ok1hra/oi3/README.md

# Open Interface III

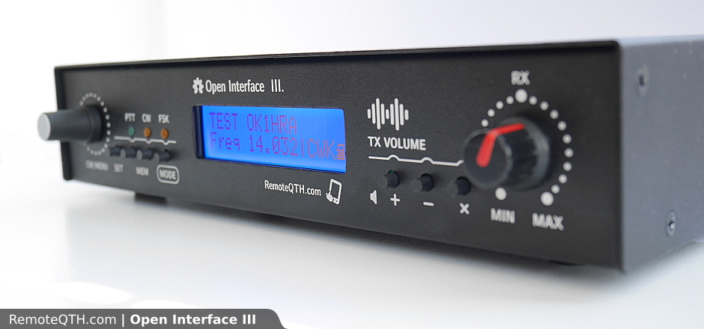
[picture p1: oi3.png]
Open Interface III


Firmware for **Open Interface III** — a station interface between PC and an
Icom-family transceiver (CAT, PTT/sequencer, CW/RTTY/FSK keying, optional
Ethernet/TrxNet networking). This document describes what the firmware
does, how the front-panel UI works, and what every menu item / config key
means.

> For the hardware itself (front/rear panel layout, DB25 wiring,
> schematics, jumpers, per-rig connector diagrams), see
> [doc/open-interface-iii.md](doc/open-interface-iii.md) — linked again at
> the bottom of this document.

## Contents

- [First boot](#first-boot)
- [Display](#display)
  - [Row 0 — menu / value / mode](#row-0--menu--value--mode)
  - [Row 1 — keyer TX echo + transient overlays](#row-1--keyer-tx-echo--transient-overlays)
- [Buttons](#buttons)
  - [Auto-repeat](#auto-repeat)
  - [Tones](#tones)
- [Menu navigation (FSM)](#menu-navigation-fsm)
  - [MODE button](#mode-button)
- [Menu items](#menu-items)
  - [RPI status](#rpi-status)
- [CI-V (Icom CAT)](#ci-v-icom-cat)
  - [CW over CI-V (CIV_CW_VIA_CIV)](#cw-over-ci-v-civ_cw_via_civ)
- [Kenwood CAT (TS-480)](#kenwood-cat-ts-480)
- [PTT, sequencer and interlock](#ptt-sequencer-and-interlock)
  - [Outputs](#outputs)
  - [Mode → output mapping](#mode--output-mapping)
  - [Sequencer timing](#sequencer-timing)
  - [Inputs](#inputs)
  - [Input-debug overlay](#input-debug-overlay)
  - [InterlockEnable=1 (safety mode)](#interlockenable1-safety-mode)
  - [InterlockEnable=0 (PTT-in mode)](#interlockenable0-ptt-in-mode)
- [Keyer (K3NG-derived, CW + RTTY/FSK)](#keyer-k3ng-derived-cw--rttyfsk)
  - [Paddle behaviour](#paddle-behaviour)
  - [PTT timing](#ptt-timing)
  - [CW decoder (paddle → LCD row 1)](#cw-decoder-paddle--lcd-row-1)
  - [TrxNet remote CW](#trxnet-remote-cw)
  - [Remote CW key server (Paddle2IP)](#remote-cw-key-server-paddle2ip)
  - [RTTY / FSK output](#rtty--fsk-output)
  - [Persistence](#persistence)
- [TrxNet (peer-to-peer LAN)](#trxnet-peer-to-peer-lan)
- [Ethernet](#ethernet)
- [SD card and `oi3.cfg`](#sd-card-and-oi3cfg)
- [EEPROM map](#eeprom-map)
- [Build / flash](#build--flash)
- [Hardware reference](#hardware-reference)

---

## First boot

Power-up sequence on the 16×2 LCD:

1. `FW <date>` banner (~0.5 s).
2. SD card status on row 1 — `loaded oi3.cfg`, `SD card missing`, or
   `SD init fail`. Missing SD just means the firmware boots with compiled
   defaults; nothing is broken.
3. If an Ethernet module is fitted: `Net-ID: NN` / `Eth: waiting…`, then
   either the assigned `IP address:` for ~1 s, or `Eth: no link` /
   `DHCP fail`.
4. Runtime view appears on row 0. Whatever menu item was active when you
   last powered off is restored (persisted in EEPROM). Row 1 is reserved
   for keyer TX text and transient WPM notifications.

The boot default CI-V mode is **CW** (0x03). As soon as the rig answers
CI-V polls, the rig's real mode takes over.

---

## Display

The display is a 16×2 character LCD. The two rows have separate jobs.

### Row 0 — menu / value / mode

```
HHHHHHHHHHHH|MMM
└─ value ──┘│└mode┘
         separator
```

- **Value field** (12 chars) — left-aligned, content depends on the
  current menu item (see [Menu items](#menu-items)).
- **Separator** (1 char) — encodes the menu FSM state:
  - `|` PINNED — value is displayed; DWN/UP edit live WPM.
  - `:` PINNED, and a Paddle2IP remote key is connected (`IPkey CONN`)
    with the rig in CW/CW-R — ready to be keyed remotely.
  - `<` BROWSING — DWN/UP step through menu items.
  - `=` EDITING — DWN/UP change the value of the current item.
- **Mode field** (3 chars) — current CI-V mode, **uppercase** when CI-V
  is alive (`LSB USB AM  CW  RTY FM  CWR RTR`), **lowercase** when the
  rig is silent and the value is the local fallback driven by the MODE
  button. `---` is shown only as a safety fallback if the mode byte is
  unknown.

### Row 1 — keyer TX echo + transient overlays

- During CW/RTTY transmission, every element that actually went on the
  air is echoed here (wrap mode — when col 16 is reached the row is
  cleared and writing restarts at col 0). Trailing spaces at the wrap
  edge are eaten so the row never starts with a space.
- Pressing DWN/UP in PINNED state changes WPM and briefly overlays
  `WPM NN` here for ~0.8 s — keyer chars from that window are dropped
  *from the LCD only* (the air output continues unaffected).
- The paddle decoder writes its decoded ASCII here too — so the LCD is
  a truthful log of what was keyed, whether by paddle, by USB host, or
  by a remote TrxNet peer.
- On SD / Ethernet boot stages, row 1 hosts the status banners.

---

## Buttons

Five physical inputs drive the UI:

| Button | Pin | Notes |
|---|---|---|
| SET | A1 (ADC) | Enter/leave BROWSING; long-press in BROWSING = EDIT  |
| DWN | A1 (ADC) | Decrement / previous item |
| UP | A1 (ADC) | Increment / next item |
| MODE | D36 | Rotate CI-V mode locally (only when CI-V is silent)  |
| FootSW | D19 | External PTT request (LOW = TX) |

SET / DWN / UP share one analog pin via a resistor divider. Decision
levels are the midpoints between measured raw ADC values (SET≈2,
DWN≈89, UP≈167):

| Button | Raw range |
|---|---|
| SET | `tmp < 46` |
| DWN | `46 < tmp < 128` |
| UP | `128 < tmp < 230` |

### Auto-repeat

In PINNED and EDITING states, holding DWN or UP for ≥700 ms starts a
3 Hz auto-repeat. BROWSING is **edge-only** — one menu step per press,
no auto-repeat (so you can't accidentally fly past the item you want).

### Tones

A short two-step tone sweep marks **BROWSING ↔ EDITING** transitions only:

- low → high (300 → 800 Hz) entering EDITING
- high → low (800 → 300 Hz) leaving EDITING (after save)

No tones for PINNED↔BROWSING, DWN/UP steps, or MODE rotation. The tone
generator (D4) is shared with the keyer sidetone with no mutex —
overlap is rare in practice and audibly harmless.

---

## Menu navigation (FSM)

The menu has three states. Only the SET button changes state; DWN/UP do
different things depending on which state you're in.

```
        ┌───────────────────────────────────────────┐
        │                                           │
        ▼                                           │
   ┌─────────┐  any SET   ┌────────────┐ short SET  │
   │ PINNED  │ ─────────► │  BROWSING  │────────────┘
   │   '|'   │            │    '<'     │  (or 30 s idle)
   │ DWN/UP  │            │ DWN/UP=    │
   │ = WPM   │            │ prev/next  │ long SET
   │ ± live  │            │            │ (if editable)
   └─────────┘            └────────────┘
                                 ▲ │
                       any SET   │ │
                       (save +   │ │
                        sweep)   │ ▼
                            ┌────────────┐
                            │  EDITING   │
                            │    '='     │
                            │  DWN/UP =  │
                            │  value ±   │
                            └────────────┘
```

Key rules:

- **Short vs. long SET** only matters in BROWSING. Long-press threshold
  is 800 ms; long-press in PINNED or EDITING has no special meaning.
- **PINNED → BROWSING** fires on the SET press edge.
- **BROWSING → PINNED** fires on the SET release edge **and persists the
  current menu index to EEPROM** (so the unit boots back into the same
  view).
- **BROWSING → PINNED** also happens automatically after **30 s of no
  button activity** in BROWSING — same EEPROM save. You can't get
  stranded inside the menu.
- **BROWSING → EDITING** fires on the long-press threshold while still
  held, but only if the current item is editable.
- **EDITING → BROWSING** saves the new value (to EEPROM for persisted
  items) and plays the high→low sweep. There is no cancel path — once
  you press SET in EDITING, the change is committed.
- Read-only items render a space between name and value; editable items
  in BROWSING/EDITING render `=` instead, as a visual hint that
  long-press will start editing.

### MODE button

`MODE` rotates the active CI-V mode locally through the cycle
`LSB → USB → AM → CW → RTY → FM → CWR → RTR → LSB`.

It is **only active while CI-V is silent** (`!CivValid`). Once the rig
is answering polls, the rig is the source of truth — pressing MODE
does nothing. This lets you operate sensibly with the rig powered off
(set CW to use the keyer dry, set RTY to route PTT to the DAT jack for
AFSK from the PC, etc.) without ever lying about the rig's real state.

---

## Menu items

27 items, indexed 0..26. Items 0..6, 23, 25 and 26 are read-only status; 7 is
browse-only (peer list); 8..22 and 24 are editable settings. The mode cell
on the right of row 0 is the same on every item. Items 25 and 26 also take
over row 1 while they are selected. Item 26 is skipped while browsing until
a WIFILT Raspberry Pi has been heard from.

| #  | Name | Example display | Editable | Range / values | Purpose |
|----|---|---|---|---|---|
| 0  | My call | `OK1HRA` | no | — (from cfg) | Operator callsign, set in `oi3.cfg`. |
| 1  | FW version | `FW 20260526` | no | — (compile-time) | Build date stamp. |
| 2  | IP high | `192.168.` | no | — / `no link` | First two octets of the assigned IP. |
| 3  | IP low | `1.220` | no | — / `no link` | Last two octets. Items 2+3 together = full IP. |
| 4  | Baud (CAT) | `baud 9600` | no | — (from cfg) | Serial2 baudrate used for CI-V. |
| 5  | CI-V addr | `CI-V 0x98` / `KENWOOD` | no | — (from cfg) | Configured radio address (0x98=IC-7610, 0x56=IC-746); `KENWOOD` with `BAND_DECODER_IN=2`. |
| 6  | Frequency | `14.074.0 kHz` | no | — / `---.---.- kHz` | Live rig frequency, 100 Hz resolution. Placeholder while `!CivValid`. |
| 7  | Peers | `Peers 2` / `Peers off` | browse | EDITING = walk peer list | Number of remote TrxNet peers, EDITING cycles through them showing `name .lastIP`. Priority peers (on `PriorityPrefixes`) show `*` instead of the `.` in the name (`705*01`). `off` = NET_ID=0 / no Eth. |
| 8  | Interlock | `Inter 1` | yes (not persisted) | 0 ↔ 1 | `1` = D2 is PA safety interlock; `0` = D2 is external PTT-in. See [PTT, sequencer and interlock](#ptt-sequencer-and-interlock). |
| 9  | SEQ lead | `SeqH 0ms` | yes (not persisted) | 0..9990 ms step 10 | Delay from SEQUENCER HIGH to PTTPA HIGH. |
| 10 | PA lead | `PAH 10ms` | yes (not persisted) | 0..9990 ms step 10 | Delay from PTTPA HIGH to PTT1/2/3 HIGH. |
| 11 | PTT lead | `PTTH 10ms` | yes (not persisted) | 0..9990 ms step 10 | Loaded from cfg, **currently unused** by the sequencer (kept for forward compat). |
| 12 | PTT tail | `PTTL 210ms` | yes (not persisted) | 0..9990 ms step 10 | Delay after TX-off before PTT1/2/3 LOW. |
| 13 | PA tail | `PAL 0ms` | yes (not persisted) | 0..9990 ms step 10 | Delay from PTT1/2/3 LOW to PTTPA LOW. |
| 14 | SEQ tail | `SeqL 0ms` | yes (not persisted) | 0..9990 ms step 10 | Delay from PTTPA LOW to SEQUENCER LOW. |
| 15 | PTT output | `PTT1` / `TX PTT3` / `PTT D3` | yes (not persisted) | 1, 2, 3 | Effective PTT pin for the **current CI-V mode**. `D3`=default output 3 is used (no mapping / CI-V silent), `TX `=sequencer active. Edit changes the per-mode slot in RAM (CI-V silent: `PTTmodeDefault`); `oi3.cfg` repopulates after reset. While editing, holding MODE keys the selected output for test — see [PTT output test](#ptt-output-test). The right edge of the value field also shows a live input-debug triplet `FIP` — see [Input-debug overlay](#input-debug-overlay). |
| 16 | WPM | `WPM 28` | yes | 5..50 step 1 | Keyer speed. Also editable via DWN/UP in PINNED. |
| 17 | Iambic mode | `Mode B` | yes | A ↔ B | Iambic A or B. |
| 18 | Paddle | `Pad N` / `Pad R` | yes | Normal ↔ Reverse | Swap dit/dah paddle assignment. |
| 19 | Sidetone | `Side 600Hz` / `Side off` | yes | 0 (off) or 300..1200 Hz step 10 | Keyer sidetone frequency. Crosses 300↔0 boundary. |
| 20 | RTTY baud | `RTY 45.45 Bd` | yes | 45, 50, 75, 100 | FSK Baudot rate (45 stored as 45 but clocked at 45.45 Bd). |
| 21 | FSK polarity  | `FSK N` / `FSK R` | yes | Normal ↔ Reverse | Invert MARK/SPACE drive levels on the FSK pin. |
| 22 | Debug | `Debug off` | yes (not persisted) | on ↔ off | Enable verbose serial logging (`[CIV freq=…]`, `[PTT…]`, etc). Off by default; init banners and errors always print. |
| 23 | UDP port | `UDP 5683` / `no net` | no | — (from cfg) | TrxNet UDP port (`UdpPort` in `oi3.cfg`). `no net` on boards without the network stack. |
| 24 | PTT output | `PTTout on` / `PTTout off` | yes (not persisted) | on ↔ off | PTT outputs enabled; always on after reboot. |
| 25 | Remote key | `IPkey CONN` / `IPkey DISC` / `IPkey off` | no | — | Remote CW key server link: `CONN` = a Paddle2IP session is sending (packet < 1 s ago, valid nonce), `DISC` = no client, `off` = `RkeyEnable=0` or no `RkeyKey`. While selected, **row 1** shows the elements actually played on CW1/CW2, newest on the right: `.` / `-` by mark length at the sender's WPM, space = letter gap, ` / ` = word gap, `*` = mark cut by an abort (link loss, interlock, …). Example: `-.-. --.- / -.-`. The keyer TX echo is paused on row 1 meanwhile. See [doc/remote-cw-key.md](doc/remote-cw-key.md). |
| 26 | RPI | `▂-62 Domov 🔒` / `RPI wait` | no | — | State of the Raspberry Pi running WIFILT + local-trx with this OI3 (TrxNet `/wl-host`). Uses **both rows** — see [RPI status](#rpi-status). |

### RPI status

Menu item 26 shows the state of a headless Raspberry Pi that runs WIFILT and
local-trx with this OI3 as local-trx's CAT/CW/PTT, so its state can be read
without a screen or a browser. WIFILT sends it over TrxNet (`/wl-host`, every
5 s and on every change, see TrxNet INTEGRATION.md §7.4); the OI3 stores
nothing.

```
 0123456789AB | MMM
 B-62 Domov L | USB    row 0: signal, dBm, SSID, lock
 192.168.1.23     H    row 1: the address to open in a browser, H = pulse
```

Row 0 (value field):

- col 0: signal bars (three levels), the AP mast when the Pi runs its setup
  hotspot, `?` when the data is more than 15 s old, blank when wired only;
- cols 1..3: dBm of the WiFi link, `AP ` in hotspot mode, `ETH` wired only;
- cols 5..10: the SSID (the hotspot's own name in AP mode), scrolling when
  longer than six characters;
- col 11: the lock. **Closed lock** (solid body, steady) = the Pi's file system
  is locked (fslock). **Open lock** (lifted shackle, hollow body, **blinking**)
  = fslock is installed but the system is unlocked. Blank = no fslock.

Row 1: the IP address, with a heart in the last column for 0.3 s after each
packet. When something is wrong it says so instead, with a running clock:

| Row 1 | Meaning |
|---|---|
| `waiting for RPI` | nothing heard since this OI3 started |
| `UPDATE 45%` | a web update is running; `UPDATE  1:20` while the Pi is dark during it |
| `RESTART 0:07`  | WIFILT is restarting itself (Save & Restart) |
| `WIFILT STOP 0:12`| the WIFILT service was stopped |
| `RPI REBOOT 0:45` | the Pi is rebooting or shutting down |
| `RPI OFFLINE 3:05`| no packet for 15 s (3 min after a restart/reboot, 10 min during an update) |
| `local-trx off` / `TRX not linked` | alternate with the address every 2 s: local-trx is gone from TrxNet / WIFILT's radio slot to local-trx is not connected |

CW or RTTY text sent by the keyer still appears on row 1: the first
character replaces the Pi's state, and the state comes back 2 s after the
transmission ends (PTT down, nothing queued). WPM and TUNE overlays keep
priority as on every other item.

Items 16..21 are persisted to EEPROM on the EDITING→BROWSING transition.
Items 7, 8..15 and 22 are intentionally **not** persisted — sequencer
timings and PTT mapping are config-driven (`oi3.cfg` repopulates them on
reset), debug is per-session, and peer-browse position is live-only.

The PINNED-state WPM live edit uses a separate 5 s debounced flush, so
rapid up/down changes don't burn EEPROM cells.

---

## CI-V (Icom CAT)

The firmware talks to the rig over Icom CI-V on Serial2 (TTL level
shifted by the OI3 hardware). Baudrate and rig address come from
`oi3.cfg` (`SERBAUD2`, `CIV_ADRESS`).

**What the firmware does:**

- Polls the rig every 2 s (slow) for frequency (cmd 0x03), then chains
  a mode request (0x04). After any local SET (freq/mode change
  initiated via TrxNet or keyer), it switches to a 200 ms fast-poll
  window for 10 s so you see the change reflected immediately.
- Sniffs the bus passively too — transceive broadcasts (cmd 0x00) and
  our own outgoing SET echoes (cmd 0x05) both update the local cache.
- For IC-7610 (address 0x98), prepends a `0x07 0xD2 0x00` "MAIN band
  select" sub-command before every set, because dual-receive otherwise
  targets VFO B. Other models NAK this and aren't affected.
- A 10 s watchdog clears `CivValid` if no parsed frame arrives — at
  which point the display switches to lowercase mode letters and the
  MODE button starts working again.

**Why CivValid matters:**

`CivValid` is the single source-of-truth flag. It controls:

- LCD mode field uppercase (rig authoritative) vs lowercase (local
  fallback).
- Whether the MODE button rotates CivMode (only when `!CivValid`).
- Whether the PTT output mapping uses the per-mode slot
  (`PttOutByCivMode[CivMode]`) or falls back to `PTTmodeDefault`.

This lets you keep operating coherently when the rig is off, on
standby, or wired to a different cable.

### CW over CI-V (CIV_CW_VIA_CIV)

> **Reserved / not yet implemented.** The `CIV_CW_VIA_CIV` flag is parsed
> from `oi3.cfg` but currently has no effect: CW is **always** keyed
> locally via the CW1/CW2 pins and the PTT sequencer, regardless of the
> flag's value. The intended future behaviour is that `CIV_CW_VIA_CIV=1`
> would feed decoded characters to the radio's built-in keyer via CI-V
> command 0x17 (bypassing CW1/CW2 and the sequencer).

---

## Kenwood CAT (TS-480)

`BAND_DECODER_IN=2` replaces the CI-V backend with the Kenwood PC-command
protocol (ASCII, `;`-terminated) on the same Serial2 / `SERBAUD2`
(`CIV_ADRESS` is ignored). Code: `kenwood.ino`. Set the rig's COM speed
(menu 56) to the same rate as the logger and `SERBAUD2`; at 4800 bps the
port runs with 2 stop bits as the TS-480 requires.

**Shared line with a PC / logger.** OI3 RX listens to the rig's TXD, so it
sees every answer the rig gives to the logger. OI3 TX is merged into the
rig's RXD together with the PC's TX (the merge itself is a hardware
matter — diode-OR / gate, not done by the firmware). Therefore OI3 is a
passive sniffer first:

- Every `IF`, `FA`/`FB` (only the current RX VFO), `FR` and `MD` answer on
  the line updates frequency / mode, whoever asked for it — logger poll,
  AI auto-information or OI3 itself.
- Only when no frequency/mode data came for **2 s** *and* the line has been
  silent for **100 ms** (not in the middle of a logger transaction) does
  OI3 send `IF;` itself, at most once per 2 s. A logger that polls
  `IF`/`FA`/`MD` keeps OI3 completely silent on the line.
- In split, while transmitting, the `IF` frequency (= TX VFO) is ignored so
  `/hz` does not bounce between the VFOs on every over.
- Same 10 s watchdog as CI-V (`CivValid`), same uppercase/lowercase LCD
  mode cell and MODE-button behaviour.

Modes are translated to the CI-V codes used everywhere else (PTT mapping
`PTTmode*`, keyer, TrxNet `/mode`):

| TS-480 `MD` | 1 LSB | 2 USB | 3 CW | 4 FM | 5 AM | 6 FSK | 7 CW-R | 9 FSK-R |
|---|---|---|---|---|---|---|---|---|
| CI-V | 0x00  | 0x01  | 0x03 | 0x05 | 0x02 | 0x04  | 0x07 | 0x08 |

TrxNet `/s-hz` → `FA…;` (or `FB…;` on VFO B, nothing in memory mode),
`/s-mode` → `MD…;`, each followed by `IF;` so the change comes back through
the sniffer and is re-published. Sets wait (max 150 ms) for a quiet gap.

**Low-power TUNE** (MODE button / `/s-lptune`) uses the rig's own
`TX2;` (TX Tune transmission — reduced-power carrier): no mode or power
change, `TunePower` / `TuneRestoreFallback` / `TuneSettleMs` are unused. The
sequencer brings up only SEQ + PA (PTT1/2/3 stay down — the rig keys
itself), `TX2;` follows after `PAlead`, and at the end `RX;` is sent and
confirmed via `IF` (one retry; a low 400 ms tone warns if the rig never
confirmed RX). LCD row 1 shows `TUNE CAT`.

---

## PTT, sequencer and interlock

### Outputs

| Pin (MCU) | DB25 pin | Connector / signal | Typical use |
|---|---|---|---|
| PTT1 (D41) | 8 | REMOTE miniDIN (DATA-IN audio OFF) | FSK / RTTY |
| PTT2 (D22) | 20 | DATA miniDIN (MIC-IN audio OFF) | DIGI / AFSK |
| PTT3 (D25) | 22 | MIC | SSB / CW |
| PTTPA (D31) | — | rear RCA + DB25 pin 7 | External PA |
| SEQUENCER (D40)  | — | rear RCA | Shared sequencer line  |

### Mode → output mapping

The PTT pin used depends on the current CI-V mode. Each mode has its
own slot in `oi3.cfg`:

```
LSB/USB/AM/CW/FM/CWR  →  PTT3 (MIC)
RTTY/RTR              →  PTT1 (REM, audio muted on rig side)
unknown / CIV silent  →  PTTmodeDefault (default 3)
```

Why: a PA needs to see a clean PTT regardless of mode; a SSB rig needs
PTT on the MIC connector with mic audio enabled; for FSK/RTTY you want
PTT on the REM/DAT jack where the rig is set to ignore microphone
audio so a stray cough on the headset doesn't end up on the air. The
mapping is set in `oi3.cfg` once; menu item 15 shows the *effective*
PTT for the current mode and lets you change the slot on the fly (RAM
only — it goes back to cfg on reset).

### PTT output test

In menu item 15 EDITING (long-press SET, value shows `PTT=n`), UP/DWN
selects the output and **holding MODE keys it** for as long as the button
is held — the MODE button neither rotates the mode nor starts TUNE there.
The test is one more sequencer source, so it runs the normal sequence
(SEQ → PA → selected PTT1/2/3 with the configured lead/tail delays) and
the value shows `TX PTT=n` while the sequencer is up. It is refused (low
beep) with PTT output off (item 24) or with the interlock asserted; the
output cannot be changed while the test is held, and leaving EDITING
with SET drops it. Serial debug prints `[PTT TEST on/off]` plus the
usual `[PTT…]` sequence.

### Sequencer timing

The sequencer is a 6-level non-blocking state machine. Menu items 8..14
expose its timings in the same order as the runtime switching sequence.
These edits are live only; on reset the values are loaded again from
`oi3.cfg`.

| LCD item | Cfg value | Meaning |
|---|---|---|
| `Inter`  | `InterlockEnable` | `1` = D2 is PA interlock, `0` = D2 is external PTT input |
| `SeqH` | `SEQUENCERlead` | Delay after `SEQUENCER` HIGH before `PTTPA` HIGH |
| `PAH` | `PAlead` | Delay after `PTTPA` HIGH before selected `PTT1/2/3` HIGH |
| `PTTH` | `PTTlead` | Loaded and editable, but currently not used by the sequencer |
| `PTTL` | `PTTtail` | Delay after TX request ends before selected `PTT1/2/3` LOW |
| `PAL` | `PAtail` | Delay after selected `PTT1/2/3` LOW before `PTTPA` LOW |
| `SeqL` | `SEQUENCERtail` | Delay after `PTTPA` LOW before `SEQUENCER` LOW |

Typical TX start sequence:

```text
TX request
   |
   v
SEQUENCER  LOW  ___|-------------------------------- HIGH
                    <----------- SeqH ------------>
PTTPA      LOW  __________________|---------------- HIGH
                                    <--- PAH ---->
PTT1/2/3   LOW  _______________________________|--- HIGH
```

Typical TX release sequence:

```text
TX request released
   |
   v
PTT1/2/3   HIGH ----------------|__________________ LOW
                         < PTTL >
PTTPA      HIGH -------------------------|__________ LOW
                                  < PAL >
SEQUENCER  HIGH --------------------------------|___ LOW
                                           < SeqL >
```

Full phase order:

```text
TX ON:
  SEQUENCER HIGH -> wait SeqH -> PTTPA HIGH -> wait PAH -> PTT1/2/3 HIGH

TX OFF:
  wait PTTL -> PTT1/2/3 LOW -> wait PAL -> PTTPA LOW -> wait SeqL -> SEQUENCER LOW
```

Why this matters: external relays/PAs need time to settle before RF
appears. `SeqH` raises the shared sequencer line first (drives external
T/R relays); `PAH` then enables the PA; only then is the rig's own PTT
asserted. On release, PTT drops first, the PA gets time to dump
residual envelope, then the sequencer line releases. Tune to your
relay/PA characteristics.

### Inputs

| Input | Pin | Idle | Active | Behaviour |
|---|-----|---|---|---|
| FootSW | D19 | HIGH (pullup) | LOW | External foot-switch PTT request. |
| PTT232 | D3  | LOW | HIGH | PTT from the USB/serial-port interface. |
| INTERLOCK | D2  | (see below) | edge | Dual behaviour — see below. |

### Input-debug overlay

Menu item 15 (PTT output) shows a live three-character input-debug
triplet at the right edge of the value field, just left of the `|`
separator (e.g. `PTT=2    fiP|USB`). Each character is one input;
**upper-case = active, lower-case = idle**:

| Char | Input | Upper-case (active) when… |
|---|---|---|
| `F`  | FootSW | switch pressed (D19 LOW = TX) |
| `I`  | INTERLOCK| raw D2 level LOW (pulled — regardless of `InterlockEnable`) |
| `P`  | PTT232 | D3 HIGH (= TX) |

`I` reflects the **raw pin level**, not the derived interlock/abort
logic, so it stays useful for tracing wiring and contact bounce in
either interlock mode. The triplet refreshes every `LCD_TICK_MS`
(30 ms) and only appears on item 15; all other menu items render
normally.

### InterlockEnable=1 (safety mode)

D2 is treated as a safety interlock from the PA. On every edge, an
`abort` flag toggles. While active, the sequencer is forced to level 0
immediately (all PTT/PA/SEQ lines dropped). Use this when your PA
exposes a fault-out line that should slam the transmit chain shut.

### InterlockEnable=0 (PTT-in mode)

D2 becomes another PTT input (LOW = TX), but with a twist: the
sequencer **stops at level 4** — SEQUENCER + PTTPA are raised, but the
local PTT1/2/3 pin is left LOW. Use this when an upstream system (e.g.
a remote PTT distributor) already drives PTT into the rig itself; OI3
only sequences the PA around it.

---

## Keyer (K3NG-derived, CW + RTTY/FSK)

The keyer is a port of the K3NG iambic keyer with extensions for RTTY,
TrxNet remote sending, and integration with the OI3 PTT sequencer.

### Paddle behaviour

- Paddles are always live. Pressing a paddle produces sidetone (subject
  to item 19) and runs the ASCII decoder regardless of CI-V mode.
- Mode determines whether the element also drives a TX path:
  - **CW / CWR (0x03 / 0x07):** paddle keys CW1/CW2 via the sequencer.
    (`CIV_CW_VIA_CIV` is reserved / not yet implemented — see above.)
  - **RTTY / RTR (0x04 / 0x08):** paddle elements still produce
    sidetone in your ear, but the decoded **characters** are enqueued
    to the RTTY FSK state machine instead of being keyed as CW.
  - **LSB / USB / AM / FM, or `!CivValid`:** sidetone + LCD echo only,
    no TX path activated.
- Touching a paddle flushes any pending `/s-cw` send buffer received
  from a TrxNet peer — paddle has priority.

### PTT timing

The first element of a CW transmission **defers until the sequencer
reaches `SequencerLevel == PttOut`** (i.e. SEQ + PA are already raised
and the rig PTT is asserted). After the last element, the keyer holds
PTT until 7 dit-lengths of silence have passed (CW) or until the RTTY
state machine finishes its stop-bit + idle window (RTTY). The K3NG
PTTlead/PTTtail constants were removed — the sequencer alone owns PTT
timing, so there is exactly one place that decides when the rig
transmits.

### CW decoder (paddle → LCD row 1)

Each completed element is accumulated as a decimal number (1=dit,
2=dah). On a letterspace timeout (3-dit silence), the firmware looks
the number up in a table and writes the resulting ASCII char to LCD
row 1. On a wordspace (7-dit silence) it writes a space. Unknown
sequences print `*` (K3NG convention). The table includes prosigns:
`=` (BT), `+` (AR), `(` (KN), `&` (SK), `*` (BK).

### TrxNet remote CW

The keyer subscribes to TrxNet topic `/s-cw`. Any peer can push CW text
to the OI3 and it will be:

- Played as Morse through the local CW1/CW2 + sequencer **if** mode is
  CW/CWR.
- Encoded as Baudot and clocked out on the FSK pin **if** mode is
  RTY/RTR.
- Dropped (sidetone only) in other modes.

A single-byte payload of `0x03` (ETX) or `0xFF` aborts the in-flight
send and flushes the buffer — useful for remote "stop sending" buttons.

### Remote CW key server (Paddle2IP)

With `RkeyEnable=1` the OI3 also works as the server for a
[Paddle2IP](https://github.com/ok1hra/paddle2ip) remote paddle (M5Stack Dial
with a paddle, local keyer and sidetone). Paddle2IP sends the key edges with
its own timestamps over UDP (port `RkeyPort`, signed with `RkeyKey`), and the
OI3 replays them on CW1/CW2 through the sequencer with a fixed playout delay,
so the element lengths on air are exact regardless of network jitter. Keying
happens only in CW/CWR, without interlock and without a tune in progress;
while a remote stream is active the local paddle is sidetone-only.
Configuration, behaviour and test tools: [doc/remote-cw-key.md](doc/remote-cw-key.md).

### RTTY / FSK output

FSK output is on D23. **Idle = HIGH-Z** (the pin is set to `INPUT`);
the keyer drives it as an `OUTPUT` only during an active TX session.
This is deliberate — the OI3 FSK keying circuit interprets *any*
active MCU drive (HIGH or LOW) as keyed, so floating the pin between
sessions is the only correct idle. During TX:

- Start bit: SPACE
- 5 data bits: LSB first (Baudot 5-bit code)
- Stop: MARK, 1.5 bit-times
- Pin released back to HIGH-Z after 7-dit silence (handled by
  `ptt_tail_service`).

`KeyerFskReverseNow` (item 21) inverts MARK/SPACE drive polarity for
rigs/cables that expect the opposite sense. It does **not** affect the
idle release behaviour.

Baud rate (item 20) cycles through 45, 50, 75, 100 — `45` is clocked at
the standard 45.45 Bd (22 ms per bit), the others at exactly the named
rate.

### Persistence

Keyer settings live in EEPROM at addresses 1..7:

| Addr | Setting |
|---|---|
| 1 | WPM |
| 2 | Iambic mode (0=A, 1=B) |
| 3 | Paddle reverse |
| 4-5  | Sidetone Hz (16-bit) |
| 6 | RTTY baud |
| 7 | FSK polarity |

EEPROM > cfg on boot — `oi3.cfg` is only consulted if the EEPROM cell
still holds `0xFF` (factory-fresh). PINNED-state WPM edits use a 5 s
debounced flush; menu EDITING-state changes are saved immediately on
SET.

---

## TrxNet (peer-to-peer LAN)

TrxNet is a small UDP-based pub/sub protocol that lets multiple
OI3-class devices in a hamshack share state without a central server.
Each device announces itself as `OI3.NN` (where NN is `NET_ID` in hex)
and discovers peers on the LAN.

**Topics published by OI3:**

| Topic | Payload | When sent |
|---|---|---|
| `/hz` | `uint32_t` Hz | On every CivFreq change  |
| `/mode` | `uint8_t` CIV mode byte  | On every CivMode change  |
| `/lptune` | `uint8_t` state | Low-power TUNE state: `0` idle (restored), `1` carrier up, `2` refused, `3` aborted |
| `/ptt`  | `uint8_t` `1` / `0` | To the `/s-ptt` holder only: `1` keyed, `0` released or refused |

**Topics subscribed by OI3 (peers can drive us):**

| Topic | Payload | Action on receive |
|---|---|---|
| `/s-hz` | `uint32_t` Hz | Set rig frequency via CI-V. |
| `/s-mode` | `uint8_t` mode | Set rig mode via CI-V. |
| `/s-cw` | ASCII bytes | Enqueue for CW or RTTY send (see Keyer). |
| `/s-cw` | `0x03` or `0xFF` | Abort current CW/RTTY send and flush buffer. |
| `/s-lptune` | `uint8_t` `1` / `2` / `0` / `3` | Low-power TUNE: `1` start, `2` keepalive, `0` stop, `3` query state (see below). |
| `/s-ptt`  | `uint8_t` `1` / `0` | Remote PTT lease: `1` key / renew (every ≤ 500 ms), `0` release (see below). |
| `/wl-host` | 11 + n bytes | State of the WIFILT Raspberry Pi for menu item 26 ([RPI status](#rpi-status); since FW 20261112). |

When a new peer joins, OI3 sends it a CON snapshot of its current
`/hz`, `/mode` and `/lptune` — but only after CI-V is known (i.e. either the rig
has answered at least once, or the local fallback has been set). The
greeting queue is drained one peer per loop iteration to avoid bursts.

**Low-power TUNE over TrxNet:** `/s-lptune 1` runs the same action as the
MODE button while CI-V is live — CW mode, `TunePower` %, sequencer PTT up,
solid carrier on CW1/CW2, then power, mode and filter restored — for a peer
that tunes an amplifier (the WIFILT PA palette's TUNE+). The carrier stays up
until `/s-lptune 0`, but only while `/s-lptune 2` keepalives keep arriving:
none for `TuneKeepaliveMs` (default 2500 ms) and it drops, so a peer that
crashed cannot leave the rig keyed. `TuneMaxMs` still caps it. A keepalive
never starts a tune — one still in flight after an abort must not key the
rig again. `/lptune` reports progress; `2` means the start was refused because
something else was transmitting (same rule as the MODE button). While the tune
runs, `/s-hz` and `/s-mode` are held and applied after the restore, and `/s-cw`
text is dropped rather than sent after the carrier. The `/lptune` greeting — or
the answer to `/s-lptune 3`, for a peer that restarted and so got no greeting —
is how a peer learns this firmware supports it.

**Remote PTT over TrxNet:** `/s-ptt 1` keys the sequencer for a peer that
sends the audio itself — local-trx in wifilt, with JS8 or WSPR audio from a PC
sound card while this keyer holds the radio's PTT. It is a lease: the peer
repeats `1` every 300 ms and PTT drops 1.5 s after the last one, so a peer
that crashed or lost the network cannot leave the rig keyed; `0` releases at
once. The first peer to key holds it until release, others are ignored. It is
refused — `/ptt 0` — while anything else transmits (a CW send, a tune,
Paddle2IP, the interlock) or with PTT output off (menu item 24); `/ptt 1`
confirms. A tune is refused while a peer holds the lease. Since FW 20261031,
TrxNet 1.08 (it tells two peers on one PC apart by port). See TrxNet
INTEGRATION.md §7.3.

Menu item 7 shows the live peer count. Long-press SET in BROWSING on
item 7 enters a special "browse" mode where DWN/UP walk the peer list
showing `name .lastIP` for each — useful for confirming exactly which
remote stations are talking to you.

**Disable:** set `NET_ID=00` in `oi3.cfg`. Item 7 will then display
`Peers off`. TrxNet also requires Ethernet — it stays in waiting state
until link is up and re-attempts `begin()` on link-up, so plugging the
cable after boot works without a reset.

**Priority peers:** the peer table holds a limited number of stations
(8 on this board). When it fills, TrxNet evicts the *stalest* peer to
make room for a newcomer. `PriorityPrefixes` in `oi3.cfg` (default
`705 ANT ROT`) protects the stations that matter: any peer whose name
starts with one of the listed prefixes (`705.01`, `ANT.01`, `ROT.1`, …)
is never evicted for a non-priority newcomer. The list is a
space-separated set of up to 6 prefixes (7 chars each); an empty value
turns the protection off. Requires the TrxNet library ≥ 1.04. While
browsing the peer list (menu item 7 EDITING), priority peers are shown
with a `*` in place of the `.` in their name (`705*01`).

All nodes must share the same **UDP port** (`UdpPort`, default `5683`) to
see each other. Setting a different port on a group of nodes creates a
second, isolated TrxNet network on the same LAN.

---

## Ethernet

Optional. The W5100/W5500 module is detected at boot via the `ETHINST`
pin pulled low when a module is fitted. If absent the firmware logs
`ETH module n/a` and skips all networking.

- `EthernetEnable=0` in cfg disables Ethernet even when the module is
  present (useful for benchwork without a LAN).
- `EthernetDHCP=1` uses DHCP; `=0` uses the static defaults
  `192.168.1.220 / .1 / 255.255.255.0 / 8.8.8.8`.
- The MAC address is `DE:AD:BE:EF:FE:(0xFF - NET_ID)` — derived from
  NET_ID so multiple OI3s on the same LAN don't collide.
- Link is monitored every 1 s. A link that comes back keeps the address
  it had (unplug/replug, or the switch / Raspberry Pi on the other end
  rebooting); DHCP runs again only while the unit has no address, then
  every 15 s. Each DHCP exchange is capped at 3 s and lease renewals back
  off for 15 s after a failure: DHCP blocks the whole firmware (LCD, keyer,
  TrxNet), and the library's 60 s default froze the unit for as long as a
  rebooting WIFILT Pi -- its DHCP server -- took to come back (since FW
  20261113). TrxNet starts once there is an address.

The boot LCD shows the assigned IP for ~1 s. After that, items 2 and 3
of the menu hold the same information — pin item 2 (or 3) and you have
a permanent reminder of where the unit is reachable.

---

## SD card and `oi3.cfg`

A microSD card is optional. At boot the firmware looks for
`/oi3.cfg` and reads `[KEY=VALUE]` pairs into runtime defaults. If the
card is missing, missing the file, or failing to init, the firmware
logs the reason on row 1 for 1 s and proceeds with compiled defaults.

Configuration keys (from `readSDSettings()`):

| Key | Default | Type / range | Notes |
|---|---|---|---|
| `NET_ID` | `02` | hex byte, `00` disables | TrxNet identity. MAC = `DE:AD:BE:EF:FE:(0xFF - NET_ID)`. |
| `YOUR_CALL` | `OK1HRA` | string | Shown on menu item 0. |
| `InterlockEnable` | `1` | 0 / 1 | 1 = safety interlock from PA; 0 = D2 is PTT-in. |
| `SEQUENCERlead` | `0` ms | int ms | Delay from SEQ HIGH to PA HIGH. |
| `SEQUENCERtail` | `0` ms | int ms | Delay from PA LOW to SEQ LOW. |
| `PAlead` | `10` ms | int ms | Delay from PA HIGH to PTT HIGH. |
| `PAtail` | `0` ms | int ms | Delay from PTT LOW to PA LOW. |
| `PTTlead` | `10` ms | int ms | (Reserved — sequencer owns PTT timing now.) |
| `PTTtail` | `210` ms | int ms | Hold PTT this long after last element. |
| `PTTmodeLSB` | `3` | 1 / 2 / 3 | CIV 0x00 → PTT slot. |
| `PTTmodeUSB` | `3` | 1 / 2 / 3 | CIV 0x01 → PTT slot. |
| `PTTmodeAM` | `3` | 1 / 2 / 3 | CIV 0x02 → PTT slot. |
| `PTTmodeCW` | `3` | 1 / 2 / 3 | CIV 0x03 → PTT slot. |
| `PTTmodeRTTY` | `1` | 1 / 2 / 3 | CIV 0x04 → PTT slot. |
| `PTTmodeFM` | `3` | 1 / 2 / 3 | CIV 0x05 → PTT slot. |
| `PTTmodeCWR` | `3` | 1 / 2 / 3 | CIV 0x07 → PTT slot. |
| `PTTmodeRTR` | `1` | 1 / 2 / 3 | CIV 0x08 → PTT slot. |
| `PTTmodeDefault` | `3` | 1 / 2 / 3 | Fallback when CIV silent / mode unknown. |
| `BAND_DECODER_IN` | `1` | 0 / 1 / 2 | 0 = no CAT; 1 = ICOM CI-V; 2 = Kenwood TS-480 (see [Kenwood CAT](#kenwood-cat-ts-480)). Other values → 0. |
| `SERBAUD2` | `9600` | bps | Serial2 baudrate (rig CAT). |
| `CIV_ADRESS` | `98` (hex)  | hex byte | `56`=IC-746, `98`=IC-7610, etc. |
| `CIV_CW_VIA_CIV` | `0` | 0 / 1 | **Reserved / not implemented** — parsed but ignored; CW is always keyed locally via CW1/CW2 + sequencer. |
| `EthernetEnable` | `1` | 0 / 1 | Master Ethernet switch. |
| `EthernetDHCP` | `1` | 0 / 1 | 1 = DHCP, 0 = static. |
| `UdpPort` | `5683` | 1..65535 | TrxNet UDP port. Change to run separate, isolated TrxNet networks on one LAN. Requires reset; out-of-range values keep the default. |
| `KeyerDefaultWpm` | `28` | 5..50 | Default WPM. EEPROM overrides if not `0xFF`. |
| `KeyerMode` | `B` | `A` / `B` | Iambic mode. |
| `KeyerPaddleReverse`  | `0` | 0 / 1 | 1 = swap dit/dah paddles. |
| `KeyerSidetoneHz` | `600` | 0 or 300..1200 | 0 = sidetone off. |
| `KeyerRttyBaud` | `45` | 45 / 50 / 75 / 100 | 45 is clocked at 45.45 Bd. |
| `KeyerFskReverse` | `0` | 0 / 1 | 1 = invert MARK/SPACE polarity. |
| `PriorityPrefixes` | `705 ANT ROT` | space-sep list | TrxNet peers kept when the peer table fills. Prefix-matched from the start of the device name (`705.01`/`ANT.01`/`ROT.1`); max 6 prefixes × 7 chars; empty = feature off. Requires TrxNet ≥ 1.04. |

Cfg syntax — one key per line, both sides bracketed, free comment after
the closing bracket:

```
[KeyerSidetoneHz=600] free comment ignored by parser
```

The parser tolerates extra whitespace and silently ignores unknown
keys.

---

## EEPROM map

| Addr | Owner | Purpose |
|---|---|---|
| 0 | LCD | Last menu index (PINNED snapshot) |
| 1 | KEYER | WPM |
| 2 | KEYER | Iambic mode (0=A, 1=B) |
| 3 | KEYER | Paddle reverse (0/1) |
| 4 | KEYER | Sidetone Hz, low byte |
| 5 | KEYER | Sidetone Hz, high byte |
| 6 | KEYER | RTTY baud |
| 7 | KEYER | FSK polarity (0/1) |

Factory-fresh cells (`0xFF`) cause the boot loader to use the cfg
defaults instead. To "reset to cfg" without erasing the chip, write
`0xFF` into the relevant cell from any sketch.

---

## Build / flash

The firmware is an Arduino sketch targeting **ATmega2560** (Arduino
Mega 2560 board profile). Required libraries:

- `LiquidCrystal` (stock Arduino)
- `SD` (stock Arduino)
- `Ethernet` (stock Arduino — works with both W5100 and W5500)
- `EEPROM` (stock Arduino)
- `TrxNet` (in `/home/dan/Arduino/libraries/TrxNet`)

Open `oi3.ino` in the Arduino IDE, select *Arduino Mega 2560*, the
correct serial port, and upload. Pre-built `.hex` files
(`oi3.ino.mega.hex`, `oi3.ino.with_bootloader.mega.hex`) are also
shipped in the repository and can be flashed with `avrdude`:

```sh
avrdude -p atmega2560 -c wiring -P /dev/ttyUSB0 -b 115200 -D -U flash:w:oi3.ino.mega.hex:i
```

ICSP variant with effusion setting:

```sh
avrdude -P /dev/ttyUSB.icsp -b 19200 -c arduino -p m2560 -U flash:w:/home/dan/oi3.ino.with_bootloader.mega.hex -U efuse:w:0xFD:m -U hfuse:w:0xD8:m -U lfuse:w:0xFF:m
```

---

## Hardware reference

For pinouts, schematics, front/rear panel layout, DB25 wiring, jumpers,
and connector diagrams for specific transceivers (FT-1000MP, FT-2000,
IC-706MkIIG, IC-7610, KX3, TS-480, TS-590), see:

**→ [doc/open-interface-iii.md](doc/open-interface-iii.md)**
