ok1hra/oi3/doc/img/wiki-open-interface-3-05.png

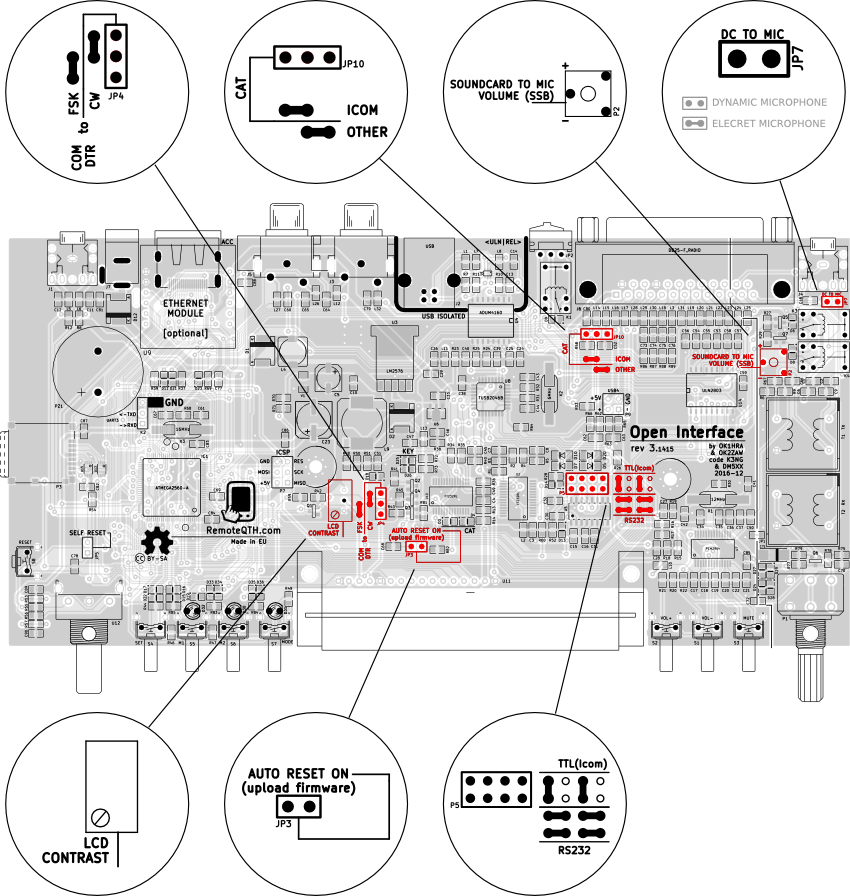
doc/img/wiki-open-interface-3-05.png
