ok1hra/oi3/doc/img/wiki-open-interface-3-10.png

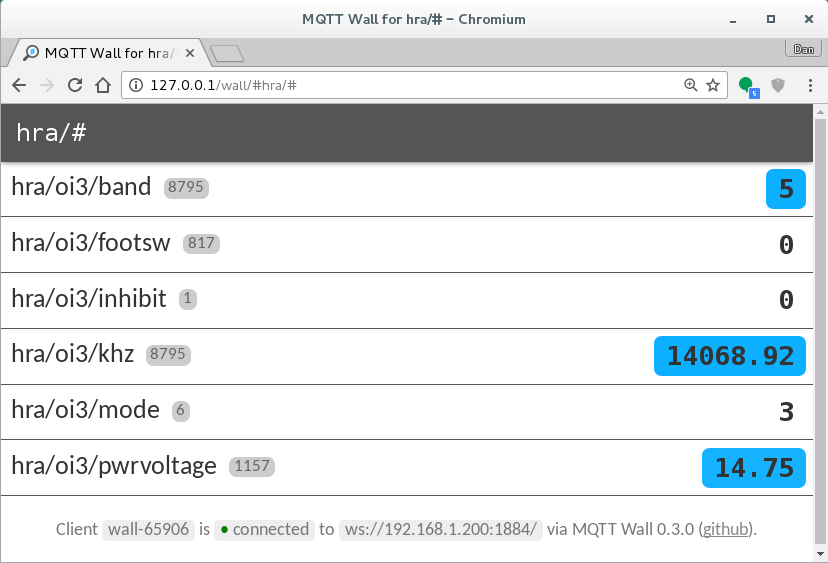
doc/img/wiki-open-interface-3-10.png
