ok1hra/oi3/doc/img/wiki-open-interface-3-n1mm.png

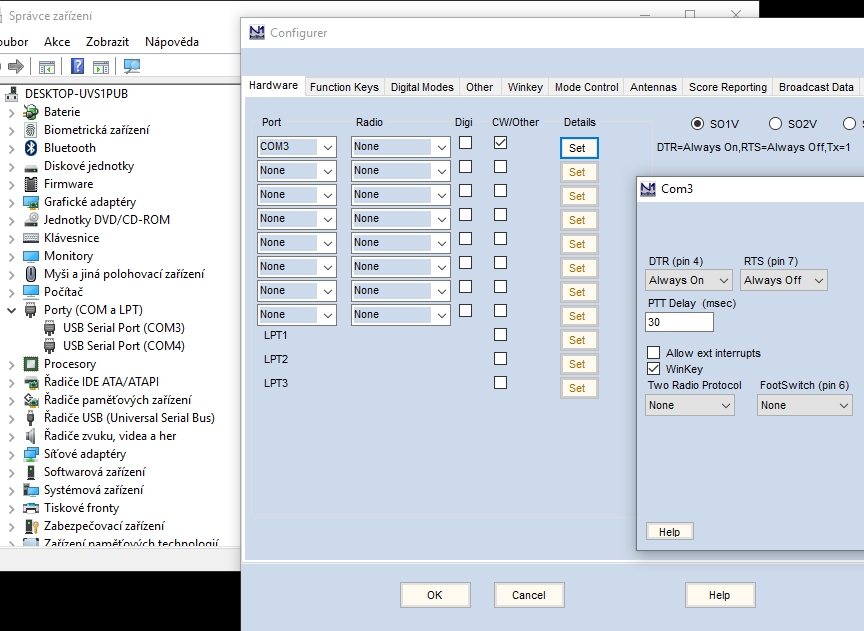
doc/img/wiki-open-interface-3-n1mm.png
