ok1hra/oi3/doc/img/wiki-open-interface-3-wintest.png

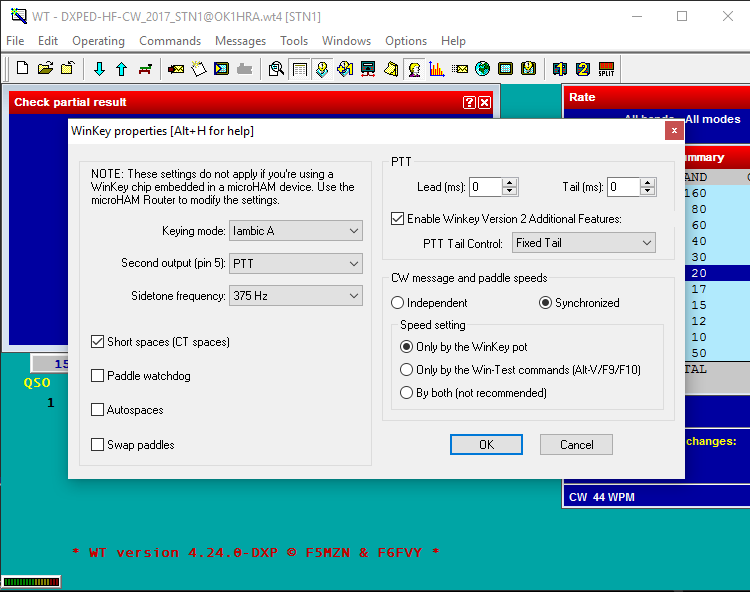
doc/img/wiki-open-interface-3-wintest.png
