ok1hra/oi3/doc/hw/openinterface3-ft1000mp.pdf

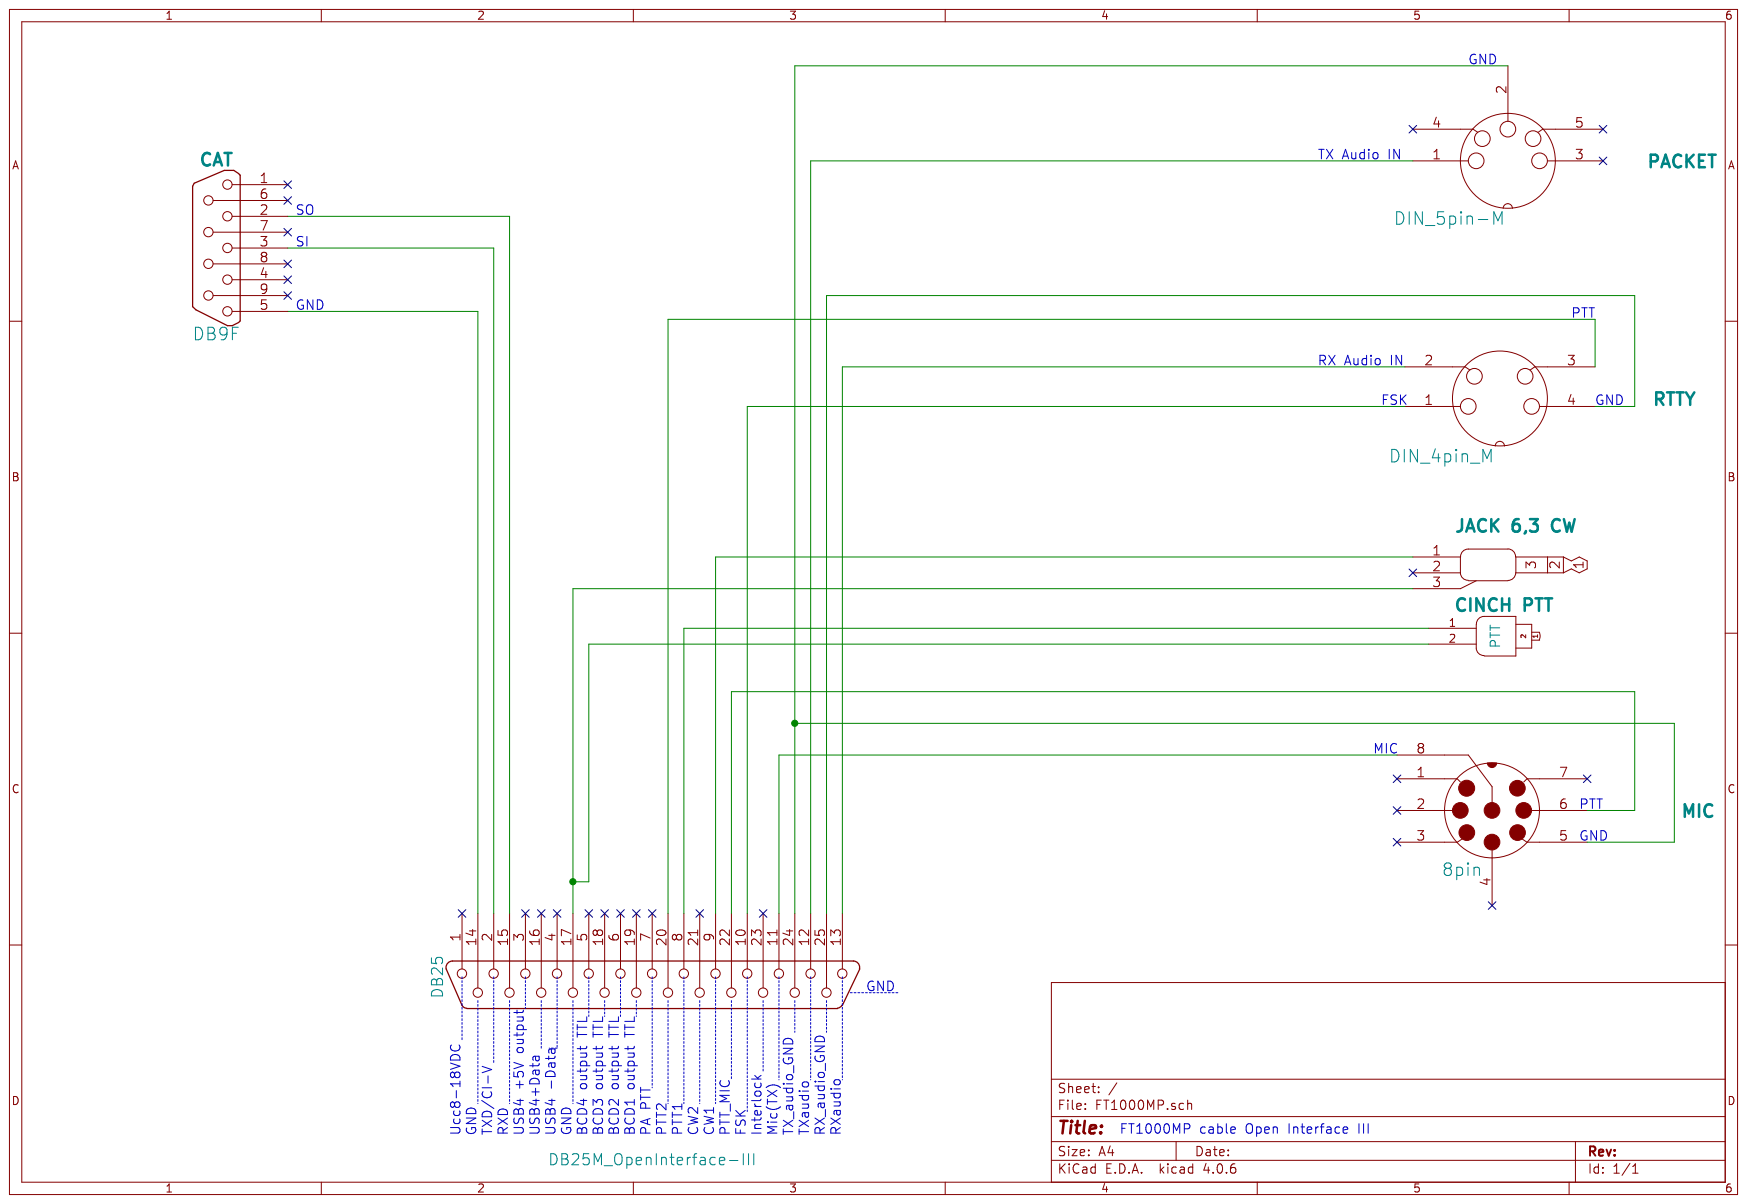
[picture p14: page 1]
