ok1hra/oi3/doc/hw/openinterface3-ft2000.pdf

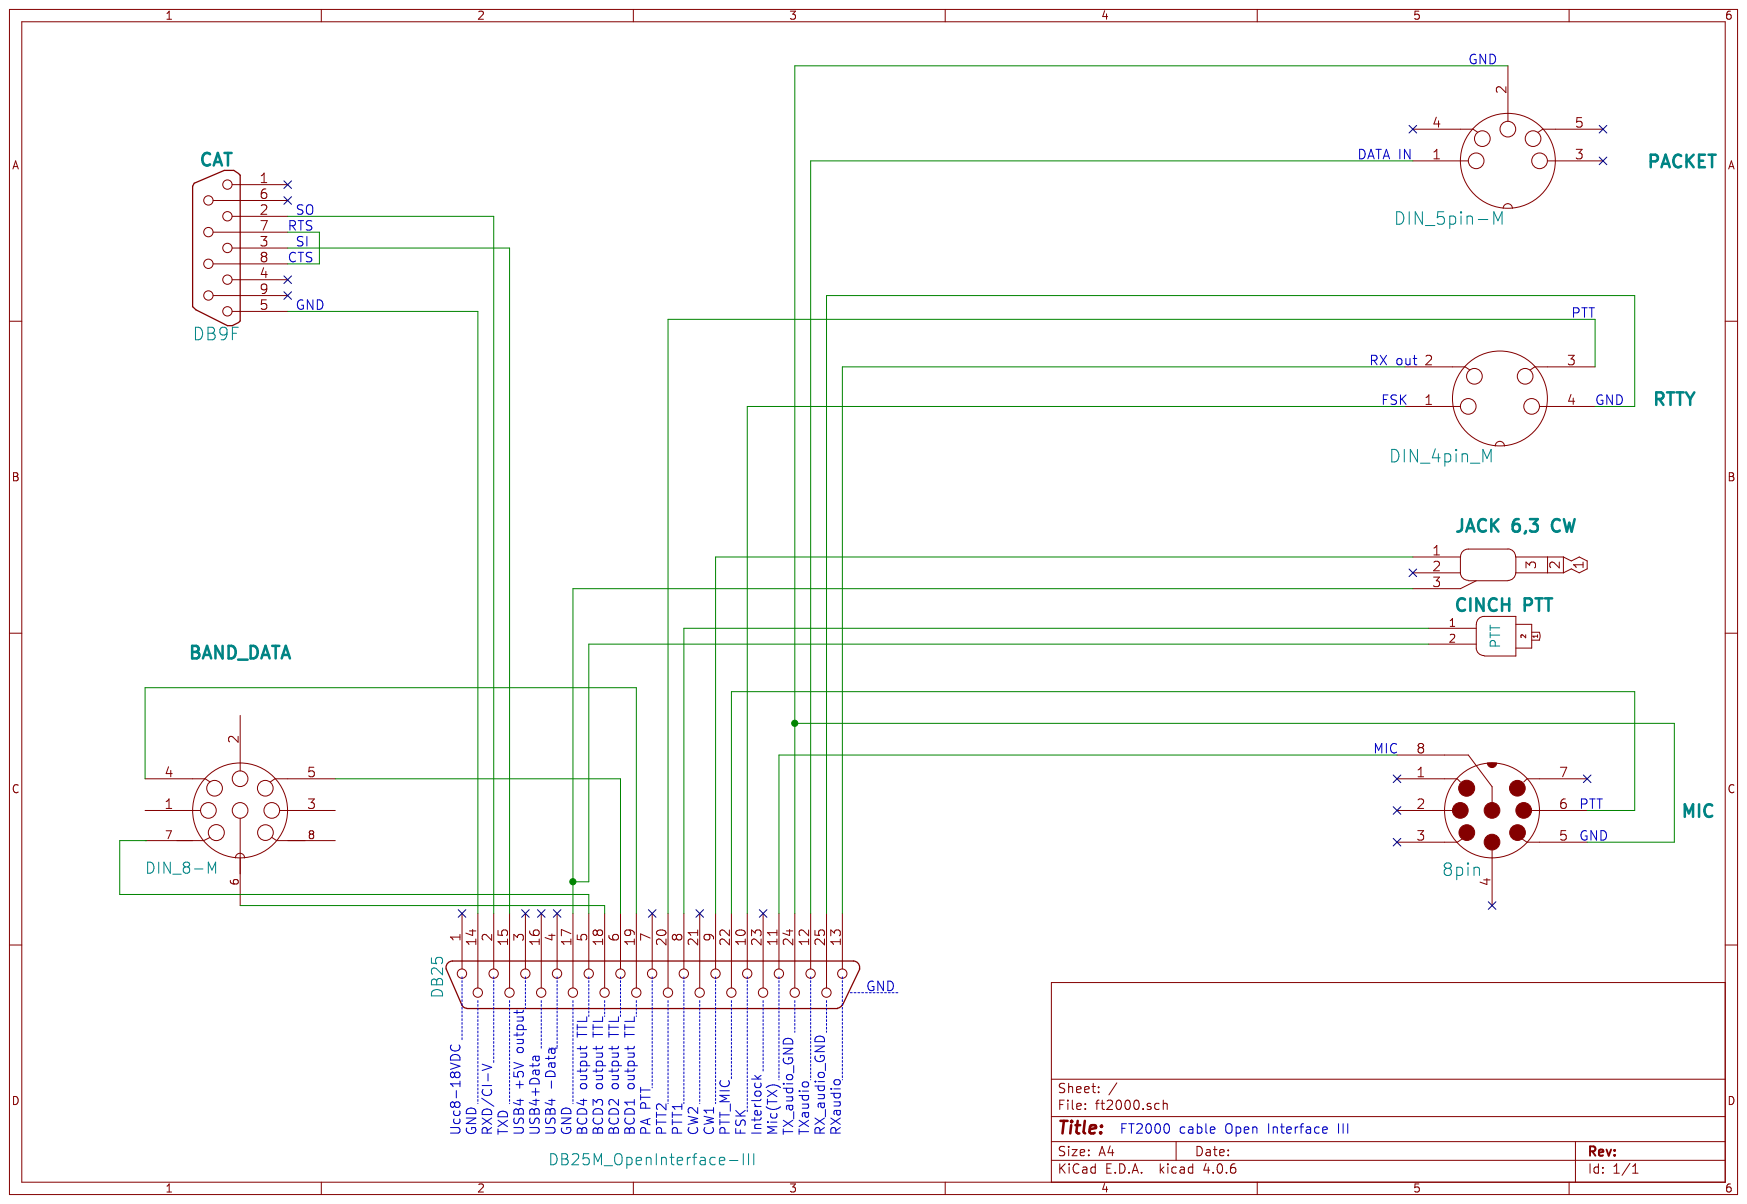
[picture p15: page 1]
