ok1hra/oi3/doc/hw/openinterface3-ic706mkiig.pdf

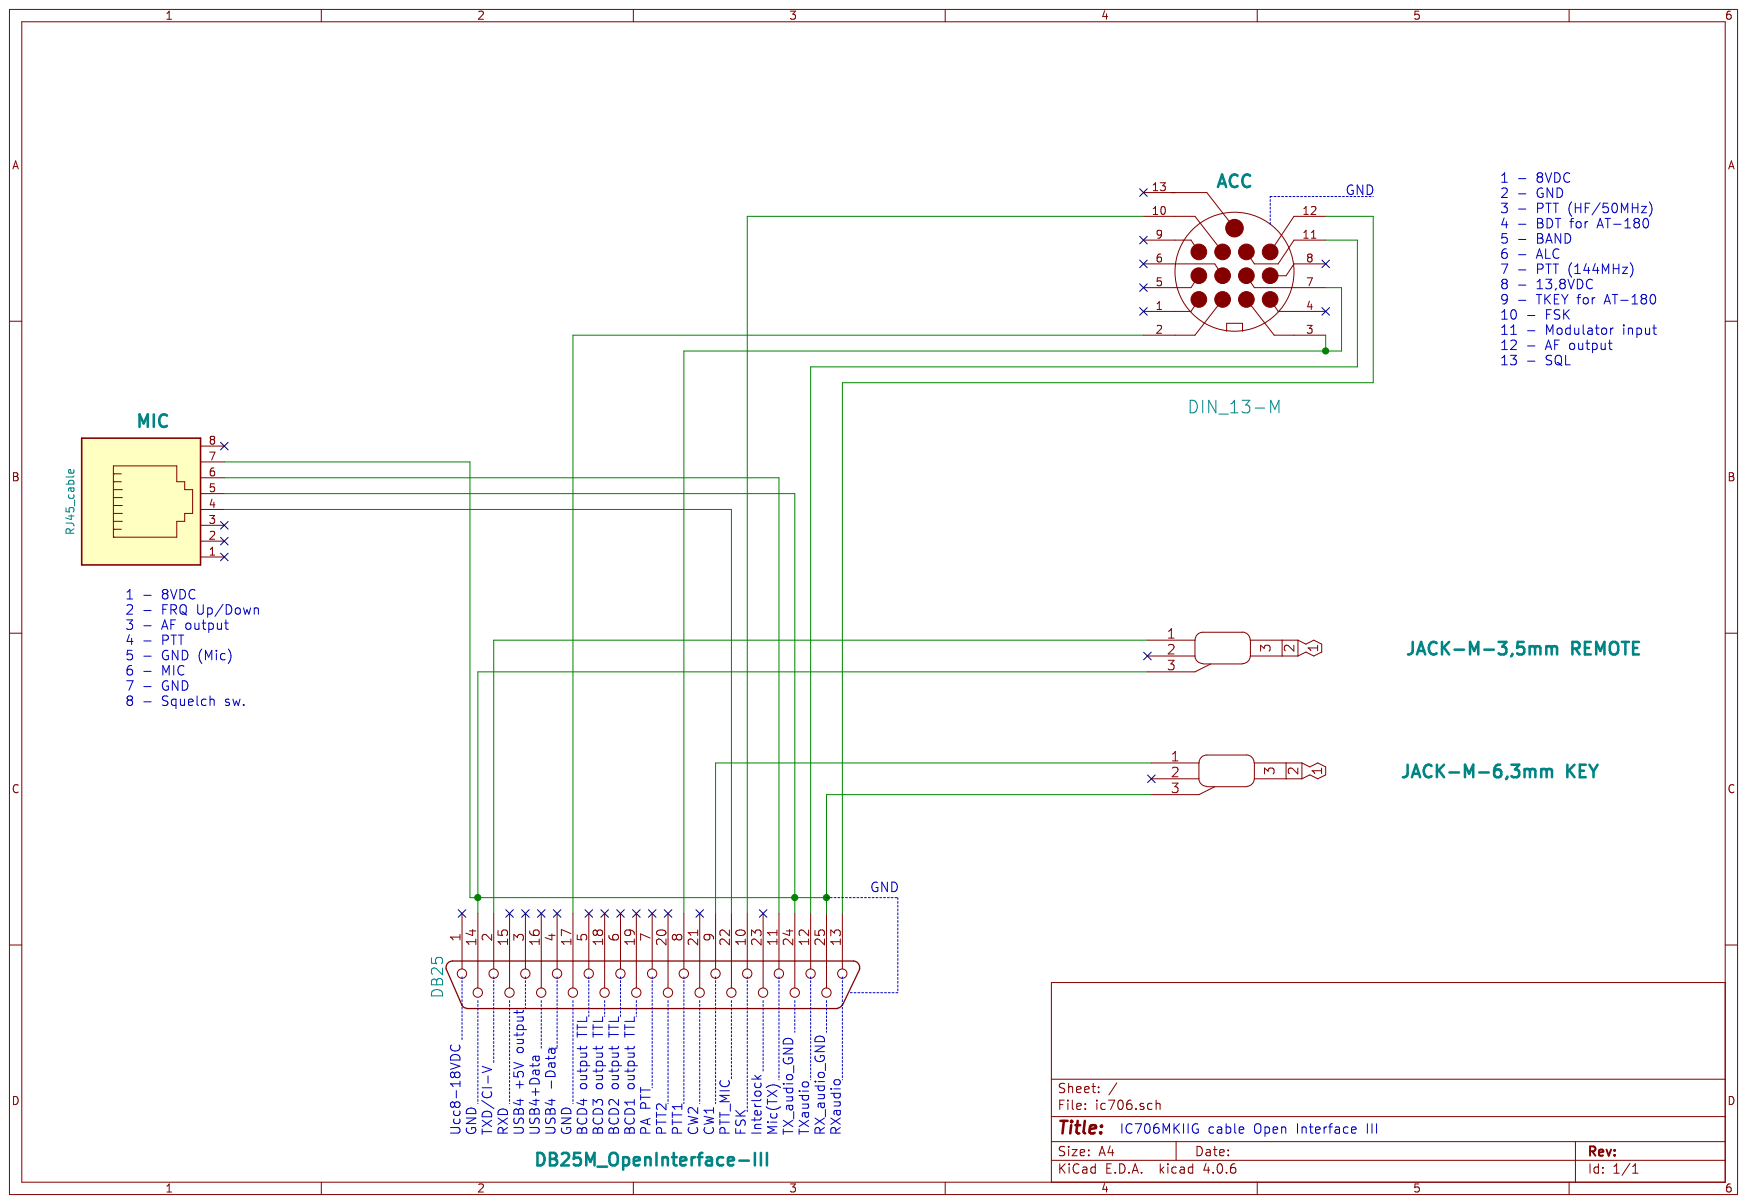
[picture p16: page 1]
