ok1hra/oi3/doc/hw/openinterface3-icom.pdf

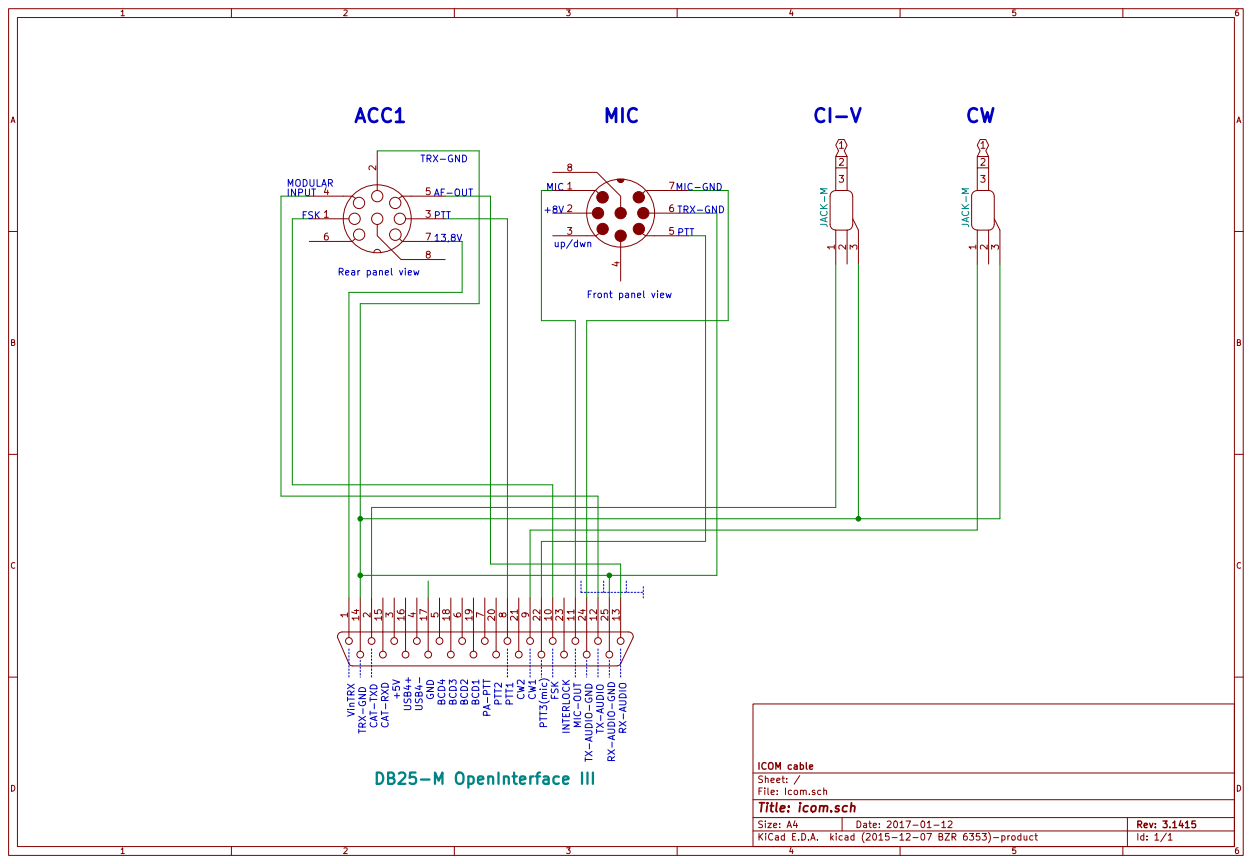
[picture p17: page 1]

File: Icom.sch Sheet: /
Id: 1/1 Title: icom.sch
