ok1hra/oi3/doc/hw/openinterface3-kx3.pdf

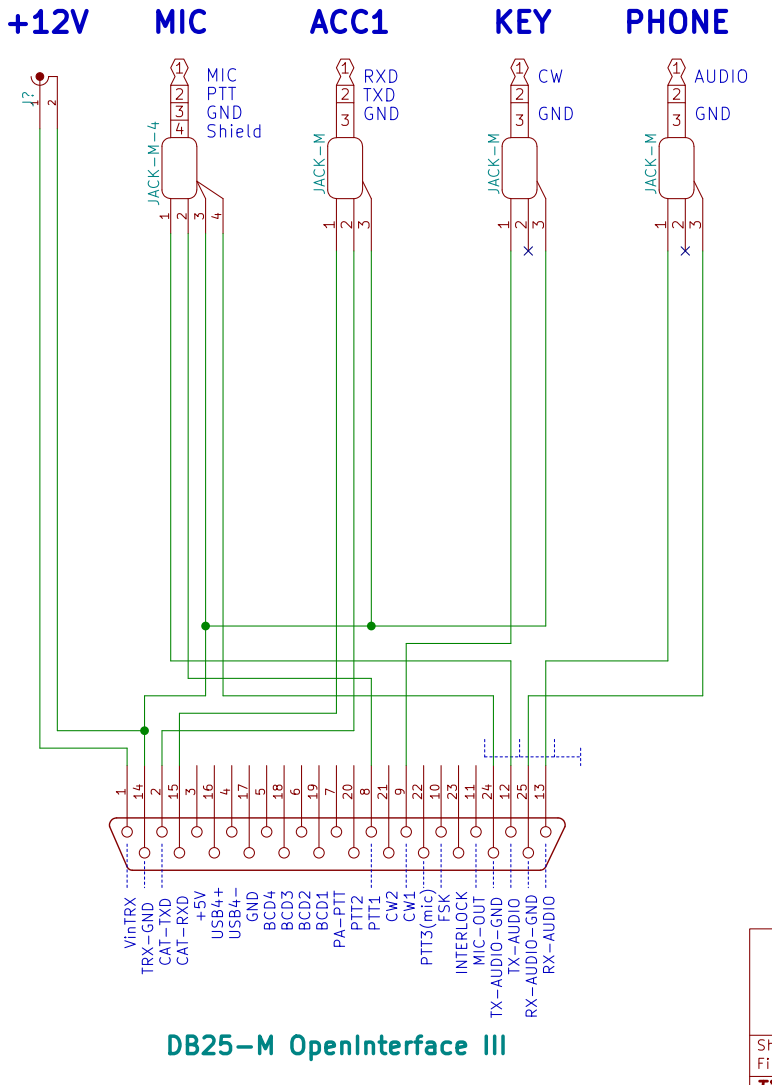
[picture p18: page 1]
