ok1hra/oi3/doc/hw/openinterface3-ts480.pdf

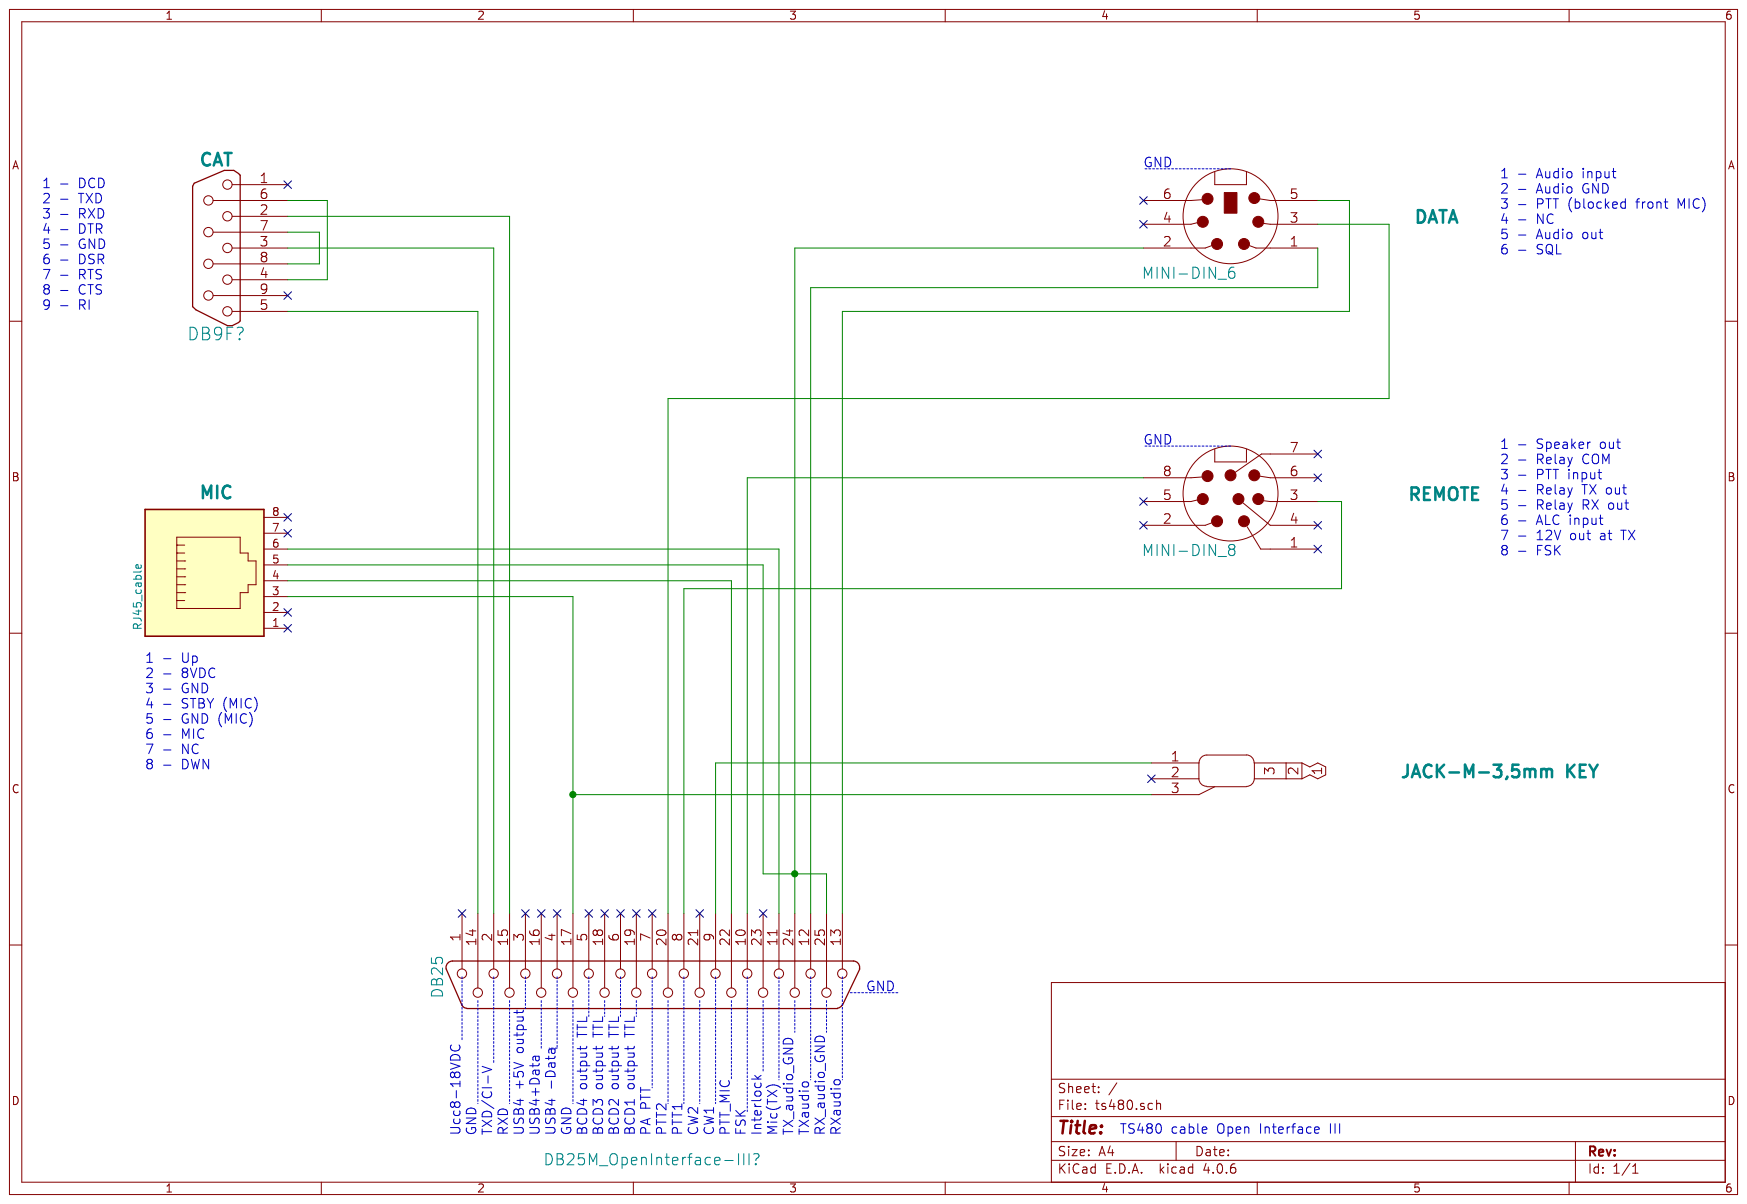
[picture p19: page 1]
