ok1hra/oi3/doc/hw/openinterface3-ts590.pdf

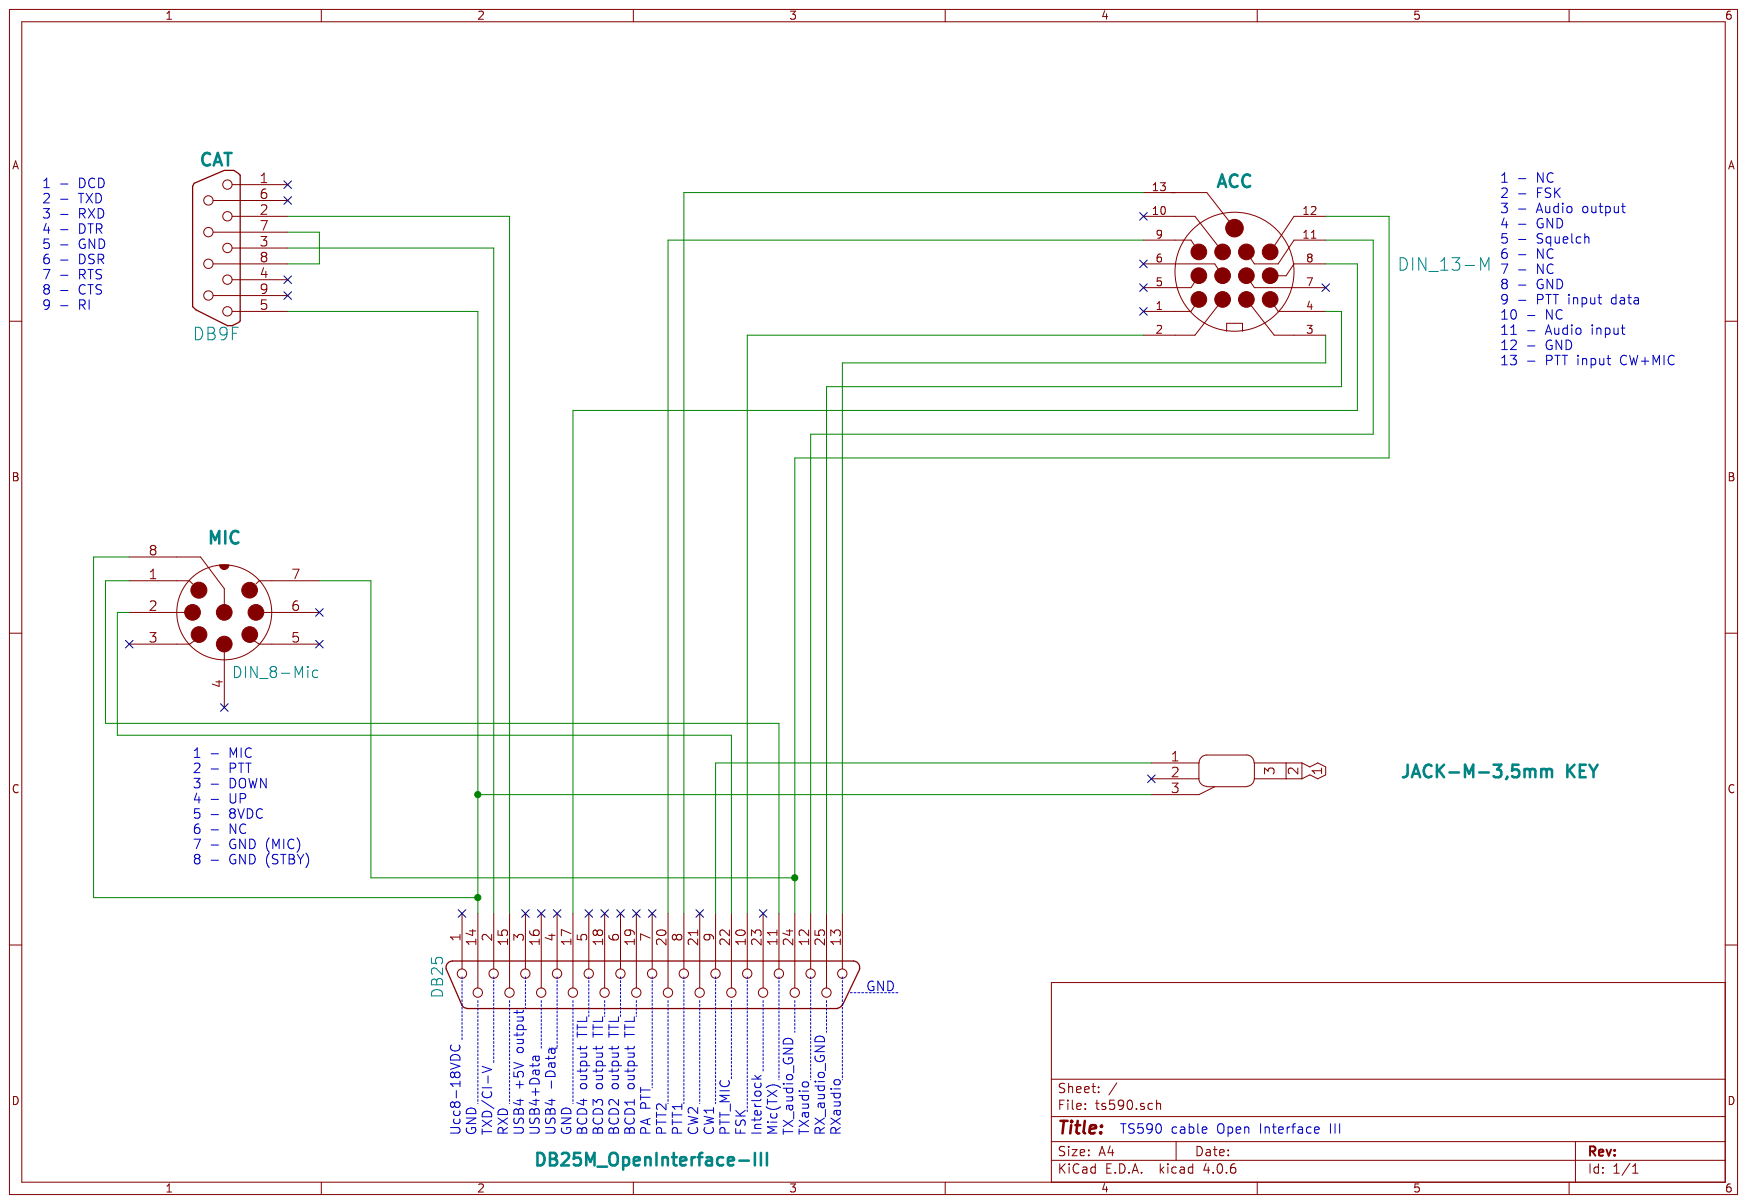
[picture p20: page 1]
