ok1hra/oi3/oi3.ino

const char* REV = "20261113";

// $ ./build.sh
// git commit -am "...


// ===================== PCB REVISION =====================
// Selects the pinout (and feature set) for the target PCB. Pass exactly one
// of these as a build flag, e.g. arduino-cli ... --build-property
// build.extra_flags=-DPCB_REV_3_141  (see build.sh). If none is given, the
// newer 3_1415 board is assumed so the sketch still builds in the IDE.
#if !defined(PCB_REV_3_141) && !defined(PCB_REV_3_1415)
  #define PCB_REV_3_1415
#endif

// FEATURE_NET gates the Ethernet + TrxNet stack. The 3_141 board has no
// Ethernet module install-detect pin (ETHINST) and predates the network
// feature, so it builds without it (smaller binary).
#if defined(PCB_REV_3_1415)
  #define FEATURE_NET
#endif

#if defined(PCB_REV_3_1415)
const int DCIN PROGMEM = A7;      // measure input voltage
const int DC3V PROGMEM = A6;      // measure 3,3V
const int encA PROGMEM = 24;      // encoder-A
const int encB PROGMEM = 18;      // encoder-B
const int MEM PROGMEM = A1;       // K3NG CW key button
const int CW1 PROGMEM = 34;       // out
const int CW2 PROGMEM = 35;       //
const int PTT1 PROGMEM = 41;      //
const int PTT2 PROGMEM = 22;      //
const int PTT3 PROGMEM = 25;      // PTT mic
const int MENU PROGMEM = 36;      // MODE button
const int FSK PROGMEM = 23;       // FSK output
const int INTERLOCK PROGMEM = 2;  // in
const int FootSW PROGMEM = 19;    // in
const byte BCD1 PROGMEM = 42;     // __
const byte BCD2 PROGMEM = 43;     //   |
const byte BCD3 PROGMEM = 44;     //   |- band data
const byte BCD4 PROGMEM = 45;     // __|  from band decoder
const int PADDLEL PROGMEM = 26;    // in
const int PADDLER PROGMEM = 28;    // in
const int SEQUENCER PROGMEM = 40; // out
const int PTTPA PROGMEM = 31;     // out PA PTT
const int SDPLUG PROGMEM = A5;    // in  microSD detect
const int SDCS PROGMEM = 53;      // out
const int AFSK PROGMEM = 29;      // out Switch TX audio path
const int PTT232 PROGMEM = 3;     // in  PTT from USB/serial interface
const int FSKDET PROGMEM = 33;    // in  FSK detector from USB/serial interface
const int WINKEY PROGMEM = 27;    // out P-MOSFET gate: driven LOW permanently to power the DTR/RTS switching elements (enables PTT-232 -> sequencer). HIGH/floating = unpowered
const int TONE PROGMEM = 4;       // out
const int ACC4 PROGMEM = 47;      // if enable ACC SHIFT OUT KEYBOARD
const int ACC5 PROGMEM = 13;      // if enable ACC SHIFT OUT KEYBOARD
const int ACC6 PROGMEM = 5;      // if enable ACC SHIFT OUT KEYBOARD
const int ACC7 PROGMEM = 30;       // if enable ACC SHIFT IN KEYBOARD
const int ACC8 PROGMEM = 32;
const int ACC9 PROGMEM = 11;       // if enable ACC SHIFT IN KEYBOARD
const int ACC10 PROGMEM = 12;      // if enable ACC SHIFT IN KEYBOARD
const int ACC11 PROGMEM = 38;
const int ACC12 PROGMEM = A3;
const int ACC13 PROGMEM = A4;
const int ACC14 PROGMEM = A8;
const int ACC15 PROGMEM = 21;     // SCL/interrupt/ if enable ACC SHIFT OUT KEYBOARD
const int ACC16 PROGMEM = 20;     // SDA/interrupt (was GPS PPS — free)
const int ACC17 PROGMEM = A9;
const int ACC19 PROGMEM = A11;    // if define Icom ACC voltage input
const int SelfRES PROGMEM = 39;
const int ETHINST PROGMEM = 46;     // in Ethernet module install detect
// const int MISO = 50;
// const int MOSI = 51;
// const int SCK  = 52;
const int SMTpad1 PROGMEM = 48;   // ^ Internal SMT pad
const int SMTpad2 PROGMEM = 49;   // -
const int SMTpad3 PROGMEM = A0;   // v

#elif defined(PCB_REV_3_141)
// Original PCB rev 3_141 pinout. Signals that physically do not exist on this
// board (ETHINST, ACC15/16, SelfRES, SMTpad1-3) are intentionally omitted; the
// network stack that would use ETHINST is compiled out (FEATURE_NET undefined).
const int DCIN PROGMEM = A7;      // measure input voltage
const int DC3V PROGMEM = A6;      // measure 3,3V
const int encA PROGMEM = 24;      // encoder-A
const int encB PROGMEM = 23;      // encoder-B
const int MEM PROGMEM = A1;       // K3NG CW key button
const int CW1 PROGMEM = 11;       // out
const int CW2 PROGMEM = 12;       //
const int PTT1 PROGMEM = 13;      //
const int PTT2 PROGMEM = 22;      //
const int PTT3 PROGMEM = 25;      // PTT mic
const int MENU PROGMEM = 36;      // MODE button
const int FSK PROGMEM = 41;       // FSK output
const int INTERLOCK PROGMEM = 21; // in
const int FootSW PROGMEM = 20;    // in
const byte BCD1 PROGMEM = 42;     // __
const byte BCD2 PROGMEM = 43;     //   |
const byte BCD3 PROGMEM = 44;     //   |- band data
const byte BCD4 PROGMEM = 45;     // __|  from band decoder
const int PADDLEL PROGMEM = 2;    // in
const int PADDLER PROGMEM = 5;    // in
const int SEQUENCER PROGMEM = 40; // out
const int PTTPA PROGMEM = 31;     // out PA PTT
const int SDPLUG PROGMEM = A5;    // in  microSD detect
const int SDCS PROGMEM = 53;      // out
const int AFSK PROGMEM = 29;      // out Switch TX audio path
const int PTT232 PROGMEM = 37;    // in  PTT from USB/serial interface
const int FSKDET PROGMEM = 33;    // in  FSK detector from USB/serial interface
const int WINKEY PROGMEM = 27;    // out disable DTR/RTS from USB/serial interface during run winkey emulator
const int TONE PROGMEM = 4;       // out
const int ACC4 PROGMEM = 47;
const int ACC5 PROGMEM = 13;
const int ACC6 PROGMEM = 5;
const int ACC7 PROGMEM = 30;
const int ACC8 PROGMEM = 32;
const int ACC9 PROGMEM = 11;
const int ACC10 PROGMEM = 12;
const int ACC11 PROGMEM = 38;
const int ACC12 PROGMEM = A2;
const int ACC13 PROGMEM = A3;
const int ACC14 PROGMEM = A8;
const int ACC17 PROGMEM = A9;
const int ACC19 PROGMEM = A11;    // if define Icom ACC voltage input
// const int MISO = 50;
// const int MOSI = 51;
// const int SCK  = 52;

#else
  #error "No PCB revision selected (define PCB_REV_3_141 or PCB_REV_3_1415)"
#endif


// Operational serial output gate. OFF (default) suppresses periodic runtime
// chatter ([CIV freq/mode/watchdog], [PTT ...], [Interlock=...]); init banners,
// errors, settings echo and Ethernet link-state changes always print.
// Toggled via LCD menu item 15 (Debug on/off); not persisted in EEPROM.
static bool serialDebug = false;


// ===================== LCD =====================
// HW: 16x2 parallel HD44780, 4-bit mode (PCB_REV_3_1415)
#include <LiquidCrystal.h>

#define lcd_rs      A2
#if defined(PCB_REV_3_1415)
  #define lcd_enable 37
#else  // PCB_REV_3_141
  #define lcd_enable 3
#endif
#define lcd_d4      6
#define lcd_d5      7
#define lcd_d6      8
#define lcd_d7      9
#define LCD_COLUMNS 16
#define LCD_ROWS    2

LiquidCrystal lcd(lcd_rs, lcd_enable, lcd_d4, lcd_d5, lcd_d6, lcd_d7);

void rpi_lcd_glyphs_init();   // rpi_status.ino: custom characters (CGRAM 1..5)

void lcd_setup() {
  lcd.begin(LCD_COLUMNS, LCD_ROWS);
  rpi_lcd_glyphs_init();
  String boot = String("FW ") + REV;
  byte col = (LCD_COLUMNS - boot.length()) / 2;
  lcd.setCursor(col, 0);
  lcd.print(boot);
  delay(500);
  lcd.clear();
}
// =================== END LCD ===================


// ===================== SD CONFIG =====================
// HW: microSD on SPI, CS=SDCS, presence on SDPLUG (analog, <128 = plugged)
// Reads key=value pairs from /oi3.cfg at boot. Missing SD/file → keep defaults.
#include <SPI.h>
#include <SD.h>

String ConfigFile = "oi3.cfg";
char charConfigFile[10];
File myFile;

// Defaults mirror current /oi3.cfg so the unit boots identically without SD
byte          NET_ID          = 0x02;   // hex; 0x00 disables TrxNet
String        YOUR_CALL       = "OK1HRA";
bool          InterlockEnable = true;
int           SEQUENCERlead   = 0;
int           SEQUENCERtail   = 0;
int           PAlead          = 10;
int           PAtail          = 0;
int           PTTlead         = 10;
int           PTTtail         = 210;
byte          PTTmodeLSB      = 3;
byte          PTTmodeUSB      = 3;
byte          PTTmodeAM       = 3;
byte          PTTmodeCW       = 3;
byte          PTTmodeRTTY     = 1;
byte          PTTmodeFM       = 3;
byte          PTTmodeCWR      = 3;
byte          PTTmodeRTR      = 1;
byte          PTTmodeDefault  = 3;
int           BAND_DECODER_IN = 1;      // 0=off, 1=ICOM CI-V, 2=KENWOOD (TS-480)
unsigned long SERBAUD2        = 9600;
byte          CIV_ADRESS      = 0x98;   // hex
bool          CIV_CW_VIA_CIV  = false;  // RESERVED - parsed but unused; CW is always keyed locally
bool          EthernetEnable  = true;
bool          EthernetDHCP    = true;
uint16_t      UdpPort         = 5683;   // TrxNet UDP port; change to isolate networks on one LAN
// Keyer cfg (overridable from oi3.cfg; EEPROM may further override at boot)
byte          KeyerDefaultWpm    = 28;     // 5..50
char          KeyerMode          = 'B';    // 'A' or 'B' (iambic)
bool          KeyerPaddleReverse = false;  // false=PADDLEL is dit, true=swap (PADDLER is dit)
uint16_t      KeyerSidetoneHz    = 600;    // 0=off, otherwise 300..1200
byte          KeyerRttyBaud      = 45;     // 45 / 50 / 75 / 100 (45 => 45.45 Bd)
bool          KeyerFskReverse    = false;  // false: MARK=HIGH/SPACE=LOW; true: inverted
// Low-power TUNE cfg — MODE button (D36) while CivValid keys a low-power carrier
// for antenna-tuner / PA tuning on one click (see LOW-POWER TUNE section).
byte          TunePower           = 20;    // ladicí výkon [%], → CI-V 14 0A
byte          TuneRestoreFallback = 100;   // [%] obnova, když startovní read výkonu selže
uint16_t      TuneHoldMs          = 1000;  // min. doba nosné i na krátké ťuknutí
uint16_t      TuneMaxMs           = 30000; // tvrdý strop nosné (ochrana proti zaseklému tlačítku)
uint16_t      TuneSettleMs        = 80;    // prodleva po set mód+výkon, než jde PTT nahoru
uint16_t      TuneReadTimeoutMs   = 300;   // timeout jednoho pokusu o čtení výkonu
uint16_t      TuneKeepaliveMs     = 2500;  // TUNE ze sítě (/s-lptune): bez keepalive déle → nosná dolů
// TrxNet priority peer prefixes — protected from eviction when the peer table
// fills. Prefix-matched from the start of the device name (705.01/ANT.01/ROT.1).
// Caller-owned storage: must outlive net (globals). Default mirrors oi3.cfg.
#define PRIO_MAX_COUNT 6
#define PRIO_MAX_LEN   8            // 7 chars + null
char          prioPrefix[PRIO_MAX_COUNT][PRIO_MAX_LEN] = { "705", "ANT", "ROT" };
uint8_t       prioCount = 3;

static unsigned char hexToDecBy4bit(unsigned char hex) {
  if (hex > 0x39) hex -= 7;
  return (hex & 0xf);
}

void readSDSettings() {
  char character;
  String settingName;  settingName.reserve(20);
  String settingValue; settingValue.reserve(10);
  myFile = SD.open(charConfigFile);
  if (!myFile) return;
  while (myFile.available()) {
    character = myFile.read();
    while (myFile.available() && character != '[') character = myFile.read();
    character = myFile.read();
    while (myFile.available() && character != '=') { settingName += character; character = myFile.read(); }
    character = myFile.read();
    while (myFile.available() && character != ']') { settingValue += character; character = myFile.read(); }
    if (character == ']') {
      Serial.print('['); Serial.print(settingName); Serial.print('=');
      Serial.print(settingValue); Serial.println(']');

      if      (settingName == "NET_ID")          { unsigned char b[3]; settingValue.toCharArray((char*)b, 3);
                                                   NET_ID = hexToDecBy4bit(b[0])<<4 | hexToDecBy4bit(b[1]); }
      else if (settingName == "YOUR_CALL")       YOUR_CALL = settingValue;
      else if (settingName == "InterlockEnable") InterlockEnable = (bool)settingValue.toInt();
      else if (settingName == "SEQUENCERlead")   SEQUENCERlead = settingValue.toInt();
      else if (settingName == "SEQUENCERtail")   SEQUENCERtail = settingValue.toInt();
      else if (settingName == "PAlead")          PAlead = settingValue.toInt();
      else if (settingName == "PAtail")          PAtail = settingValue.toInt();
      else if (settingName == "PTTlead")         PTTlead = settingValue.toInt();
      else if (settingName == "PTTtail")         PTTtail = settingValue.toInt();
      else if (settingName == "PTTmodeLSB")      PTTmodeLSB = (byte)settingValue.toInt();
      else if (settingName == "PTTmodeUSB")      PTTmodeUSB = (byte)settingValue.toInt();
      else if (settingName == "PTTmodeAM")       PTTmodeAM = (byte)settingValue.toInt();
      else if (settingName == "PTTmodeCW")       PTTmodeCW = (byte)settingValue.toInt();
      else if (settingName == "PTTmodeRTTY")     PTTmodeRTTY = (byte)settingValue.toInt();
      else if (settingName == "PTTmodeFM")       PTTmodeFM = (byte)settingValue.toInt();
      else if (settingName == "PTTmodeCWR")      PTTmodeCWR = (byte)settingValue.toInt();
      else if (settingName == "PTTmodeRTR")      PTTmodeRTR = (byte)settingValue.toInt();
      else if (settingName == "PTTmodeDefault")  PTTmodeDefault = (byte)settingValue.toInt();
      else if (settingName == "BAND_DECODER_IN") { int v = settingValue.toInt();
                                                   BAND_DECODER_IN = (v >= 0 && v <= 2) ? v : 0; }
      else if (settingName == "SERBAUD2")        SERBAUD2 = (unsigned long)settingValue.toInt();
      else if (settingName == "CIV_ADRESS")      { unsigned char b[3]; settingValue.toCharArray((char*)b, 3);
                                                   CIV_ADRESS = hexToDecBy4bit(b[0])<<4 | hexToDecBy4bit(b[1]); }
      else if (settingName == "CIV_CW_VIA_CIV")  CIV_CW_VIA_CIV = (bool)settingValue.toInt();
      else if (settingName == "EthernetEnable")  EthernetEnable = (bool)settingValue.toInt();
      else if (settingName == "EthernetDHCP")    EthernetDHCP = (bool)settingValue.toInt();
      else if (settingName == "UdpPort")         { long p = settingValue.toInt();
                                                   if (p >= 1 && p <= 65535) UdpPort = (uint16_t)p; }
      else if (settingName == "KeyerDefaultWpm") KeyerDefaultWpm = (byte)settingValue.toInt();
      else if (settingName == "KeyerMode")       { char c = settingValue.length() > 0 ? settingValue.charAt(0) : 'B';
                                                   if (c >= 'a' && c <= 'z') c -= 32;
                                                   KeyerMode = (c == 'A') ? 'A' : 'B'; }
      else if (settingName == "KeyerPaddleReverse") KeyerPaddleReverse = (bool)settingValue.toInt();
      else if (settingName == "KeyerSidetoneHz") KeyerSidetoneHz = (uint16_t)settingValue.toInt();
      else if (settingName == "KeyerRttyBaud")   KeyerRttyBaud = (byte)settingValue.toInt();
      else if (settingName == "KeyerFskReverse") KeyerFskReverse = (bool)settingValue.toInt();
      else if (rkey_cfg(settingName, settingValue)) {}   // Rkey* keys (rkey.ino)
      else if (settingName == "TunePower")           TunePower = (byte)settingValue.toInt();
      else if (settingName == "TuneRestoreFallback") TuneRestoreFallback = (byte)settingValue.toInt();
      else if (settingName == "TuneHoldMs")          TuneHoldMs = (uint16_t)settingValue.toInt();
      else if (settingName == "TuneMaxMs")           TuneMaxMs = (uint16_t)settingValue.toInt();
      else if (settingName == "TuneSettleMs")        TuneSettleMs = (uint16_t)settingValue.toInt();
      else if (settingName == "TuneReadTimeoutMs")   TuneReadTimeoutMs = (uint16_t)settingValue.toInt();
      else if (settingName == "TuneKeepaliveMs")     TuneKeepaliveMs = (uint16_t)settingValue.toInt();
      else if (settingName == "PriorityPrefixes") {
        // Replace (not extend) the compiled default. Split on spaces, skip
        // empty tokens, truncate to PRIO_MAX_LEN-1 chars, cap at PRIO_MAX_COUNT.
        prioCount = 0;
        int len = settingValue.length();
        int i = 0;
        while (i < len && prioCount < PRIO_MAX_COUNT) {
          while (i < len && settingValue.charAt(i) == ' ') i++;   // skip spaces
          int start = i;
          while (i < len && settingValue.charAt(i) != ' ') i++;   // token span
          int n = i - start;
          if (n > 0) {
            if (n > PRIO_MAX_LEN - 1) n = PRIO_MAX_LEN - 1;
            for (int k = 0; k < n; k++) prioPrefix[prioCount][k] = settingValue.charAt(start + k);
            prioPrefix[prioCount][n] = '\0';
            prioCount++;
          }
        }
      }

      settingName = "";
      settingValue = "";
    }
  }
  myFile.close();
}

void sdcfg_setup() {
  Serial.println(F("--- SD CONFIG ---"));
  pinMode(SDPLUG, INPUT);
    digitalWrite(SDPLUG, HIGH);            // pull up
  pinMode(SDCS, OUTPUT);

  lcd.setCursor(0, 1);
  if (analogRead(SDPLUG) > 128) {          // SD not inserted
    lcd.print(F("SD card missing "));
    Serial.println(F("SD card missing"));
    delay(1000);
    lcd.setCursor(0, 1); lcd.print(F("                "));
    return;
  }
  if (!SD.begin(SDCS)) {
    lcd.print(F("SD init fail    "));
    Serial.println(F("SD init fail"));
    delay(1000);
    lcd.setCursor(0, 1); lcd.print(F("                "));
    return;
  }
  ConfigFile.toCharArray(charConfigFile, sizeof(charConfigFile));
  if (!SD.exists(charConfigFile)) {
    lcd.print(ConfigFile); lcd.print(F(" missing "));
    Serial.print(ConfigFile); Serial.println(F(" missing"));
    delay(1000);
    lcd.setCursor(0, 1); lcd.print(F("                "));
    return;
  }
  lcd.print(F("loaded ")); lcd.print(ConfigFile);
  readSDSettings();
}
// =================== END SD CONFIG ===================


// ===================== ETHERNET =====================
// HW: W5100/W5500 module on SPI, ETHINST (D46) pull-up — LOW = module present.
// Boot: block up to ETH_BOOT_TIMEOUT waiting for link, show IP on LCD ~1 s.
// Runtime: every ETH_CHECK_INTERVAL poll linkStatus(). A link that comes back
// keeps the address it had (the W5x00 keeps it across a link drop); DHCP runs
// again only while there is no address, every ETH_DHCP_RETRY_MS. Lease renewal
// via Ethernet.maintain(), backed off after a failure. Every DHCP exchange is
// capped at ETH_DHCP_TIMEOUT_MS: it blocks the whole loop (LCD, keyer, TrxNet),
// and the library default of 60 s froze the OI3 for as long as a rebooting
// WIFILT Pi -- often its DHCP server -- took to come back (2026-11-13).
// Runtime messages → Serial only.
// Link state is read by the LCD runtime even when the network stack is
// compiled out (PCB_REV_3_141), so keep these two flags unconditionally
// defined. They simply stay false when FEATURE_NET is undefined.
bool          EthLinkStatus      = false;
bool          EthModulePresent   = false;

#ifdef FEATURE_NET
#include <Ethernet.h>
#include <EthernetUdp.h>

unsigned long EthLastCheckMs     = 0;
const unsigned long ETH_CHECK_INTERVAL = 1000;
const unsigned long ETH_DHCP_TIMEOUT_MS  = 3000;   // one whole DHCP exchange
const unsigned long ETH_DHCP_REPLY_MS    = 1000;   // one server reply
const unsigned long ETH_DHCP_RETRY_MS    = 15000;  // next try without an address
// An address is in place (DHCP lease or static). After a failed begin() the
// library's state would make every maintain() a new 3 s attempt, so without an
// address the loop retries begin() on its own timer instead.
static bool          ethHaveIp       = false;
static unsigned long ethDhcpNextMs   = 0;
const unsigned long ETH_BOOT_TIMEOUT   = 5000;
const unsigned long ETH_SLIDE_MIN_MS   = 500;

byte      ethMac[]      = {0xDE, 0xAD, 0xBE, 0xEF, 0xFE, 0x00};
IPAddress ethStaticIP   (192, 168, 1, 220);
IPAddress ethGateway    (192, 168, 1, 1);
IPAddress ethSubnet     (255, 255, 255, 0);
IPAddress ethDns        (8, 8, 8, 8);

static bool ethernet_bringUp() {
  ethHaveIp = false;
  if (EthernetDHCP) {
    if (Ethernet.begin(ethMac, ETH_DHCP_TIMEOUT_MS, ETH_DHCP_REPLY_MS) == 0) return false;
    IPAddress ip = Ethernet.localIP();
    if (ip[0] == 0 && ip[1] == 0 && ip[2] == 0 && ip[3] == 0) return false;
  } else {
    Ethernet.begin(ethMac, ethStaticIP, ethDns, ethGateway, ethSubnet);
  }
  Ethernet.setRetransmissionTimeout(500);
  Ethernet.setRetransmissionCount(2);
  ethHaveIp = true;
  return true;
}

// TrxNet starts only with an address (trxnet_loop).
bool ethernet_has_ip() { return ethHaveIp; }

static void ethernet_showIP() {
  IPAddress ip = Ethernet.localIP();
  lcd.clear();
  lcd.setCursor(0, 0);
  lcd.print(F("IP address:"));
  lcd.setCursor(0, 1);
  lcd.print(ip);
  Serial.print(F("Ethernet IP: "));
  Serial.println(ip);
  delay(1000);
  lcd.clear();
}

void ethernet_setup() {
  Serial.println(F("--- ETHERNET ---"));
  pinMode(ETHINST, INPUT_PULLUP);
  delay(2);
  EthModulePresent = (digitalRead(ETHINST) == LOW);

  if (!EthernetEnable) {
    Serial.println(F("Ethernet disabled in cfg"));
    lcd.setCursor(0, 0);
    lcd.print(F("Eth: disabled   "));
    delay(1000);
    lcd.clear();
    return;
  }
  if (!EthModulePresent) {
    Serial.println(F("ETH module not present"));
    lcd.setCursor(0, 0);
    lcd.print(F("ETH module n/a  "));
    delay(1000);
    lcd.clear();
    return;
  }

  ethMac[5] = 0xFF - NET_ID;

  // Slide 2: Net-ID + waiting for link (min 0.5 s, max ETH_BOOT_TIMEOUT)
  lcd.clear();
  lcd.setCursor(0, 0);
  lcd.print(F("Net-ID: "));
  lcd.print(NET_ID, HEX);
  lcd.setCursor(0, 1);
  lcd.print(F("Eth: waiting..."));

  unsigned long t0 = millis();
  while (millis() - t0 < ETH_BOOT_TIMEOUT) {
    if (Ethernet.linkStatus() == LinkON) {
      EthLinkStatus = true;
      break;
    }
    delay(50);
  }
  while (millis() - t0 < ETH_SLIDE_MIN_MS) delay(10);

  if (!EthLinkStatus) {
    Serial.println(F("Ethernet: no link"));
    lcd.clear();
    lcd.setCursor(0, 0);
    lcd.print(F("Eth: no link"));
    delay(1000);
    lcd.clear();
    return;
  }

  if (!ethernet_bringUp()) {
    // IP stack is not usable — clear the link flag so trxnet_loop() does not
    // start TrxNet over a broken stack (it gates on EthLinkStatus).
    EthLinkStatus = false;
    Serial.println(F("Ethernet: DHCP fail"));
    lcd.clear();
    lcd.setCursor(0, 0);
    lcd.print(F("DHCP fail"));
    delay(1000);
    lcd.clear();
    return;
  }

  ethernet_showIP();
  EthLastCheckMs = millis();
}

void ethernet_loop() {
  if (!EthernetEnable || !EthModulePresent) return;
  if (millis() - EthLastCheckMs < ETH_CHECK_INTERVAL) return;
  EthLastCheckMs = millis();

  bool linkNow = (Ethernet.linkStatus() == LinkON);
  if (linkNow && !EthLinkStatus) {
    EthLinkStatus = true;
    Serial.println(F("Eth: link up"));
    // The address survives a link drop; asking DHCP again here meant waiting
    // for a server that is usually the very machine that just rebooted.
    if (!ethHaveIp) ethDhcpNextMs = millis();
  } else if (!linkNow && EthLinkStatus) {
    EthLinkStatus = false;
    Serial.println(F("Eth: link lost"));
  }

  // DHCP blocks the loop for up to ETH_DHCP_TIMEOUT_MS -> never while a remote
  // CW stream is keying; it runs in the next pause.
  if (!EthLinkStatus || rkey_keying_recent()) return;
  unsigned long now = millis();
  if ((long)(now - ethDhcpNextMs) < 0) return;
  if (!ethHaveIp) {
    if (ethernet_bringUp()) {
      Serial.print(F("Ethernet IP: "));
      Serial.println(Ethernet.localIP());
    } else {
      Serial.println(F("Eth: DHCP fail, retry in 15 s"));
      ethDhcpNextMs = now + ETH_DHCP_RETRY_MS;
    }
  } else if (EthernetDHCP) {
    // A failed renew or rebind leaves the address on the chip but the library
    // in a state where every call retries: back off instead.
    // maintain()'s codes (Ethernet library Dhcp.h, not included by Ethernet.h):
    // 1 = DHCP_CHECK_RENEW_FAIL, 3 = DHCP_CHECK_REBIND_FAIL.
    int rc = Ethernet.maintain();
    if (rc == 1 || rc == 3) {
      Serial.println(F("Eth: DHCP renew fail, retry in 15 s"));
      ethDhcpNextMs = now + ETH_DHCP_RETRY_MS;
    }
  }
}
#else  // !FEATURE_NET — board has no Ethernet module (PCB_REV_3_141)
void ethernet_setup() {}
void ethernet_loop()  {}
#endif // FEATURE_NET
// =================== END ETHERNET ===================


// ===================== ICOM CI-V =====================
// HW: ICOM transceiver on Serial2 (Mega: RX2=17, TX2=16) @ SERBAUD2.
// Reads frequency and mode via CI-V; supports both poll (controller-initiated)
// and sniff (radio transceive broadcast). On change updates CivFreq/CivMode
// and calls civ_publish_*() hooks (currently empty — TrxNet placeholder).
// Watchdog: after CIV_WATCHDOG_MS without data, CivValid drops to false;
// last-known CivFreq/CivMode are preserved.
// Gating: civ_setup() always opens Serial2 (port shared with other features
// like CIV_CW_VIA_CIV); civ_loop() is a no-op unless BAND_DECODER_IN == 1.
// State machine ported from k3ng_keyer icomSM().

const uint8_t       CIV_OWN_ADDRESS         = 0x0E;
const unsigned long CIV_POLL_INTERVAL_SLOW  = 2000;
const unsigned long CIV_POLL_INTERVAL_FAST  = 200;
const unsigned long CIV_WATCHDOG_MS         = 10000;

// Rig state in CI-V encoding regardless of the CAT protocol: the KENWOOD
// backend (kenwood.ino) translates into these same variables.
unsigned long CivFreq  = 0;       // Hz, last parsed frequency
// Boot default = CW (0x03). When CI-V is silent (!CivValid) the MODE button
// rotates this locally; once rig data arrives, broadcasts overwrite it.
uint8_t       CivMode  = 0x03;    // raw CI-V mode byte
uint8_t       CivFilter = 0x01;   // last parsed IF filter (1=FIL1,2=FIL2,3=FIL3)
bool          CivValid = false;

static unsigned long civLastPollMs       = 0;
static unsigned long civCurrentInterval  = CIV_POLL_INTERVAL_SLOW;
static unsigned long civFastUntilMs      = 0;
static unsigned long civLastParseMs      = 0;
static uint8_t       civSm               = 1;
static uint8_t       civRd[11];

// --- TrxNet publish hooks (defined in TRXNET section below) ---
void civ_publish_freq();
void civ_publish_mode();

static void civ_send_request(uint8_t cmd) {
  Serial2.write((uint8_t)0xFE);
  Serial2.write((uint8_t)0xFE);
  Serial2.write((uint8_t)CIV_ADRESS);
  Serial2.write((uint8_t)CIV_OWN_ADDRESS);
  Serial2.write((uint8_t)cmd);
  Serial2.write((uint8_t)0xFD);
  Serial2.flush();
}

void civ_request_fast_poll(unsigned long duration_ms);

// IC-7610 in dual-receive mode targets VFO B by default; this sub-cmd forces
// MAIN band selection before SET. Other ICOM models NAK this sub-cmd, so it's
// gated by CI-V address.
static void civ_send_main_band_select() {
  Serial2.write((uint8_t)0xFE);
  Serial2.write((uint8_t)0xFE);
  Serial2.write((uint8_t)CIV_ADRESS);
  Serial2.write((uint8_t)CIV_OWN_ADDRESS);
  Serial2.write((uint8_t)0x07);
  Serial2.write((uint8_t)0xD2);
  Serial2.write((uint8_t)0x00);
  Serial2.write((uint8_t)0xFD);
  Serial2.flush();
}

void civ_send_setfreq(uint32_t hz) {
  if (CIV_ADRESS == 0x98) civ_send_main_band_select();
  uint8_t b1 = ((hz /         10UL) % 10) << 4 | ( hz                 % 10);
  uint8_t b2 = ((hz /       1000UL) % 10) << 4 | ((hz /        100UL) % 10);
  uint8_t b3 = ((hz /     100000UL) % 10) << 4 | ((hz /      10000UL) % 10);
  uint8_t b4 = ((hz /   10000000UL) % 10) << 4 | ((hz /    1000000UL) % 10);
  uint8_t b5 = ((hz / 1000000000UL) % 10) << 4 | ((hz /  100000000UL) % 10);
  Serial2.write((uint8_t)0xFE);
  Serial2.write((uint8_t)0xFE);
  Serial2.write((uint8_t)CIV_ADRESS);
  Serial2.write((uint8_t)CIV_OWN_ADDRESS);
  Serial2.write((uint8_t)0x05);
  Serial2.write(b1); Serial2.write(b2); Serial2.write(b3);
  Serial2.write(b4); Serial2.write(b5);
  Serial2.write((uint8_t)0xFD);
  Serial2.flush();
  civ_request_fast_poll(10000);
}

// Set mode with explicit IF filter (flt 1..3). civ_send_setmode() keeps the old
// behaviour (FIL1) for callers that don't track the filter.
void civ_send_setmode_flt(uint8_t civmode, uint8_t flt) {
  if (flt < 1 || flt > 3) flt = 1;      // sanitize: a bad filter byte would NAK
  if (CIV_ADRESS == 0x98) civ_send_main_band_select();
  Serial2.write((uint8_t)0xFE);
  Serial2.write((uint8_t)0xFE);
  Serial2.write((uint8_t)CIV_ADRESS);
  Serial2.write((uint8_t)CIV_OWN_ADDRESS);
  Serial2.write((uint8_t)0x06);
  Serial2.write(civmode);
  Serial2.write(flt);
  Serial2.write((uint8_t)0xFD);
  Serial2.flush();
  civ_request_fast_poll(10000);
}

void civ_send_setmode(uint8_t civmode) {
  civ_send_setmode_flt(civmode, 0x01);
}

// ----- RF power (cmd 14 0A) -----
// CI-V RF power is a 2-byte BCD value 00 00..02 55 (0..255) = 0..100 %.
// Percent → raw (0..255), rounded to nearest.
static uint8_t civ_power_pct_to_raw(uint8_t pct) {
  if (pct > 100) pct = 100;
  return (uint8_t)(((uint16_t)pct * 255 + 50) / 100);
}

// Set RF power. raw (0..255) → d1 = hundreds BCD digit, d2 = tens/units BCD.
void civ_send_set_power(uint8_t raw) {
  uint8_t d1 = raw / 100;                                // 0..2
  uint8_t d2 = (uint8_t)((((raw / 10) % 10) << 4) | (raw % 10));
  Serial2.write((uint8_t)0xFE);
  Serial2.write((uint8_t)0xFE);
  Serial2.write((uint8_t)CIV_ADRESS);
  Serial2.write((uint8_t)CIV_OWN_ADDRESS);
  Serial2.write((uint8_t)0x14);
  Serial2.write((uint8_t)0x0A);
  Serial2.write(d1);
  Serial2.write(d2);
  Serial2.write((uint8_t)0xFD);
  Serial2.flush();
}

// Blocking read of RF power (cmd 14 0A). Returns true and sets *raw (0..255) on
// a valid reply within timeoutMs (retried up to `retries` extra times).
// Pumps net/ptt loops while waiting but NOT civ_loop() — so the reply bytes stay
// for this parser instead of being consumed by the periodic sniffer. Intended to
// run only inside the exclusive TUNE action (background polling paused anyway).
bool civ_read_power_blocking(uint8_t* raw, uint16_t timeoutMs, uint8_t retries) {
  for (uint8_t attempt = 0; attempt <= retries; attempt++) {
    while (Serial2.available() > 0) Serial2.read();      // flush stale RX
    // request: FE FE <radio> <us> 14 0A FD
    Serial2.write((uint8_t)0xFE); Serial2.write((uint8_t)0xFE);
    Serial2.write((uint8_t)CIV_ADRESS); Serial2.write((uint8_t)CIV_OWN_ADDRESS);
    Serial2.write((uint8_t)0x14); Serial2.write((uint8_t)0x0A);
    Serial2.write((uint8_t)0xFD);
    Serial2.flush();

    uint8_t sm = 0, d1 = 0, d2 = 0;
    unsigned long t0 = millis();
    while ((millis() - t0) < timeoutMs) {
      ethernet_loop(); trxnet_loop(); rkey_loop(); ptt_loop();
      while (Serial2.available() > 0) {
        uint8_t b = (uint8_t)Serial2.read();
        switch (sm) {
          case 0: sm = (b == 0xFE) ? 1 : 0; break;
          case 1: sm = (b == 0xFE) ? 2 : 0; break;
          case 2: // to-addr = our controller (0x0E), or 0xE0; extra FE stays
                  if      (b == CIV_OWN_ADDRESS || b == 0xE0) sm = 3;
                  else if (b == 0xFE)                         sm = 2;
                  else                                        sm = 0; break;
          case 3: sm = (b == CIV_ADRESS) ? 4 : (b == 0xFE ? 1 : 0); break;
          case 4: sm = (b == 0x14) ? 5 : (b == 0xFE ? 1 : 0); break;
          case 5: sm = (b == 0x0A) ? 6 : (b == 0xFE ? 1 : 0); break;
          case 6: d1 = b; sm = 7; break;
          case 7: d2 = b; sm = 8; break;
          case 8:
            if (b == 0xFD) {
              uint16_t v = (uint16_t)(((d1 >> 4) * 10 + (d1 & 0x0F)) * 100
                                    + ((d2 >> 4) * 10 + (d2 & 0x0F)));
              if (v > 255) v = 255;
              *raw = (uint8_t)v;
              return true;
            }
            sm = (b == 0xFE) ? 1 : 0; break;
        }
      }
    }
  }
  return false;
}

// CI-V freq is 5 BCD bytes, LSB-first. Each byte's high nibble is the more
// significant decimal digit of that pair.
static unsigned long civ_decode_bcd_freq(uint8_t b1, uint8_t b2, uint8_t b3, uint8_t b4, uint8_t b5) {
  unsigned long f = 0;
  f += ((unsigned long)(b5 >> 4))   * 1000000000UL;
  f += ((unsigned long)(b5 & 0x0F)) *  100000000UL;
  f += ((unsigned long)(b4 >> 4))   *   10000000UL;
  f += ((unsigned long)(b4 & 0x0F)) *    1000000UL;
  f += ((unsigned long)(b3 >> 4))   *     100000UL;
  f += ((unsigned long)(b3 & 0x0F)) *      10000UL;
  f += ((unsigned long)(b2 >> 4))   *       1000UL;
  f += ((unsigned long)(b2 & 0x0F)) *        100UL;
  f += ((unsigned long)(b1 >> 4))   *         10UL;
  f +=  (unsigned long)(b1 & 0x0F);
  return f;
}

// Frame layouts handled:
//   FE FE <to> <radio> 03 <BCD1..5> FD     freq response to our poll
//   FE FE 00  <radio> 00 <BCD1..5> FD     freq transceive broadcast
//   FE FE <radio> <us> 05 <BCD1..5> FD    set-freq sniff (own outgoing echo)
//   FE FE <to> <radio> 04 <mode> <flt> FD  mode response
static void civ_state_machine(uint8_t b) {
  civRd[10] = 0;
  switch (civSm) {
    case 1:  if (b == 0xFE) { civSm = 2; civRd[0] = b; } break;
    case 2:  if (b == 0xFE) { civSm = 3; civRd[1] = b; } else { civSm = 1; } break;
    case 3:  if (b == 0x00 || b == 0xE0 || b == CIV_OWN_ADDRESS || b == 0xF1) {
               civSm = 4; civRd[2] = b;
             } else if (b == CIV_ADRESS) {
               civSm = 6; civRd[2] = b;
             } else { civSm = 1; } break;
    case 4:  if (b == CIV_ADRESS) { civSm = 5; civRd[3] = b; } else { civSm = 1; } break;
    case 5:  if (b == 0x00 || b == 0x03) { civSm = 8;  civRd[4] = b; }
             else if (b == 0x04)         { civSm = 14; civRd[4] = b; }
             else                        { civSm = 1; } break;
    case 6:  if (b == 0x00 || b == 0xE0 || b == 0xF1) { civSm = 7; civRd[3] = b; } else { civSm = 1; } break;
    case 7:  if (b == 0x00 || b == 0x05) { civSm = 8; civRd[4] = b; } else { civSm = 1; } break;
    case 8:  if (b <= 0x99) { civSm = 9;  civRd[5] = b; } else { civSm = 1; } break;
    case 9:  if (b <= 0x99) { civSm = 10; civRd[6] = b; } else { civSm = 1; } break;
    case 10: if (b <= 0x99) { civSm = 11; civRd[7] = b; } else { civSm = 1; } break;
    case 11: if (b <= 0x99) { civSm = 12; civRd[8] = b; } else { civSm = 1; } break;
    case 12: if (b <= 0x99) { civSm = 13; civRd[9] = b; } else { civSm = 1; } break;
    case 13: if (b == 0xFD) { civSm = 1;  civRd[10] = b; } else { civSm = 1; } break;
    case 14: if (b <= 0x12) { civSm = 15; civRd[5] = b; } else { civSm = 1; } break;
    case 15: if (b <= 0x03) { civSm = 16; civRd[6] = b; } else { civSm = 1; } break;
    case 16: if (b == 0xFD) { civSm = 1;  civRd[7] = b; } else { civSm = 1; civRd[7] = 0; } break;
  }
}

void civ_request_fast_poll(unsigned long duration_ms) {
  civFastUntilMs = millis() + duration_ms;
  civCurrentInterval = CIV_POLL_INTERVAL_FAST;
}

void civ_setup() {
  if (BAND_DECODER_IN == 2) {
    // TS-480: 4800 bps runs with 2 stop bits, other speeds with 1
    Serial2.begin(SERBAUD2, SERBAUD2 == 4800 ? SERIAL_8N2 : SERIAL_8N1);
    kw_setup();
    return;
  }
  Serial.println(F("--- ICOM CI-V ---"));
  Serial2.begin(SERBAUD2);
  // first poll fires immediately on first civ_loop() tick
  civLastPollMs  = millis() - CIV_POLL_INTERVAL_SLOW;
  civLastParseMs = millis();
}

void civ_loop() {
  if (BAND_DECODER_IN != 1) return;

  // fast-poll window expired → drop back to slow cadence
  if (civFastUntilMs != 0 && (long)(millis() - civFastUntilMs) >= 0) {
    civFastUntilMs = 0;
    civCurrentInterval = CIV_POLL_INTERVAL_SLOW;
  }

  // periodic freq poll
  if (millis() - civLastPollMs >= civCurrentInterval) {
    civ_send_request(0x03);
    civLastPollMs = millis();
  }

  // sniff & parse anything on the bus
  while (Serial2.available() > 0) {
    civ_state_machine((uint8_t)Serial2.read());

    // freq frame complete (cmd 0x00 transceive, 0x03 poll response, or 0x05 set echo)
    if ((civRd[4] == 0x00 || civRd[4] == 0x03 || civRd[4] == 0x05) && civRd[10] == 0xFD) {
      unsigned long f = civ_decode_bcd_freq(civRd[5], civRd[6], civRd[7], civRd[8], civRd[9]);
      civLastParseMs = millis();
      civRd[10] = 0;
      civRd[4]  = 0;
      bool wasInvalid = !CivValid;
      CivValid = true;
      if (wasInvalid || f != CivFreq) {
        CivFreq = f;
        if (serialDebug) { Serial.print(F("[CIV freq=")); Serial.print(CivFreq); Serial.println(']'); }
        civ_publish_freq();
      }
      // chain mode request after a freq response (k3ng pattern)
      civ_send_request(0x04);
    }
    // mode frame complete
    else if (civRd[4] == 0x04 && civRd[7] == 0xFD) {
      uint8_t m = civRd[5];
      CivFilter = civRd[6];              // track IF filter so it can be restored
      civLastParseMs = millis();
      civRd[7] = 0;
      civRd[4] = 0;
      if (m != CivMode) {
        CivMode = m;
        if (serialDebug) {
          Serial.print(F("[CIV mode="));
          if (m < 0x10) Serial.print('0');
          Serial.print(m, HEX);
          Serial.println(']');
        }
        civ_publish_mode();
      }
    }
  }

  // watchdog
  if (CivValid && (millis() - civLastParseMs) > CIV_WATCHDOG_MS) {
    CivValid = false;
    if (serialDebug) Serial.println(F("[CIV watchdog: no data]"));
  }
}
// =================== END ICOM CI-V ===================


// ===================== RIG CAT DISPATCH =====================
// One entry point per CAT action, routed by BAND_DECODER_IN to the ICOM CI-V
// backend above or the KENWOOD backend (kenwood.ino). 0 = no CAT at all.
void cat_loop() {
  if      (BAND_DECODER_IN == 1) civ_loop();
  else if (BAND_DECODER_IN == 2) kw_loop();
}

void cat_send_setfreq(uint32_t hz) {
  if      (BAND_DECODER_IN == 1) civ_send_setfreq(hz);
  else if (BAND_DECODER_IN == 2) kw_send_setfreq(hz);
}

void cat_send_setmode(uint8_t civmode) {
  if      (BAND_DECODER_IN == 1) civ_send_setmode(civmode);
  else if (BAND_DECODER_IN == 2) kw_send_setmode(civmode);
}
// =================== END RIG CAT DISPATCH ===================


// ===================== TRXNET =====================
// HW: shares Ethernet (W5100/W5500) with the ETHERNET section. UDP port 5683.
// Publishes /hz, /mode on change. Subscribes /s-hz, /s-mode (commands from
// peers — translated to CI-V SET on the radio; the radio's echo path through
// civ_state_machine() updates CivFreq/CivMode and re-publishes), /s-cw (keyer)
// and /s-lptune (remote low-power TUNE, see LOW-POWER TUNE; state on /lptune).
// Gating: NET_ID == 0x00 disables TrxNet entirely (protocol sentinel).
// Init is deferred to trxnet_loop() so plug-in after boot works without reset.
// Greeting: on new peer, sends a CON snapshot of /hz + /mode (drained one
// peer per loop iteration, gated until CIV state is known).

// Read by the LCD "Peers" menu item even when TrxNet is compiled out
// (PCB_REV_3_141); stays false on boards without the network stack.
bool        trxNetStarted = false;

// Low-power TUNE driven over TrxNet (/s-lptune) — drop-box filled by the
// callback below, consumed by the LOW-POWER TUNE section. Declared outside
// FEATURE_NET so the tune code compiles unchanged on the 3_141 board.
//   /s-lptune 1 = start, 2 = keepalive (never starts a tune), 0 = stop,
//   3 = query (answered with /lptune, which is how a peer learns we take this).
// A keepalive that cannot start anything is the point: one still in flight
// when the tune aborts must not key the carrier straight back up.
volatile bool          trxLpTuneStart = false;
volatile bool          trxLpTuneQuery = false;
volatile bool          trxLpTuneStop  = false;
volatile unsigned long trxLpTuneKaMs  = 0;
// True for the whole of tune_run(). trxnet_loop() holds /s-hz and /s-mode
// back while it is set, so a remote retune cannot move the rig under the
// carrier; they apply after the restore, the latest command winning.
bool                   tuneActive     = false;
void lptune_publish(uint8_t st);   // /lptune: 0 idle, 1 carrier, 2 refused, 3 aborted

#ifdef FEATURE_NET
#include <TrxNet.h>

EthernetUDP trxUdp;
TrxNet      net(trxUdp);
char        trxDeviceName[TRXNET_MAX_DEVICE_NAME];
// Pointer array handed to net.setPriorityPrefixes(); net keeps this pointer, so
// the array (and the prioPrefix[] it points into) must live for net's lifetime.
const char* prioPtr[PRIO_MAX_COUNT];

volatile uint32_t trxPendingHz   = 0;
volatile uint8_t  trxPendingMode = 0;     // CI-V mode byte
volatile bool     trxSHzPending  = false;
volatile bool     trxSModePending= false;

char     trxPendingGreet[TRXNET_MAX_PEERS][TRXNET_MAX_DEVICE_NAME];
uint8_t  trxPendingGreetCount = 0;

void onPeerJoined(const TrxPeer* peer);
void onSetCw(const char* from, const uint8_t* data, size_t len);  // defined in KEYER block
void onWlHost(const char* from, const uint8_t* data, size_t len); // rpi_status.ino

void civ_publish_freq() {
  if (!trxNetStarted) return;
  uint32_t f = CivFreq;
  net.publish("/hz", (uint8_t*)&f, sizeof(f));
}

void civ_publish_mode() {
  if (!trxNetStarted) return;
  uint8_t m = CivMode;
  net.publish("/mode", &m, sizeof(m));
}

static void onSetHz(const char* /*from*/, const uint8_t* data, size_t len) {
  if (len < sizeof(uint32_t)) return;
  memcpy((void*)&trxPendingHz, data, sizeof(uint32_t));
  trxSHzPending = true;
}

static void onSetMode(const char* /*from*/, const uint8_t* data, size_t len) {
  if (len < sizeof(uint8_t)) return;
  trxPendingMode = data[0];
  trxSModePending = true;
}

static void onSetLpTune(const char* /*from*/, const uint8_t* data, size_t len) {
  if (len < 1) return;
  if (data[0] == 0) { trxLpTuneStop = true; return; }
  if (data[0] == 3) { trxLpTuneQuery = true; return; }
  trxLpTuneKaMs = millis();              // start and keepalive both feed the dead-man
  if (data[0] == 1) trxLpTuneStart = true;
}

void lptune_publish(uint8_t st) {
  if (!trxNetStarted) return;
  net.publish("/lptune", &st, 1);
}

// /s-ptt lease (TrxNet INTEGRATION.md 7.3): remote PTT for audio modes -- a
// peer (local-trx) keying this rig for JS8/WSPR while the audio comes from a
// PC sound card. The holder renews "1" every <= 500 ms; none for
// TRX_PTT_LEASE_MS and PTT drops by itself, so a crashed peer or a pulled
// cable cannot leave the rig keyed. One more PTT source for the sequencer,
// ORed in by ptt_inputs_poll(). Started or refused by netptt_service().
#define TRX_PTT_LEASE_MS 1500UL
char                   trxPttHolder[TRXNET_MAX_DEVICE_NAME] = {0};   // "" = free
volatile bool          trxPttWant    = false;
volatile unsigned long trxPttRenewMs = 0;
bool                   trxPttKeyed   = false;   // the lease output

static void onSetPtt(const char* from, const uint8_t* data, size_t len) {
  if (len < 1 || !from || !from[0]) return;
  bool held = trxPttHolder[0] != '\0';
  if (held && strcmp(trxPttHolder, from) != 0) return;   // another peer holds it
  if (data[0] == 1) {
    if (!held) {
      strncpy(trxPttHolder, from, TRXNET_MAX_DEVICE_NAME - 1);
      trxPttHolder[TRXNET_MAX_DEVICE_NAME - 1] = '\0';
    }
    trxPttRenewMs = millis();
    trxPttWant = true;
  } else {
    trxPttWant = false;
  }
}

// /ptt answer to the holder: 1 keyed, 0 released or refused.
void netptt_publish(uint8_t st) {
  if (!trxNetStarted || trxPttHolder[0] == '\0') return;
  net.publishTo(trxPttHolder, "/ptt", &st, 1, TRX_NON);
}

// The PTT source. The lease is checked here rather than in netptt_service(),
// so it also lapses inside the blocking keyer/tune loops -- they all pump
// ptt_loop(), which polls this.
bool netptt_wanted() {
  return trxPttKeyed && trxPttWant && (millis() - trxPttRenewMs) <= TRX_PTT_LEASE_MS;
}

void onPeerJoined(const TrxPeer* peer) {
  if (!peer) return;
  if (trxPendingGreetCount >= TRXNET_MAX_PEERS) return;
  strncpy(trxPendingGreet[trxPendingGreetCount], peer->name, TRXNET_MAX_DEVICE_NAME - 1);
  trxPendingGreet[trxPendingGreetCount][TRXNET_MAX_DEVICE_NAME - 1] = '\0';
  trxPendingGreetCount++;
}

static void republishState(const char* peerName) {
  uint32_t f = CivFreq;
  uint8_t  m = CivMode;
  net.publishTo(peerName, "/hz",   (uint8_t*)&f, sizeof(f), TRX_CON);
  net.publishTo(peerName, "/mode", &m,            sizeof(m), TRX_CON);
  // Also announces that this keyer takes /s-lptune: a peer that never hears
  // /lptune must not offer a remote tune it cannot get.
  uint8_t t = tuneActive ? 1 : 0;
  net.publishTo(peerName, "/lptune", &t,          sizeof(t), TRX_CON);
}

void trxnet_setup() {
  Serial.println(F("--- TRXNET ---"));
  if (NET_ID == 0x00) {
    Serial.println(F("TrxNet disabled (NET_ID=0x00)"));
    return;
  }
  // net.begin() is deferred to trxnet_loop() until Ethernet link is up.
  Serial.println(F("TrxNet waiting for ETH link"));
}

void trxnet_loop() {
  // Deferred init / re-probe on link-up
  if (NET_ID != 0x00 && EthernetEnable && EthModulePresent && EthLinkStatus && ethernet_has_ip()) {
    if (!trxNetStarted) {
      snprintf(trxDeviceName, sizeof(trxDeviceName), "OI3.%02x", NET_ID);
      net.setPort(UdpPort);
      net.onPeerAdded(onPeerJoined);   // must be set BEFORE begin()
      net.begin(trxDeviceName);
      net.subscribe("/s-hz",   onSetHz);
      net.subscribe("/s-mode", onSetMode);
      net.subscribe("/s-cw",   onSetCw);
      net.subscribe("/s-lptune", onSetLpTune);
      net.subscribe("/s-ptt",  onSetPtt);
      net.subscribe("/wl-host", onWlHost);   // the Pi's state for the "RPI" menu item
#if TRXNET_VERSION >= 0x0104
      for (uint8_t i = 0; i < prioCount; i++) prioPtr[i] = prioPrefix[i];
      net.setPriorityPrefixes(prioCount ? prioPtr : nullptr, prioCount);
#endif
      trxNetStarted = true;
      Serial.print(F("TrxNet begin: "));
      Serial.println(trxDeviceName);
    }
    net.loop();
  }

  if (trxSHzPending && !tuneActive) {
    trxSHzPending = false;
    cat_send_setfreq(trxPendingHz);
  }
  if (trxSModePending && !tuneActive) {
    trxSModePending = false;
    cat_send_setmode(trxPendingMode);
  }

  // Drain greeting queue — one peer per iteration. Gated until CIV state is
  // populated so peers don't get a /hz=0 or /mode=0xFF snapshot.
  if (trxPendingGreetCount > 0 && trxNetStarted
      && CivValid && CivFreq != 0 && CivMode != 0xFF) {
    trxPendingGreetCount--;
    republishState(trxPendingGreet[trxPendingGreetCount]);
  }
}
#else  // !FEATURE_NET — no TrxNet on this PCB (PCB_REV_3_141)
void trxnet_setup()     {}
void trxnet_loop()      {}
void civ_publish_freq() {}
void civ_publish_mode() {}
void lptune_publish(uint8_t) {}
bool netptt_wanted()    { return false; }
#endif // FEATURE_NET
// =================== END TRXNET ===================


// ===================== PTT SEQUENCER =====================
// HW: PTT1=D41 (DB25 pin 8 / REM), PTT2=D22 (DB25 pin 20 / DAT),
//     PTT3=D25 (DB25 pin 22 / MIC), PTTPA=D31, SEQUENCER=D40,
//     INTERLOCK=D2 (in, dual), FootSW=D19 (in, LOW=TX), PTT232=D3 (in, HIGH=TX).
// Non-blocking 6-level state machine ported from k3ng OpenInterfaceSequencer():
//   level 0 -> 5 (SEQ on) -> 4 (PA on) -> 1/2/3 (PTT123 on)  with lead delays
//   level 1/2/3 -> 4 (PTT123 off) -> 5 (PA off) -> 0 (SEQ off) with tail delays
// PTT output 1/2/3 selected by PttOutByCivMode[CivMode], fallback PTTmodeDefault
// when !CivValid or mode unknown.
// InterlockEnable=1: D2 is safety interlock from PA — toggle on change; when
// active during TX, abort the sequencer immediately (drop all PTT/PA/SEQ LOW).
// InterlockEnable=0: D2 is a PTT-in (LOW=TX); sets pttExternal=true so the
// sequencer stops at level 4 (PA up, PTT123 skipped — external system drives
// PTT line into the radio itself).

const int PTT_PINS[4] = {0, PTT1, PTT2, PTT3};  // 1-based index, [0] unused

byte          PttOutByCivMode[16];
byte          SequencerLevel       = 0;       // 0=off, 1/2/3=PTT123, 4=PA, 5=SEQ
bool          PttActive            = false;
bool          pttExternal          = false;
byte          ptt_interlock_active = 0;
// Keyer-owned TX request: the CW/RTTY keyer is a PTT source just like FootSw /
// PTT232 / interlock-in. ptt_inputs_poll() ORs this in so the level-based poll
// cannot clobber a PTT the keyer is holding between elements. Written only by
// the KEYER block (begin_tx / tail_service / abort), read here.
bool          keyerPttRequest      = false;
// Low-power TUNE PTT source — held true by tune_run() while the tuning carrier is
// on the air. ORed into ptt_inputs_poll() like keyerPttRequest so the level poll
// cannot drop PTT under the tune. Written only by the LOW-POWER TUNE section.
bool          tunePttRequest       = false;
// PTT-output test source — held true by the LCD while MODE is pressed in item
// 15 EDITING. Runs the normal sequencer (SEQ -> PA -> selected PTT1/2/3), so
// interlock, PttOutputEnable and timings apply. Written only by lcd_loop().
bool          pttTestRequest       = false;
// KENWOOD TUNE: the rig keys itself via CAT "TX2;", so the sequencer stops at
// level 4 (SEQ + PA up, PTT123 skipped) exactly like pttExternal.
bool          tuneCatPtt           = false;
byte          PttOut               = 3;        // current selected PTT output 1/2/3
unsigned long LastSeqChange        = 0;
// Global PTT-output enable. false = the sequencer asserts NO output (PTT123 / PA /
// SEQ) from ANY source and the keyer keys CW/FSK directly without waiting on the
// sequencer (rig break-in brings itself into TX). Toggled via LCD menu item 24;
// always true after reboot (not persisted, no cfg override).
bool          PttOutputEnable      = true;

byte ptt_output_for_civmode() {
  // Fallback is range-checked too: a bad PTTmodeDefault (from cfg/SD) must never
  // propagate to PttOut and index PTT_PINS[] out of bounds.
  byte fallback = (PTTmodeDefault >= 1 && PTTmodeDefault <= 3) ? PTTmodeDefault : 3;
  if (!CivValid || CivMode == 0xFF) return fallback;
  if (CivMode >= 16)                return fallback;
  byte v = PttOutByCivMode[CivMode];
  if (v < 1 || v > 3)               return fallback;
  return v;
}

void ptt_request(bool tx) {
  if (tx == PttActive) return;
  PttActive = tx;
  if (tx) PttOut = ptt_output_for_civmode();
  LastSeqChange = millis();
}

static void ptt_abort_all() {
  digitalWrite(SEQUENCER, LOW);
  digitalWrite(PTTPA, LOW);
  digitalWrite(PTT1, LOW);
  digitalWrite(PTT2, LOW);
  digitalWrite(PTT3, LOW);
  SequencerLevel = 0;
  PttActive = false;
  rkey_abort();          // remote CW stream: release CW1/CW2, flush, mute
}

// Non-blocking port of k3ng OpenInterfaceSequencer(). State transitions are
// gated by millis() deltas instead of delay().
static void ptt_sequencer_step() {
  if (ptt_interlock_active == 1) {
    if (SequencerLevel != 0) ptt_abort_all();
    return;
  }
  unsigned long now = millis();
  switch (SequencerLevel) {
    case 0:
      if (PttActive) {
        digitalWrite(SEQUENCER, HIGH);
        LastSeqChange = now;
        SequencerLevel = 5;
        if (serialDebug) Serial.println(F("[PTT SEQ-H]"));
      }
      break;
    case 5:  // SEQ up — wait SEQUENCERlead, then PA up; or on release wait SEQUENCERtail then SEQ down
      if (PttActive && (now - LastSeqChange) >= (unsigned long)SEQUENCERlead) {
        digitalWrite(PTTPA, HIGH);
        LastSeqChange = now;
        SequencerLevel = 4;
        if (serialDebug) Serial.println(F("[PTT PA-H]"));
      } else if (!PttActive && (now - LastSeqChange) >= (unsigned long)SEQUENCERtail) {
        digitalWrite(SEQUENCER, LOW);
        LastSeqChange = now;
        SequencerLevel = 0;
        if (serialDebug) Serial.println(F("[PTT SEQ-L]"));
      }
      break;
    case 4:  // PA up — wait PAlead then PTT123 up (skipped if pttExternal / tuneCatPtt); or on release wait PAtail then PA down
      if (PttActive && !pttExternal && !tuneCatPtt && (now - LastSeqChange) >= (unsigned long)PAlead) {
        digitalWrite(PTT_PINS[PttOut], HIGH);
        LastSeqChange = now;
        SequencerLevel = PttOut;
        if (serialDebug) { Serial.print(F("[PTT")); Serial.print(PttOut); Serial.println(F("-H]")); }
      } else if (!PttActive && (now - LastSeqChange) >= (unsigned long)PAtail) {
        digitalWrite(PTTPA, LOW);
        LastSeqChange = now;
        SequencerLevel = 5;
        if (serialDebug) Serial.println(F("[PTT PA-L]"));
      }
      break;
    case 1:
    case 2:
    case 3:
      if (!PttActive && (now - LastSeqChange) >= (unsigned long)PTTtail) {
        digitalWrite(PTT_PINS[SequencerLevel], LOW);
        LastSeqChange = now;
        if (serialDebug) { Serial.print(F("[PTT")); Serial.print(SequencerLevel); Serial.println(F("-L]")); }
        SequencerLevel = 4;
      } else if (PttActive) {
        // PTT continues — refresh LastSeqChange so next tail starts only on release
        LastSeqChange = now;
      }
      break;
  }
}

static void ptt_inputs_poll() {
  // Each source keeps its own TX request; the resulting TX is the OR of all of
  // them, so releasing one source never drops TX while another still asserts it.
  bool footSwTx = (digitalRead(FootSW) == LOW);    // active-low (pull-up): pressed = TX
  bool ptt232Tx = (digitalRead(PTT232) == HIGH);   // active-high: HIGH = TX
  bool ilIn     = (digitalRead(INTERLOCK) == LOW); // interlock pin asserted (active-low)
  bool ilInTx   = false;

  if (InterlockEnable) {
    // Safety interlock from the PA: LEVEL-based, sampled every poll. An interlock
    // already asserted at boot is honoured, and a bounce cannot latch the wrong
    // state — the real pin level always determines the safe state.
    byte active = ilIn ? 1 : 0;
    if (active != ptt_interlock_active && serialDebug) {
      Serial.print(F("[Interlock="));
      Serial.print(active);
      Serial.println(']');
    }
    ptt_interlock_active = active;
    pttExternal = false;
  } else {
    // Interlock pin repurposed as an extra PTT input (active-low = TX).
    // pttExternal skips PTT123 in the sequencer for this external source.
    ilInTx = ilIn;
    pttExternal = ilIn;
    ptt_interlock_active = 0;
  }

  // ptt_request() is idempotent (no-op when unchanged), so calling it every poll
  // with the OR is cheap and keeps TX asserted as long as any source requests it.
  // keyerPttRequest is the CW/RTTY keyer's source: without it, this level-based
  // poll would reset PttActive to false on every iteration while the keyer is
  // mid-element (none of the HW inputs are active for paddle-driven keying).
  // PttOutputEnable=false (LCD item 24) globally suppresses every source, so
  // PttActive stays false and the sequencer never leaves level 0 — no PTT123 / PA
  // / SEQ output. CW/FSK keying is unaffected (the keyer bypasses the gate below).
  ptt_request(PttOutputEnable
              && (footSwTx || ptt232Tx || ilInTx || keyerPttRequest || tunePttRequest
                  || pttTestRequest || rkey_ptt_wanted() || netptt_wanted()));
}

void ptt_setup() {
  Serial.println(F("--- PTT SEQUENCER ---"));
  pinMode(PTT1, OUTPUT);      digitalWrite(PTT1, LOW);
  pinMode(PTT2, OUTPUT);      digitalWrite(PTT2, LOW);
  pinMode(PTT3, OUTPUT);      digitalWrite(PTT3, LOW);
  pinMode(PTTPA, OUTPUT);     digitalWrite(PTTPA, LOW);
  pinMode(SEQUENCER, OUTPUT); digitalWrite(SEQUENCER, LOW);
  pinMode(INTERLOCK, INPUT_PULLUP);
  pinMode(FootSW,    INPUT_PULLUP);
  pinMode(PTT232,    INPUT);
  pinMode(WINKEY, OUTPUT); digitalWrite(WINKEY, LOW);  // permanently power DTR/RTS switching elements (PTT-232 feeds sequencer via PTT232)

  for (uint8_t i = 0; i < 16; i++) PttOutByCivMode[i] = 0xFF;
  PttOutByCivMode[0x00] = PTTmodeLSB;
  PttOutByCivMode[0x01] = PTTmodeUSB;
  PttOutByCivMode[0x02] = PTTmodeAM;
  PttOutByCivMode[0x03] = PTTmodeCW;
  PttOutByCivMode[0x04] = PTTmodeRTTY;
  PttOutByCivMode[0x05] = PTTmodeFM;
  PttOutByCivMode[0x07] = PTTmodeCWR;
  PttOutByCivMode[0x08] = PTTmodeRTR;

  // Sanitize cfg/SD-provided default once, so every fallback path (incl. menu
  // edit at case 15) sees a valid 1..3 output index.
  if (PTTmodeDefault < 1 || PTTmodeDefault > 3) PTTmodeDefault = 3;

  PttOut = PTTmodeDefault;
  SequencerLevel = 0;
  PttActive = false;
}

void ptt_loop() {
  ptt_inputs_poll();
  ptt_sequencer_step();
}
// =================== END PTT SEQUENCER ===================


// ===================== KEYER (CW + RTTY) =====================
// HW: PADDLEL=D26 (dit), PADDLER=D28 (dah), INPUT_PULLUP, LOW=pressed.
//     CW1=D34 / CW2=D35 = CW key output (driven via PTT sequencer).
//     FSK=D23 = RTTY FSK key. Idle = HIGH-Z (pinMode INPUT, line released);
//     driven OUTPUT only during RTTY TX. The OI3 FSK keying circuit interprets
//     any active MCU drive (HIGH or LOW) as keyed, so floating the pin between
//     sessions is the only correct way to release. During TX: start=SPACE,
//     data LSB-first, stop=MARK 1.5 bits, then released by ptt_tail_service
//     after 7-dit silence. Polarity (KeyerFskReverseNow) flips MARK/SPACE
//     drive levels but does not affect the idle release behaviour.
//     TONE=D4 = sidetone (shared with LCD menu beep, no mutex).
//
// Ported from K3NG CW Keyer by Anthony Good K3NG
//   https://github.com/k3ng/k3ng_cw_keyer
//
// Behaviour:
// - Paddles always live: sidetone + ASCII decoder run regardless of mode.
// - CW / CWR (CivMode 0x03 / 0x07): paddle keys CW1/CW2 via sequencer;
//   /s-cw chars are played as morse through the same path. Paddle touch
//   flushes any pending /s-cw send buffer (paddle has priority).
// - RTTY / RTR (0x04 / 0x08): decoded paddle ASCII + /s-cw chars are
//   enqueued to the RTTY FSK state machine (non-blocking, millis() paced).
//   FSK pin clocks bits at KeyerRttyBaudNow Bd; sidetone of dits/dahs
//   continues for the operator's ear only.
// - Other modes (LSB/USB/AM/FM, or !CivValid): sidetone + LCD echo only,
//   no TX path activated.
// - PTT timing: first element (sidetone + key) defers until the sequencer
//   reaches SequencerLevel == PttOut, then waits PTTlead ms (relay settle)
//   before keying. PTTtail is applied by the sequencer on release.
// - WPM editable via DWN (down) / UP (up) when LCD is in PINNED state
//   (handled in LCD RUNTIME — this module exposes keyer_set_wpm()).
// - EEPROM addrs 1..6 persist user changes (5 s debounced flush).
//   On boot EEPROM > cfg (cfg only used if EEPROM byte == 0xFF).
//
// Public API for the rest of the firmware:
//   keyer_setup()           - init pins, load EEPROM, register state
//   keyer_loop()            - drain TrxNet, run paddle/buffer/RTTY state
//   keyer_enqueue_char(c)   - add a single char to the send queue
//   keyer_set_wpm(w)        - change WPM, mark EEPROM dirty (debounced)
//   keyer_abort()           - flush buffer + drop PTT immediately

#include <EEPROM.h>

// --- EEPROM map (addr 0 owned by LCD RUNTIME) ---
const uint8_t KEYER_EEPROM_WPM_ADDR        = 1;
const uint8_t KEYER_EEPROM_MODE_ADDR       = 2;   // 0=A, 1=B
const uint8_t KEYER_EEPROM_REVERSE_ADDR    = 3;   // 0=normal, 1=swapped
const uint8_t KEYER_EEPROM_SIDETONE_LO     = 4;
const uint8_t KEYER_EEPROM_SIDETONE_HI     = 5;
const uint8_t KEYER_EEPROM_RTTYBAUD_ADDR   = 6;
const uint8_t KEYER_EEPROM_FSKREV_ADDR     = 7;   // 0=normal, 1=reverse polarity
const unsigned long KEYER_EEPROM_DEBOUNCE_MS = 5000;

// --- Runtime state (loaded from EEPROM, falls back to cfg defaults) ---
uint8_t  KeyerWpm           = 28;     // active WPM
char     KeyerActiveMode    = 'B';    // active iambic mode 'A' or 'B'
bool     KeyerPaddleSwap    = false;  // current paddle reverse state
uint16_t KeyerSidetoneNow   = 600;    // 0 = sidetone off
uint8_t  KeyerRttyBaudNow   = 45;     // 45/50/75/100
bool     KeyerFskReverseNow = false;  // FSK polarity flip (runtime)

// --- Keyer FSM ---
enum KeyerState : uint8_t {
  KEYER_IDLE     = 0,
  KEYER_WAIT_SEQ,        // PTT requested, waiting for SequencerLevel == PttOut
  KEYER_CW_KEYING,       // playing a CW element (paddle- or buffer-driven)
  KEYER_RTTY_TX,         // RTTY FSK bits being clocked out
};
static KeyerState keyerState = KEYER_IDLE;

// --- CW send buffer (chars enqueued from TrxNet /s-cw or local source) ---
const uint8_t KEYER_SENDBUF_SIZE = 65;
static char    keyerSendBuf[KEYER_SENDBUF_SIZE];
static uint8_t keyerSendHead = 0;
static uint8_t keyerSendTail = 0;
const char     KEYER_LCD_SPACE_MARKER = 0x01;  // internal, not sent on CW/RTTY

// --- RTTY TX state machine (45.45 Bd default: ~22 ms per bit) ---
static uint8_t       keyerRttyCode      = 0;     // current Baudot 5-bit code
static uint8_t       keyerRttyBitIdx    = 0;     // 0=start, 1..5=data, 6=stop
static unsigned long keyerRttyNextBitMs = 0;
static unsigned long keyerRttyBitMs     = 22;    // 1000/45.45 ≈ 22

// --- Paddle decoder (k3ng-style: long number, 1=dit, 2=dah) ---
static long          keyerDecodeBuf     = 0;
static unsigned long keyerDecodeNextMs  = 0;
static bool          keyerSpaceSent     = true;

// --- EEPROM debounced flush ---
static unsigned long keyerEepromDirtyMs = 0;
static bool          keyerEepromDirty   = false;

// --- LCD row-1 TX text cursor (wrap mode) ---
static uint8_t       keyerLcdTxCol      = 0;
// When true, keyer_lcd_putc drops chars from LCD (TX still happens on the air).
// Set by LCD RUNTIME during a WPM-change overlay so transient chars don't
// overwrite the "WPM 28" notification on row 1.
static bool          keyerRow1Locked    = false;
// True while the LCD menu item "IPkey" is selected: row 1 shows the remote
// CW key trace (rkey_trace16) instead of the keyer TX echo.
static bool          rkeyRow1           = false;
// True while the LCD menu item "RPI" is selected: row 1 shows the Pi's state
// (rpi_status.ino). Unlike IPkey, TX text still wins: the first character
// sent takes row 1 over (rpiYield) and lcd_rpi_row1() hands it back
// RPI_TX_HOLD_MS after the last one, with PTT down and nothing queued.
static bool          rpiRow1            = false;
static bool          rpiYield           = false;
static unsigned long keyerLcdLastMs     = 0;
const unsigned long  RPI_TX_HOLD_MS     = 2000;

// --- TrxNet /s-cw drop-box (filled by onSetCw callback, drained in loop) ---
static char          trxPendingCW[KEYER_SENDBUF_SIZE];
static volatile bool trxCwPending       = false;
static volatile bool trxCwAbort         = false;

// --- Forward decls ---
void keyer_setup();
void keyer_loop();
void keyer_enqueue_char(char c);
void keyer_set_wpm(uint8_t w);
void keyer_abort();

// ----- TrxNet subscriber callback -----
// Spec sentinel for abort = 0x03 (ETX); 0xFF tolerated for legacy k3ng peers.
void onSetCw(const char* /*from*/, const uint8_t* data, size_t len) {
  if (len == 1 && (data[0] == 0x03 || data[0] == 0xFF)) { trxCwAbort = true; return; }
  size_t n = (len < KEYER_SENDBUF_SIZE - 1) ? len : (KEYER_SENDBUF_SIZE - 1);
  memcpy(trxPendingCW, data, n);
  trxPendingCW[n] = '\0';
  trxCwPending = true;
}

// ----- LCD row-1 writer (wrap mode, eats trailing spaces) -----
// Called after each element/char has actually been transmitted, so the LCD
// is a truthful log of what went on the air.
static void keyer_lcd_putc(char c) {
  if (keyerRow1Locked || rkeyRow1) return;   // LCD overlay / Rkey trace owns row 1
  if (rpiRow1 && !rpiYield) {
    if (c == ' ') return;                    // a lone space is no reason to take over
    lcd.setCursor(0, 1);                     // TX text replaces the Pi's state...
    lcd.print(F("                "));
    keyerLcdTxCol = 0;
    rpiYield = true;                         // ...until lcd_rpi_row1() takes it back
  }
  keyerLcdLastMs = millis();
  // Space at end of row gets eaten — no wrap on whitespace
  if (c == ' ' && keyerLcdTxCol >= 16) return;
  if (keyerLcdTxCol >= 16) {
    lcd.setCursor(0, 1);
    lcd.print(F("                "));
    keyerLcdTxCol = 0;
  }
  lcd.setCursor(keyerLcdTxCol, 1);
  lcd.write((uint8_t)c);
  keyerLcdTxCol++;
}

// ----- Morse encode table (uppercase ASCII → "." dit / "-" dah pattern) -----
static const char* keyer_morse_for(char c) {
  if (c >= 'a' && c <= 'z') c -= 32;
  switch (c) {
    case 'A': return ".-";       case 'B': return "-...";
    case 'C': return "-.-.";     case 'D': return "-..";
    case 'E': return ".";        case 'F': return "..-.";
    case 'G': return "--.";      case 'H': return "....";
    case 'I': return "..";       case 'J': return ".---";
    case 'K': return "-.-";      case 'L': return ".-..";
    case 'M': return "--";       case 'N': return "-.";
    case 'O': return "---";      case 'P': return ".--.";
    case 'Q': return "--.-";     case 'R': return ".-.";
    case 'S': return "...";      case 'T': return "-";
    case 'U': return "..-";      case 'V': return "...-";
    case 'W': return ".--";      case 'X': return "-..-";
    case 'Y': return "-.--";     case 'Z': return "--..";
    case '0': return "-----";    case '1': return ".----";
    case '2': return "..---";    case '3': return "...--";
    case '4': return "....-";    case '5': return ".....";
    case '6': return "-....";    case '7': return "--...";
    case '8': return "---..";    case '9': return "----.";
    case '.': return ".-.-.-";   case ',': return "--..--";
    case '?': return "..--..";   case '/': return "-..-.";
    case '=': return "-...-";    // BT (break)
    case '+': return ".-.-.";    // AR (end of message)
    case '(': return "-.--.";    // KN (invitation to specific station)
    case ')': return "-.--.-";
    case '&': return "...-.-";   // SK (end of contact)
    case '*': return "-...-.-";  // BK (break-in)
    case '@': return ".--.-.";   case ':': return "---...";
    case '-': return "-....-";   case ' ': return " ";   // sentinel for wordspace
    default:  return NULL;
  }
}

// ----- Paddle-decoder reverse table (k3ng convert_cw_number_to_ascii + SK) -----
// 1 = dit, 2 = dah; accumulated as decimal digits.
static char keyer_decode_morse(long n) {
  switch (n) {
    case 12: return 'A';        case 2111: return 'B';
    case 2121: return 'C';      case 211: return 'D';
    case 1: return 'E';         case 1121: return 'F';
    case 221: return 'G';       case 1111: return 'H';
    case 11: return 'I';        case 1222: return 'J';
    case 212: return 'K';       case 1211: return 'L';
    case 22: return 'M';        case 21: return 'N';
    case 222: return 'O';       case 1221: return 'P';
    case 2212: return 'Q';      case 121: return 'R';
    case 111: return 'S';       case 2: return 'T';
    case 112: return 'U';       case 1112: return 'V';
    case 122: return 'W';       case 2112: return 'X';
    case 2122: return 'Y';      case 2211: return 'Z';
    case 22222: return '0';     case 12222: return '1';
    case 11222: return '2';     case 11122: return '3';
    case 11112: return '4';     case 11111: return '5';
    case 21111: return '6';     case 22111: return '7';
    case 22211: return '8';     case 22221: return '9';
    case 112211: return '?';    case 21121: return '/';
    case 221122: return ',';    case 121212: return '.';
    case 122121: return '@';    case 21112:  return '=';   // BT
    case 12121: return '+';     // AR
    case 21221: return '(';     // KN
    case 2111212: return '*';   // BK
    case 111212: return '&';    // SK (added per design decision)
    default:    return '*';     // unknown → asterisk (k3ng convention)
  }
}

// ----- Baudot (ITA2) encode table for RTTY FSK output -----
// Returns 5-bit code or -1 if not encodable. *needFigs set true if char
// requires the FIGS shift (digits, punctuation), false for letters/space/CR/LF.
static int8_t keyer_baudot_for(char c, bool* needFigs) {
  if (c >= 'a' && c <= 'z') c -= 32;
  *needFigs = false;
  switch (c) {
    case 'A': return 0x03;   case 'B': return 0x19;
    case 'C': return 0x0E;   case 'D': return 0x09;
    case 'E': return 0x01;   case 'F': return 0x0D;
    case 'G': return 0x1A;   case 'H': return 0x14;
    case 'I': return 0x06;   case 'J': return 0x0B;
    case 'K': return 0x0F;   case 'L': return 0x12;
    case 'M': return 0x1C;   case 'N': return 0x0C;
    case 'O': return 0x18;   case 'P': return 0x16;
    case 'Q': return 0x17;   case 'R': return 0x0A;
    case 'S': return 0x05;   case 'T': return 0x10;
    case 'U': return 0x07;   case 'V': return 0x1E;
    case 'W': return 0x13;   case 'X': return 0x1D;
    case 'Y': return 0x15;   case 'Z': return 0x11;
    case ' ':  return 0x04;  case '\r': return 0x08;
    case '\n': return 0x02;
    case '0':  *needFigs = true; return 0x16;
    case '1':  *needFigs = true; return 0x17;
    case '2':  *needFigs = true; return 0x13;
    case '3':  *needFigs = true; return 0x01;
    case '4':  *needFigs = true; return 0x0A;
    case '5':  *needFigs = true; return 0x10;
    case '6':  *needFigs = true; return 0x15;
    case '7':  *needFigs = true; return 0x07;
    case '8':  *needFigs = true; return 0x06;
    case '9':  *needFigs = true; return 0x18;
    case '-':  *needFigs = true; return 0x03;
    case '?':  *needFigs = true; return 0x19;
    case ':':  *needFigs = true; return 0x0E;
    case '(':  *needFigs = true; return 0x0F;
    case ')':  *needFigs = true; return 0x12;
    case '.':  *needFigs = true; return 0x1C;
    case ',':  *needFigs = true; return 0x0C;
    case '/':  *needFigs = true; return 0x1D;
    case '=':  *needFigs = true; return 0x1E;
    case '\'': *needFigs = true; return 0x05;
    default: return -1;
  }
}
static const uint8_t BAUDOT_LTRS = 0x1F;
static const uint8_t BAUDOT_FIGS = 0x1B;
static bool keyerRttyShiftFigs = false;

// ----- Paddle state (k3ng-style buffers + iambic A flag) -----
static byte    keyerDitBuf       = 0;
static byte    keyerDahBuf       = 0;
static byte    keyerBeingSent    = 0;   // 0=none, 1=dit, 2=dah (current element)
static byte    keyerLastSent     = 1;   // last element played (for squeeze alternation)
static byte    keyerIambicAFlag  = 0;   // iambic A: tracks simultaneous press during element
static unsigned long keyerLastTxMs = 0; // for PTT hang-time release
enum KeyerSending : uint8_t { KEYS_NONE = 0, KEYS_MANUAL = 1, KEYS_AUTO = 2 };
static KeyerSending keyerSendingMode = KEYS_NONE;
static bool    keyerAutoInterrupted = false;
const uint8_t  KEYER_CMOS_SUPER_KEYER_B_TIMING_PERCENT = 33;

// ----- FSK polarity & line release helpers -----
// MARK and SPACE bit levels flip together when KeyerFskReverseNow is true.
// Between RTTY sessions the line is RELEASED (pinMode INPUT, high-Z) so any
// external pull-up or opto-driver pull network sets the actual line level —
// driving the pin in either state from the MCU would keep the FSK keying
// circuit actively switched (the OI3 hardware behaviour).
static inline int keyer_fsk_mark()  { return KeyerFskReverseNow ? LOW  : HIGH; }
static inline int keyer_fsk_space() { return KeyerFskReverseNow ? HIGH : LOW;  }
static inline void keyer_fsk_release() { pinMode(FSK, INPUT); }
static inline void keyer_fsk_drive_space() { pinMode(FSK, OUTPUT); digitalWrite(FSK, keyer_fsk_space()); }
static inline void keyer_fsk_drive_mark()  { pinMode(FSK, OUTPUT); digitalWrite(FSK, keyer_fsk_mark());  }

// ----- Paddle pin reads (respects KeyerPaddleSwap) -----
// Default (KeyerPaddleSwap=false): dit = PADDLEL (D26), dah = PADDLER (D28),
// matching the hardware labelling and oi3.cfg ("0 = PADDLEL is dit").
// KeyerPaddleSwap=true swaps to dit = PADDLER, dah = PADDLEL.
static inline bool keyer_paddle_dit_pressed() {
  return digitalRead(KeyerPaddleSwap ? PADDLER : PADDLEL) == LOW;
}
static inline bool keyer_paddle_dah_pressed() {
  return digitalRead(KeyerPaddleSwap ? PADDLEL : PADDLER) == LOW;
}

// ----- Paddle scan -----
// During an element, read only the OPPOSITE paddle (squeeze buffering).
// When idle, read both. For iambic A, track simultaneous press during element.
static void keyer_check_paddles() {
  if (keyerBeingSent == 1) {
    if (keyer_paddle_dah_pressed()) keyerDahBuf = 1;
  } else if (keyerBeingSent == 2) {
    if (keyer_paddle_dit_pressed()) keyerDitBuf = 1;
  } else {
    if (keyer_paddle_dit_pressed()) keyerDitBuf = 1;
    if (keyer_paddle_dah_pressed()) keyerDahBuf = 1;
  }
  if (KeyerActiveMode == 'A' && (keyerBeingSent == 1 || keyerBeingSent == 2)
      && keyer_paddle_dit_pressed() && keyer_paddle_dah_pressed()) {
    keyerIambicAFlag = 1;
  }
}

// K3NG CMOS Super Keyer timing: during the first part of an element, defer
// opposite-paddle latching and clear an early squeeze. After the threshold,
// scan the opposite paddle normally. This makes iambic B less eager to create
// an extra trailing element.
static void keyer_check_paddles_cmos(unsigned long elapsed_us, unsigned long total_us) {
  if (keyerBeingSent == 0 || total_us == 0) {
    keyer_check_paddles();
    return;
  }

  bool ditPressed = keyer_paddle_dit_pressed();
  bool dahPressed = keyer_paddle_dah_pressed();

  if (KeyerActiveMode == 'A' && ditPressed && dahPressed) {
    keyerIambicAFlag = 1;
  }

  if ((elapsed_us * 100UL) >= (total_us * KEYER_CMOS_SUPER_KEYER_B_TIMING_PERCENT)) {
    if (keyerBeingSent == 1) {
      if (dahPressed) keyerDahBuf = 1;
    } else if (keyerBeingSent == 2) {
      if (ditPressed) keyerDitBuf = 1;
    }
  } else if (ditPressed && dahPressed) {
    keyerDitBuf = 0;
    keyerDahBuf = 0;
  }
}

static uint16_t keyer_sidetone_hz_for_mode() {
  if (KeyerSidetoneNow != 0) return KeyerSidetoneNow;
  if (CivValid && (CivMode == 0x04 || CivMode == 0x08)) return 600;
  return 0;
}

// ----- Wait with module pumping & paddle scanning -----
// CW elements and RTTY bits block for tens to hundreds of ms — pump other
// module loops here so TrxNet CON ACKs, CI-V polling, Ethernet keepalive,
// and the PTT sequencer all keep advancing. LCD is skipped to avoid display
// re-entrancy during element timing.
static void keyer_wait_us_pump(unsigned long us) {
  unsigned long start = micros();
  unsigned long elapsed;
  while ((elapsed = micros() - start) < us) {
    ethernet_loop();
    trxnet_loop();
    rkey_loop();
    cat_loop();
    ptt_loop();
    keyer_check_paddles_cmos(elapsed, us);
    if (trxCwAbort) break;
    if (keyerSendingMode == KEYS_AUTO &&
        (keyer_paddle_dit_pressed() || keyer_paddle_dah_pressed()
         || keyerDitBuf || keyerDahBuf)) {
      // Paddle hit during auto-sending → cut out (operator takes over)
      keyerAutoInterrupted = true;
      break;
    }
  }
}

// ----- Sequencer gate: request PTT, then block until SequencerLevel == PttOut -----
// This is the "WAITING_FOR_SEQUENCER" state from the design: first element
// (sidetone + key) only fires once the sequencer has brought up SEQ + PA + PTT123.
// Returns false on abort/timeout.
static bool keyer_begin_tx_wait_sequencer() {
  // PTT output disabled (LCD item 24): key CW/FSK directly — no PTT123 / PA / SEQ
  // and no sequencer wait; the rig's break-in brings itself into TX. Don't assert
  // keyerPttRequest, so ptt_inputs_poll() keeps the sequencer down.
  if (!PttOutputEnable) return true;

  // Assert the keyer's own PTT source first, so ptt_inputs_poll() (called from
  // ptt_loop() below) keeps PttActive=true instead of resetting it from the HW
  // inputs every poll. On any failure path, drop it again so a stuck request
  // never leaves PTT latched.
  keyerPttRequest = true;
  ptt_request(true);
  unsigned long t0 = millis();
  while (SequencerLevel != PttOut) {
    ethernet_loop();
    trxnet_loop();
    rkey_loop();
    cat_loop();
    ptt_loop();
    if (trxCwAbort)             { keyerPttRequest = false; return false; }
    if ((millis() - t0) > 2000) { keyerPttRequest = false; return false; }  // safety
  }
  // PTTlead: extra settle time after PTT123 closes before the first element
  // keys, letting the PTT/PA relays settle. 0 = no delay.
  unsigned long tLead = millis();
  while ((millis() - tLead) < (unsigned long)PTTlead) {
    ptt_loop();
    if (trxCwAbort || SequencerLevel != PttOut) { keyerPttRequest = false; return false; }
  }
  return true;
}

// ----- Emit one CW element (dit or dah) -----
// type: 1=dit, 2=dah
// keyHw: true → drive CW1/CW2 pin (CW/CWR mode); false → sidetone only
// (RTTY/none — paddle is just a tap-along, no antenna keying)
static void keyer_emit_element(byte type, bool keyHw) {
  unsigned long dit_ms = 1200UL / KeyerWpm;
  unsigned long element_ms = (type == 1) ? dit_ms : (3UL * dit_ms);

  keyerBeingSent = type;

  if (keyHw) {
    digitalWrite(CW1, HIGH);
    digitalWrite(CW2, HIGH);
  }
  uint16_t sidetoneHz = keyer_sidetone_hz_for_mode();
  if (sidetoneHz != 0) tone(TONE, sidetoneHz);

  keyer_wait_us_pump(element_ms * 1000UL);

  if (keyHw) {
    digitalWrite(CW1, LOW);
    digitalWrite(CW2, LOW);
  }
  if (sidetoneHz != 0) noTone(TONE);

  // Inter-element gap (1 dit time of silence). Keep keyerBeingSent set through
  // the gap, as K3NG does, so the CMOS timing still treats this as part of the
  // current element and only the opposite paddle can be buffered.
  unsigned long inter_us = dit_ms * 1000UL;
  keyer_wait_us_pump(inter_us);
  keyerBeingSent = 0;

  // Accumulate into paddle decoder only for live paddle elements
  if (keyerSendingMode == KEYS_MANUAL) {
    keyerDecodeBuf = (keyerDecodeBuf * 10) + (long)type;
    // 2 more dits ⇒ total 3-dit silence from element end ⇒ letterspace
    keyerDecodeNextMs = millis() + (2UL * dit_ms);
    keyerSpaceSent = false;
  }

  keyerLastSent = type;
  keyerLastTxMs = millis();
}

// ----- Auto-send one CW char (from TrxNet send buffer) -----
static void keyer_emit_cw_char(char c) {
  if (c == ' ') {
    // Wordspace: 4 more dits (we've already let inter-char letterspace pass).
    unsigned long dit_ms = 1200UL / KeyerWpm;
    keyerSendingMode = KEYS_AUTO;
    keyerAutoInterrupted = false;
    keyer_wait_us_pump(4UL * dit_ms * 1000UL);
    keyerSendingMode = KEYS_NONE;
    if (!keyerAutoInterrupted) keyer_lcd_putc(' ');
    return;
  }
  const char* pattern = keyer_morse_for(c);
  if (!pattern || *pattern == 0) return;
  if (!keyer_begin_tx_wait_sequencer()) return;

  keyerSendingMode = KEYS_AUTO;
  keyerAutoInterrupted = false;
  for (const char* p = pattern; *p; p++) {
    keyer_emit_element((*p == '.') ? 1 : 2, true);
    if (trxCwAbort || keyerAutoInterrupted) break;
  }
  keyerSendingMode = KEYS_NONE;

  if (!trxCwAbort && !keyerAutoInterrupted) {
    // Letterspace = 2 more dit times beyond the inter-element gap already paid
    unsigned long dit_ms = 1200UL / KeyerWpm;
    keyer_wait_us_pump(2UL * dit_ms * 1000UL);
    keyer_lcd_putc(c);
  }
}

// ----- Clock a single 5-bit Baudot code onto the FSK pin -----
// Frame: start (SPACE/LOW) + 5 data LSB-first + 1.5 stop (MARK/HIGH).
static void keyer_rtty_send_5bit(uint8_t code) {
  unsigned long bit_us = keyerRttyBitMs * 1000UL;
  pinMode(FSK, OUTPUT);                         // ensure driving (between chars during a session)
  digitalWrite(FSK, keyer_fsk_space());         // start bit (SPACE)
  keyer_wait_us_pump(bit_us);
  for (uint8_t i = 0; i < 5; i++) {
    digitalWrite(FSK, (code & 0x01) ? keyer_fsk_mark() : keyer_fsk_space());
    code >>= 1;
    keyer_wait_us_pump(bit_us);
  }
  digitalWrite(FSK, keyer_fsk_mark());          // stop = MARK
  keyer_wait_us_pump((bit_us * 3UL) / 2UL);     // 1.5 stop bits
  // Pin stays driven at MARK after stop; ptt_tail_service releases it later.
}

// ----- Auto-send one RTTY char (with FIGS/LTRS shift tracking) -----
static void keyer_emit_rtty_char(char c) {
  bool needFigs;
  int8_t code = keyer_baudot_for(c, &needFigs);
  if (code < 0) return;
  if (!keyer_begin_tx_wait_sequencer()) return;

  if (needFigs != keyerRttyShiftFigs) {
    keyer_rtty_send_5bit(needFigs ? BAUDOT_FIGS : BAUDOT_LTRS);
    keyerRttyShiftFigs = needFigs;
  }
  keyer_rtty_send_5bit((uint8_t)code);
  keyer_lcd_putc(c);
  keyerLastTxMs = millis();
}

// ----- Route a decoded paddle char based on current CivMode -----
static void keyer_decoder_commit_and_route(char decoded) {
  bool isCw   = (CivValid && (CivMode == 0x03 || CivMode == 0x07));
  bool isRtty = (CivValid && (CivMode == 0x04 || CivMode == 0x08));
  if (isCw) {
    // Char already went out as morse via the paddle — just echo to LCD
    keyer_lcd_putc(decoded);
  } else if (isRtty) {
    // Paddle was sidetone-only; transmit decoded char as RTTY FSK now
    keyer_emit_rtty_char(decoded);  // handles its own LCD echo
  } else {
    // No TX mode (SSB/AM/FM, or !CivValid) — LCD echo only
    keyer_lcd_putc(decoded);
  }
}

// ----- Decoder service: commit accumulated dit/dah sequence to ASCII -----
static void keyer_decoder_service() {
  unsigned long dit_ms = 1200UL / KeyerWpm;
  if (keyerDecodeBuf != 0 && millis() >= keyerDecodeNextMs) {
    char decoded = keyer_decode_morse(keyerDecodeBuf);
    keyerDecodeBuf = 0;
    keyer_decoder_commit_and_route(decoded);
    // After commit, schedule the wordspace timeout (4 more dits ⇒ 7 total from element end)
    keyerDecodeNextMs = millis() + (4UL * dit_ms);
    keyerSpaceSent = false;
  } else if (keyerDecodeBuf == 0 && !keyerSpaceSent
             && millis() >= keyerDecodeNextMs) {
    // Route through commit_and_route so RTTY mode actually sends Baudot space.
    // In CW mode this just echoes ' ' to LCD (the on-air gap is already there).
    keyer_decoder_commit_and_route(' ');
    keyerSpaceSent = true;
  }
}

// ----- Paddle FSM step (drives one element per call when paddle is pressed) -----
static void keyer_paddle_step() {
  keyer_check_paddles();
  if (!keyerDitBuf && !keyerDahBuf) return;

  // Paddle priority: drop any pending TrxNet send buffer
  keyerSendHead = keyerSendTail = 0;

  // Decide next element: squeeze alternates, single paddle is its own type
  byte t;
  if (keyerDitBuf && keyerDahBuf) t = (keyerLastSent == 1) ? 2 : 1;
  else if (keyerDitBuf)           t = 1;
  else                            t = 2;
  if (t == 1) keyerDitBuf = 0;
  else        keyerDahBuf = 0;

  // CW/CWR → drive CW pin via sequencer; other modes → sidetone only
  // Remote CW stream owns CW1/CW2 while active: local paddle = sidetone only.
  bool keyHw = (CivValid && (CivMode == 0x03 || CivMode == 0x07)) && !rkey_busy();
  if (keyHw) {
    if (!keyer_begin_tx_wait_sequencer()) return;
  }

  keyerSendingMode = KEYS_MANUAL;
  keyer_emit_element(t, keyHw);
  keyerSendingMode = KEYS_NONE;

  // Iambic A: if both paddles were pressed during element and both released
  // by element end, drop the remaining buffered element (no "extra" element)
  if (KeyerActiveMode == 'A' && keyerIambicAFlag
      && !keyer_paddle_dit_pressed() && !keyer_paddle_dah_pressed()) {
    keyerIambicAFlag = 0;
    keyerDitBuf = 0;
    keyerDahBuf = 0;
  }
}

// ----- TrxNet send buffer drain (one char per call, mode-dispatched) -----
static void keyer_send_buffer_drain() {
  if (keyerSendHead == keyerSendTail) return;
  // Remote CW stream on the air → hold /s-cw text until it finishes
  if (rkey_busy()) return;
  // Paddle in flight or pending → defer (paddle has priority)
  if (keyerDitBuf || keyerDahBuf) return;
  if (keyer_paddle_dit_pressed() || keyer_paddle_dah_pressed()) return;

  char c = keyerSendBuf[keyerSendTail];
  keyerSendTail = (keyerSendTail + 1) % KEYER_SENDBUF_SIZE;

  if (c == KEYER_LCD_SPACE_MARKER) { keyer_lcd_putc(' '); return; }
  if (!CivValid) { keyer_lcd_putc(c); return; }
  if (CivMode == 0x03 || CivMode == 0x07)      keyer_emit_cw_char(c);
  else if (CivMode == 0x04 || CivMode == 0x08) keyer_emit_rtty_char(c);
  else                                          keyer_lcd_putc(c);
}

// ----- PTT hang-time release -----
// Drop PTT after one full wordspace of silence with nothing pending. This keeps
// PTT up between consecutive chars / paddle elements but releases promptly when
// transmission stops.
static void keyer_ptt_tail_service() {
  // Normally gated on an active PTT. With PTT output disabled we never asserted
  // PttActive, but an RTTY session still drove the FSK line, so it must still be
  // released after the hang time — run the tail logic in that case too.
  if (!PttActive && PttOutputEnable) return;
  // PTT held by the remote CW stream: don't toggle PttActive under it.
  if (rkey_busy()) return;
  if (keyerSendHead != keyerSendTail) return;
  if (keyerDitBuf || keyerDahBuf) return;
  if (keyer_paddle_dit_pressed() || keyer_paddle_dah_pressed()) return;
  unsigned long dit_ms = 1200UL / KeyerWpm;
  if ((millis() - keyerLastTxMs) >= (7UL * dit_ms)) {
    keyer_fsk_release();    // float FSK line — no continuous drive between sessions
    keyerPttRequest = false;  // drop the keyer source; poll OR then releases PTT
    ptt_request(false);
  }
}

// ----- Public API -----

void keyer_enqueue_char(char c) {
  uint8_t next = (keyerSendHead + 1) % KEYER_SENDBUF_SIZE;
  if (next == keyerSendTail) return;   // buffer full, drop char
  keyerSendBuf[keyerSendHead] = c;
  keyerSendHead = next;
}

void keyer_set_wpm(uint8_t w) {
  if (w < 5)  w = 5;
  if (w > 50) w = 50;
  if (w == KeyerWpm) return;
  KeyerWpm = w;
  keyerEepromDirty = true;
  keyerEepromDirtyMs = millis();
}

void keyer_abort() {
  keyerSendHead = keyerSendTail = 0;
  keyerDitBuf = keyerDahBuf = 0;
  keyerIambicAFlag = 0;
  keyerDecodeBuf = 0;
  keyerSpaceSent = true;
  keyerBeingSent = 0;
  keyerSendingMode = KEYS_NONE;
  keyerRttyShiftFigs = false;     // next RTTY TX starts fresh (next FIGS char will re-shift)
  digitalWrite(CW1, LOW);
  digitalWrite(CW2, LOW);
  keyer_fsk_release();          // float the line (high-Z)
  noTone(TONE);
  keyerPttRequest = false;      // drop the keyer source so the poll OR releases PTT
  ptt_request(false);
  keyerState = KEYER_IDLE;
}

// ----- EEPROM helpers -----

static void keyer_eeprom_load() {
  uint8_t e;

  e = EEPROM.read(KEYER_EEPROM_WPM_ADDR);
  if (e == 0xFF) KeyerWpm = KeyerDefaultWpm;
  else           KeyerWpm = (e < 5) ? 5 : (e > 50 ? 50 : e);

  e = EEPROM.read(KEYER_EEPROM_MODE_ADDR);
  if (e == 0xFF) KeyerActiveMode = KeyerMode;
  else           KeyerActiveMode = (e == 0) ? 'A' : 'B';

  e = EEPROM.read(KEYER_EEPROM_REVERSE_ADDR);
  if (e == 0xFF) KeyerPaddleSwap = KeyerPaddleReverse;
  else           KeyerPaddleSwap = (e != 0);

  uint16_t s = (uint16_t)EEPROM.read(KEYER_EEPROM_SIDETONE_LO)
             | ((uint16_t)EEPROM.read(KEYER_EEPROM_SIDETONE_HI) << 8);
  if (s == 0xFFFF) KeyerSidetoneNow = KeyerSidetoneHz;
  else             KeyerSidetoneNow = s;

  e = EEPROM.read(KEYER_EEPROM_RTTYBAUD_ADDR);
  if (e == 0xFF) KeyerRttyBaudNow = KeyerRttyBaud;
  else if (e == 45 || e == 50 || e == 75 || e == 100) KeyerRttyBaudNow = e;
  else KeyerRttyBaudNow = 45;

  e = EEPROM.read(KEYER_EEPROM_FSKREV_ADDR);
  if (e == 0xFF) KeyerFskReverseNow = KeyerFskReverse;
  else           KeyerFskReverseNow = (e != 0);

  // Pre-compute bit period; 45 ⇒ 45.45 Bd ⇒ 22 ms
  keyerRttyBitMs = (KeyerRttyBaudNow == 45) ? 22UL : (1000UL / KeyerRttyBaudNow);
}

static void keyer_eeprom_flush_if_dirty() {
  if (!keyerEepromDirty) return;
  if ((millis() - keyerEepromDirtyMs) < KEYER_EEPROM_DEBOUNCE_MS) return;
  EEPROM.update(KEYER_EEPROM_WPM_ADDR,      KeyerWpm);
  EEPROM.update(KEYER_EEPROM_MODE_ADDR,     (KeyerActiveMode == 'A') ? 0 : 1);
  EEPROM.update(KEYER_EEPROM_REVERSE_ADDR,  KeyerPaddleSwap ? 1 : 0);
  EEPROM.update(KEYER_EEPROM_SIDETONE_LO,   (uint8_t)(KeyerSidetoneNow & 0xFF));
  EEPROM.update(KEYER_EEPROM_SIDETONE_HI,   (uint8_t)(KeyerSidetoneNow >> 8));
  EEPROM.update(KEYER_EEPROM_RTTYBAUD_ADDR, KeyerRttyBaudNow);
  EEPROM.update(KEYER_EEPROM_FSKREV_ADDR,   KeyerFskReverseNow ? 1 : 0);
  keyerEepromDirty = false;
}

// ----- Setup / Loop -----

void keyer_setup() {
  Serial.println(F("--- KEYER ---"));
  pinMode(PADDLEL, INPUT_PULLUP);
  pinMode(PADDLER, INPUT_PULLUP);
  pinMode(CW1, OUTPUT); digitalWrite(CW1, LOW);
  pinMode(CW2, OUTPUT); digitalWrite(CW2, LOW);
  keyer_eeprom_load();
  keyer_fsk_release();   // pinMode INPUT — high-Z; external pull network sets the line
  // OI3 hardware has bypass capacitors on PADDLEL/PADDLER lines. After pinMode
  // INPUT_PULLUP the caps need ~tens of ms to charge through the internal
  // pull-up; until then the MCU reads LOW = "paddle pressed" and would
  // generate spurious dits/dahs. K3NG firmware uses delay(250) here for the
  // same reason (k3ng_keyer.ino:8618).
  delay(250);

  keyerState     = KEYER_IDLE;
  keyerSendHead  = keyerSendTail = 0;
  keyerLcdTxCol  = 0;
  keyerDecodeBuf = 0;
  keyerSpaceSent = true;

  Serial.print(F("Keyer wpm=")); Serial.print(KeyerWpm);
  Serial.print(F(" mode="));     Serial.print(KeyerActiveMode);
  Serial.print(F(" pad="));      Serial.print(KeyerPaddleSwap ? 'R' : 'N');
  Serial.print(F(" side="));     Serial.print(KeyerSidetoneNow);
  Serial.print(F("Hz rtty="));   Serial.print(KeyerRttyBaudNow);
  Serial.print(F("Bd fsk="));    Serial.println(KeyerFskReverseNow ? 'R' : 'N');
}

void keyer_loop() {
  // Drain TrxNet drop-box (callbacks fired during trxnet_loop)
  if (trxCwAbort)   { trxCwAbort = false; keyer_abort(); }
  if (trxCwPending) {
    trxCwPending = false;
    for (uint8_t i = 0; trxPendingCW[i] && i < KEYER_SENDBUF_SIZE - 1; i++) {
      keyer_enqueue_char(trxPendingCW[i]);
    }
    keyer_enqueue_char(KEYER_LCD_SPACE_MARKER);
  }

  // Live paddle (priority) → drives one element per outer iteration
  keyer_paddle_step();
  // Commit decoded char on letterspace timeout, route by CivMode
  keyer_decoder_service();
  // TrxNet auto-send buffer drain (one char per iteration)
  keyer_send_buffer_drain();
  // Release PTT after hang-time
  keyer_ptt_tail_service();
  // EEPROM debounced flush
  keyer_eeprom_flush_if_dirty();
}
// =================== END KEYER ===================


// ===================== LOW-POWER TUNE =====================
// MODE button (D36) while CI-V is active (CivValid) keys a low-power carrier for
// antenna-tuner / PA tuning on one click. When CI-V is silent the same button
// still rotates CivMode (handled in the LCD MODE handler).
//
// Sequence (blocking, pumps net/ptt loops in the same house style as the keyer's
// keyer_begin_tx_wait_sequencer()). Because civ_loop() is not called for the
// duration, the periodic freq/mode poll is paused automatically and the bus is
// exclusively ours for the read / set / restore frames:
//   1) read current RF power (retry) → save; on failure use TuneRestoreFallback
//      as the restore target and warn. Save current mode (CivMode cache == rig).
//   2) CI-V set mode CW (06 03 01); cache CivMode=CW so the sequencer picks the
//      CW PTT output relay.
//   3) CI-V set power = TunePower %.
//   4) settle TuneSettleMs (let the rig apply mode+power before RF).
//   5) sequencer PTT up (SEQ→PA→PTT123), then key CW1/CW2 solid = carrier.
//   6) hold: at least TuneHoldMs (so a quick tap still gives a full tune pulse),
//      then until MODE is released.
//   7) CW up → sequencer PTT down (tail).
//   8) restore power then mode (best-effort — runs on every exit incl. abort).
// Abort (interlock, PTT-up timeout) jumps straight to step 7/8 so the rig is
// never left silently at low power / in CW.
//
// The same action runs from TrxNet (/s-lptune, TUNE_SRC_NET): a peer — the
// WIFILT PA palette's TUNE+ — keeps the carrier up while an amplifier's own
// tuner works, and drops it when the amplifier's TUNE flag falls. Only step 6
// differs: instead of the MODE button the carrier is held until /s-lptune 0,
// and only while keepalives keep arriving (TuneKeepaliveMs dead-man), so a
// peer that crashed or lost the network cannot leave the rig keyed until
// TuneMaxMs. State goes out on /lptune: 1 carrier up, 3 aborted, 0 restored
// (idle), 2 refused because something else is transmitting.
//
// KENWOOD (BAND_DECODER_IN == 2): the TS-480 has its own low-power carrier,
// CAT "TX2;" (TX Tune transmission). Steps 1-4 and 8 are skipped (no power or
// mode change, TunePower unused), the sequencer only brings up SEQ + PA
// (tuneCatPtt, PTT123 stays down - the rig keys itself), PAlead later "TX2;"
// replaces CW1/CW2, and step 7 sends "RX;" and confirms RX via IF.
static const uint8_t  TUNE_CW_MODE     = 0x03;   // CI-V mode byte for CW carrier
// Tune source. Plain uint8_t, not an enum: the .ino prototype generator puts
// function prototypes above any type declared here.
static const uint8_t  TUNE_SRC_BUTTON  = 0;
static const uint8_t  TUNE_SRC_NET     = 1;

// TX-idle guard: a tune may start only when nothing else is transmitting.
static bool tune_tx_idle() {
  if (!CivValid)                        return false;   // feature is CI-V-only
  if (!PttOutputEnable)                 return false;   // PTT output disabled (LCD item 24)
  if (SequencerLevel != 0 || PttActive) return false;   // sequencer must be down
  if (keyerState != KEYER_IDLE)         return false;   // keyer not mid-send
  if (keyerPttRequest || tunePttRequest || pttTestRequest) return false;
  if (netptt_wanted())                  return false;   // a peer holds the /s-ptt lease
  if (ptt_interlock_active)             return false;
  if (digitalRead(FootSW) == LOW)       return false;   // external PTT (footsw)
  if (digitalRead(PTT232) == HIGH)      return false;   // external PTT (232)
  if (keyer_paddle_dit_pressed() || keyer_paddle_dah_pressed()) return false;
  return true;
}

// Request PTT and pump until the sequencer has brought up PTT123 (+PTTlead
// settle). Returns false on interlock / timeout. Keeps CivValid fresh.
// Caller must have set CivMode so ptt_output_for_civmode() picks the wanted relay.
// With tuneCatPtt the target is level 4 (SEQ + PA) + PAlead, then the caller
// keys the rig over CAT.
static bool tune_wait_ptt_up() {
  tunePttRequest = true;              // ORed in by ptt_inputs_poll → sequencer up
  ptt_request(true);                  // set PttActive/PttOut now (mirrors keyer)
  byte          target = tuneCatPtt ? 4 : PttOut;
  unsigned long lead   = tuneCatPtt ? (unsigned long)PAlead : (unsigned long)PTTlead;
  unsigned long t0 = millis();
  while (SequencerLevel != target) {
    ethernet_loop(); trxnet_loop(); rkey_loop(); ptt_loop();
    civLastParseMs = millis();
    if (ptt_interlock_active)    return false;
    if ((millis() - t0) > 2000)  return false;   // safety
  }
  unsigned long tl = millis();
  while ((millis() - tl) < lead) {
    ptt_loop();
    if (ptt_interlock_active || SequencerLevel != target) return false;
  }
  return true;
}

// Drop the tune PTT source and pump until the sequencer is fully down (level 0).
static void tune_wait_ptt_down() {
  tunePttRequest = false;
  unsigned long t0 = millis();
  while (SequencerLevel != 0) {
    ethernet_loop(); trxnet_loop(); rkey_loop(); ptt_loop();
    civLastParseMs = millis();
    if (ptt_interlock_active)   break;            // interlock already forced down
    if ((millis() - t0) > 3000) break;            // safety
  }
}

static void tune_lcd_show(uint8_t src) {
  char buf[17];
  if (BAND_DECODER_IN == 2) strcpy(buf, src == TUNE_SRC_NET ? "TUNE CAT NET" : "TUNE CAT");
  else snprintf(buf, sizeof(buf), src == TUNE_SRC_NET ? "TUNE %u%% NET" : "TUNE %u%%", TunePower);
  keyerRow1Locked = true;
  lcd.setCursor(0, 1);
  lcd.print(F("                "));
  lcd.setCursor(0, 1);
  lcd.print(buf);
}

// Step 6: hold the carrier. Button: min TuneHoldMs, then until MODE released.
// NET: until /s-lptune 0, while keepalives keep arriving. Both capped at
// TuneMaxMs. Returns true when aborted (interlock, keepalive lost, cap).
static bool tune_hold(uint8_t src) {
  unsigned long tStart = millis();
  for (;;) {
    ethernet_loop(); trxnet_loop(); rkey_loop(); ptt_loop();
    civLastParseMs = millis();
    if (ptt_interlock_active) return true;                     // abort on interlock
    unsigned long elapsed = millis() - tStart;
    if (src == TUNE_SRC_NET) {
      if (trxLpTuneStop) return false;                         // peer says done
      if ((millis() - trxLpTuneKaMs) > (unsigned long)TuneKeepaliveMs) {
        tone(TONE, 200, 200);                                  // peer went silent
        return true;
      }
    } else {
      bool held = (digitalRead(MENU) == LOW);
      if (!held && elapsed >= (unsigned long)TuneHoldMs) return false; // released after min hold
    }
    if (elapsed >= (unsigned long)TuneMaxMs) {                // stuck-button / peer safety cap
      tone(TONE, 200, 200);
      return true;
    }
  }
}

// Full blocking tune action. Precondition: tune_tx_idle() && CivValid.
static void tune_run(uint8_t src) {
  tuneActive = true;                      // holds /s-hz, /s-mode back until the restore
  bool    cat         = (BAND_DECODER_IN == 2);   // KENWOOD: rig's own TX Tune over CAT
  uint8_t savedRaw    = 0;
  uint8_t savedMode   = CivMode;
  uint8_t savedFilter = CivFilter;        // preserve IF filter (FIL1/2/3) across the tune

  if (!cat) {
    // --- 1) read + save current power (mode/filter saved above) ---
    bool haveSaved = civ_read_power_blocking(&savedRaw, TuneReadTimeoutMs, 2);
    if (!haveSaved) {
      savedRaw = civ_power_pct_to_raw(TuneRestoreFallback);  // fallback restore target
      tone(TONE, 300, 120); delay(140); tone(TONE, 300, 120); delay(140);  // warble
    }

    // --- 2) force CW mode (FIL1 during tune is irrelevant; restored at the end) ---
    civ_send_setmode(TUNE_CW_MODE);
    CivMode = TUNE_CW_MODE;               // cache → sequencer picks CW PTT relay

    // --- 3) set low power ---
    civ_send_set_power(civ_power_pct_to_raw(TunePower));

    // --- 4) settle ---
    unsigned long ts = millis();
    while ((millis() - ts) < (unsigned long)TuneSettleMs) { ethernet_loop(); trxnet_loop(); rkey_loop(); ptt_loop(); }
  }
  tune_lcd_show(src);

  // --- 5) PTT up, then solid carrier ---
  bool keyed = false;
  bool aborted = false;
  tuneCatPtt = cat;                       // KENWOOD: sequencer stops at SEQ + PA
  if (tune_wait_ptt_up()) {
    keyed = true;
    if (cat) {
      kw_tx_tune(true);                   // "TX2;" - rig's reduced-power carrier
    } else {
      digitalWrite(CW1, HIGH);            // solid carrier (rig provides its own sidetone)
      digitalWrite(CW2, HIGH);
    }
    lptune_publish(1);

    // --- 6) hold ---
    aborted = tune_hold(src);
  } else {
    aborted = true;                        // interlock or sequencer timeout
  }
  if (aborted) lptune_publish(3);

  // --- 7) carrier off, PTT down ---
  if (keyed) {
    if (cat) {
      if (!kw_tx_tune(false)) {           // rig did not confirm RX - warn loudly
        tone(TONE, 200, 400);
        Serial.println(F("[TUNE] KENWOOD did not confirm RX;"));
      }
    } else {
      digitalWrite(CW1, LOW);
      digitalWrite(CW2, LOW);
    }
  }
  tune_wait_ptt_down();
  tuneCatPtt = false;

  // --- 8) restore power then mode+filter (best-effort, always runs) ---
  if (!cat) {
    civ_send_set_power(savedRaw);
    civ_send_setmode_flt(savedMode, savedFilter);
    CivMode   = savedMode;
    CivFilter = savedFilter;
  }
  civLastParseMs = millis();              // don't let the watchdog fire post-tune
  tone(TONE, 600, 60);                    // restore-confirm blip

  // hand row 1 back to the keyer
  lcd.setCursor(0, 1);
  lcd.print(F("                "));
  keyerLcdTxCol   = 0;
  keyerRow1Locked = false;

  // /s-cw text that arrived under the carrier is dropped, not sent: a macro
  // keyed seconds after the tune finished would go out unasked.
  trxCwPending   = false;
  trxLpTuneStart = false;                 // a start that raced the tune is not a new one
  trxLpTuneStop  = false;
  tuneActive     = false;
  lptune_publish(0);
}

// Remote start (/s-lptune 1), picked up in loop() rather than in the callback:
// tune_run() blocks and pumps trxnet_loop() itself.
void lptune_net_loop() {
  // A peer that restarted is not new to us, so it got no greeting: it asks.
  if (trxLpTuneQuery) { trxLpTuneQuery = false; lptune_publish(tuneActive ? 1 : 0); }
  if (!trxLpTuneStart) return;
  trxLpTuneStart = false;
  trxLpTuneStop  = false;
  if (tune_tx_idle()) {
    tune_run(TUNE_SRC_NET);
  } else {
    tone(TONE, 200, 120);                 // refused: same beep as the MODE button
    lptune_publish(2);
  }
}
// =================== END LOW-POWER TUNE ===================


// ===================== LCD RUNTIME =====================
// Row-0 renderer running after setup(). Layout: HHHHHHHHHHHH|MMM
// (12-wide value + separator + 3-char mode).
// FSM has three states (separator shows which one):
//   PINNED   sep '|'  — value display, DWN/UP = WPM down/up (live keyer)
//   BROWSING sep '<'  — navigate menu items via DWN/UP (prev/next, edge-only)
//   EDITING  sep '='  — edit current item's value via DWN/UP (dec/inc, auto-rep)
// SET button transitions:
//   any  press  in PINNED   → BROWSING (fires on press edge; long press in
//                             PINNED has no special meaning — nothing to edit)
//   short press in BROWSING → PINNED   (persist menu idx)
//   long  press in BROWSING → EDITING  (if item editable; fires on threshold)
//   any  press  in EDITING  → BROWSING with save (write EEPROM; no cancel path)
//   BROWSING auto-timeout → PINNED after 30 s of no panel activity
// MODE button (D36): while !CivValid (rig silent) rotates CivMode
// LSB→USB→AM→CW→RTY→FM→CWR→RTR→LSB on every press (boot init = CW). While
// CivValid (rig on CI-V) a press instead fires the low-power TUNE action (see
// LOW-POWER TUNE section) when TX is idle, else a refuse beep.
// Menu items 0..6:   read-only (call/FW/IP/baud/CIV/freq).
// Menu item 7:       peer count; long-press SET browses known peer IP tails.
// Menu items 8..14:  editable sequencer settings in runtime order (not persisted).
// Menu item 15:      editable PTT output (not persisted — cfg/default after reset).
//                    Right edge of the value field (cols 9..11) shows a live
//                    input-debug triplet "FIP" — F=FootSw, I=Interlock, P=PTT232;
//                    upper-case = input active, lower-case = idle (see
//                    lcd_format_value case 15).
// Menu items 16..21: editable keyer settings (WPM/Mode/Pad/Sidetone/Bd/FSK).
// Menu item 22:      editable serial debug toggle (not persisted).
// Menu item 23:      read-only TrxNet UDP port (set in oi3.cfg).
// Menu item 24:      editable PTT-output enable (PTTout on/off). off = no PTT123 /
//                    PA / SEQ from any source; CW/FSK keep keying. Not persisted —
//                    always on after reboot (PttOutputEnable).
// Menu item 25:      read-only IPkey link; row 1 shows the remote CW trace.
// Menu item 26:      read-only "RPI": the state of the Raspberry Pi running WIFILT +
//                    local-trx (TrxNet /wl-host, rpi_status.ino). Uses row 1 too,
//                    but keyer TX text takes it over and returns it 2 s after TX.
//                    Skipped while browsing until the Pi has been heard from.
// Auto-repeat: 700 ms hold → 3 Hz. Active only in PINNED (WPM ±) and EDITING
// (value dec/inc). BROWSING navigation is edge-only — one menu step per press.
// Tones: only on BROWSING↔EDITING transition (low→high entering, high→low
// leaving). No tones for PINNED↔BROWSING, DWN/UP steps, or MODE rotation.
// Pull model: every LCD_TICK_MS samples buttons + sources, redraws only the
// parts of row 0 that changed. Row 1 is owned by the KEYER block for TX text.
// Buttons on MEM (A1) voltage divider, decision levels at midpoints between
// measured raw ADC values (SET≈2, DWN≈89, UP≈167):
//   SET  tmp < 46
//   DWN  46 < tmp < 128
//   UP   128 < tmp < 230
// Persistence: EEPROM[LCD_EEPROM_IDX_ADDR] = current menu index, written on
// BROWSING→PINNED transition. Keyer values use their own EEPROM addresses
// (see KEYER block) — saved by lcd_edit_save().
#include <EEPROM.h>

const uint8_t LCD_MENU_ITEM_COUNT = 27;
const uint8_t LCD_RKEY_ITEM       = 25;   // remote CW key: CONN/DISC + trace on row 1
const uint8_t LCD_RPI_ITEM        = 26;   // WIFILT Pi state, both rows (rpi_status.ino)
const uint8_t LCD_VALUE_WIDTH     = 12;
const uint8_t LCD_MODE_WIDTH      = 3;
const uint8_t LCD_SEP_COL         = 12;
const uint8_t LCD_MODE_COL        = 13;
const uint8_t LCD_EEPROM_IDX_ADDR = 0;

const unsigned long LCD_TICK_MS              = 30;
const unsigned long LCD_MODE_HOLD_MS         = 800;
const unsigned long LCD_BTN_REPEAT_DELAY_MS  = 700;   // hold this long → start repeating
const unsigned long LCD_BTN_REPEAT_RATE_MS   = 333;   // 3 Hz repeat
const unsigned long LCD_ROW1_OVERLAY_MS      = 800;   // WPM overlay duration on row 1
const unsigned long LCD_BROWSING_TIMEOUT_MS  = 30000; // auto-return to PINNED
// Decision levels = midpoints between measured raw ADC values
// (SET≈2, DWN≈89, UP≈167). Midpoints: 46 and 128.
const int           LCD_SET_MAX      = 46;    // SET: tmp < 46     (raw ~2)
const int           LCD_DWN_MIN      = 46;    // DWN: 46 < tmp < 128  (raw ~89)
const int           LCD_DWN_MAX      = 128;
const int           LCD_UP_MIN       = 128;   // UP:  128 < tmp < 230 (raw ~167)
const int           LCD_UP_MAX       = 230;

enum LcdState : uint8_t { LCD_PINNED = 0, LCD_BROWSING = 1, LCD_EDITING = 2 };

static LcdState      lcdState        = LCD_PINNED;
static uint8_t       lcdMenuIdx      = 0;
static char          lcdLastValue[LCD_VALUE_WIDTH + 1] = {0};
static char          lcdLastMode[LCD_MODE_WIDTH + 1]   = {0};
static char          lcdLastSep      = 0;
static unsigned long lcdLastTickMs   = 0;
// SET press tracking. lcdSetConsumed = press already triggered a state change
// (PINNED→BROWSING, EDITING→BROWSING-save, or BROWSING→EDITING long-press fire),
// so the release edge must not re-fire as a short press.
static bool          lcdSetDown      = false;
static unsigned long lcdSetPressMs   = 0;
static bool          lcdSetConsumed  = false;
static bool          lcdModeDown     = false;  // MODE (D36) edge tracking
static uint8_t       lcdBtnPrev      = 0;  // 0=none, 1=SET, 2=DWN, 3=UP
static unsigned long lcdBtnPressMs   = 0;
static unsigned long lcdBtnRepeatNextMs = 0;
static unsigned long lcdBrowsingActivityMs = 0;
static unsigned long lcdRow1OverlayUntilMs = 0;  // 0 = no overlay active
static uint8_t       lcdPeerBrowseIdx = 0;
// Deferred second tone for BROWSING↔EDITING sweep (non-blocking).
static unsigned long lcdTonePendingMs = 0;
static uint16_t      lcdTonePendingHz = 0;

static uint8_t lcd_read_button(int *rawOut = nullptr) {
  int tmp = analogRead(MEM);
  if (rawOut) *rawOut = tmp;
  if (tmp < LCD_SET_MAX)                        return 1;  // SET
  if (tmp > LCD_DWN_MIN && tmp < LCD_DWN_MAX)   return 2;  // DWN
  if (tmp > LCD_UP_MIN  && tmp < LCD_UP_MAX)    return 3;  // UP
  return 0;
}

// Left-align src into out[width], pad with spaces on the right.
// Truncates from the right if src is longer than width.
static void lcd_pad_left_align(const char* src, char* out, uint8_t width) {
  uint8_t len = strlen(src);
  if (len > width) len = width;
  for (uint8_t i = 0; i < len; i++) out[i] = src[i];
  for (uint8_t i = len; i < width; i++) out[i] = ' ';
  out[width] = 0;
}

#ifdef FEATURE_NET
// True if a peer name matches a configured priority prefix — same strncmp
// semantics as TrxNet::setPriorityPrefixes(). prioCount==0 (feature off) → false.
static bool lcd_peer_is_priority(const char* name) {
  for (uint8_t i = 0; i < prioCount; i++) {
    size_t n = strlen(prioPrefix[i]);
    if (n && strncmp(name, prioPrefix[i], n) == 0) return true;
  }
  return false;
}
#endif

// In BROWSING/EDITING, editable items render '=' between name and value instead
// of a space — a visual hint that long-press SET enters EDITING. Read-only
// items and PINNED state are unaffected. Item 15 in EDITING also switches its
// rendering from "effective PTT with D/TX prefix" to the raw target value.
void rpi_format_row0(char* out);   // rpi_status.ino
void rpi_format_row1(char* out);
extern bool rpiSeen;

static void lcd_format_value(uint8_t idx, char* out, uint8_t state) {
  // Work buffer larger than LCD_VALUE_WIDTH so case 6 freq ("MMM.MMM.D kHz",
  // 13 chars) and "---.---.- kHz" placeholder fit; lcd_pad_left_align truncates
  // back to LCD_VALUE_WIDTH when writing to out[].
  char raw[20];
  raw[0] = 0;
  char s = (state != LCD_PINNED) ? '=' : ' ';

  switch (idx) {
    case 0:  // mycall
      YOUR_CALL.toCharArray(raw, sizeof(raw));
      break;
    case 1:  // FW
      snprintf(raw, sizeof(raw), "FW %s", REV);
      break;
    case 2:  // IP-hi "192.168."
#ifdef FEATURE_NET
      if (!EthLinkStatus) { strcpy(raw, "no link"); break; }
      {
        IPAddress ip = Ethernet.localIP();
        snprintf(raw, sizeof(raw), "%u.%u.", ip[0], ip[1]);
      }
#else
      strcpy(raw, "no net");
#endif
      break;
    case 3:  // IP-lo "1.220"
#ifdef FEATURE_NET
      if (!EthLinkStatus) { strcpy(raw, "no link"); break; }
      {
        IPAddress ip = Ethernet.localIP();
        snprintf(raw, sizeof(raw), "%u.%u", ip[2], ip[3]);
      }
#else
      strcpy(raw, "no net");
#endif
      break;
    case 4:  // baud
      snprintf(raw, sizeof(raw), "baud %lu", SERBAUD2);
      break;
    case 5:  // CI-V addr (KENWOOD has none)
      if (BAND_DECODER_IN == 2) strcpy(raw, "KENWOOD");
      else snprintf(raw, sizeof(raw), "CI-V 0x%02X", CIV_ADRESS);
      break;
    case 6:  // freq: MM.MMM.D kHz (HF) or MMM.MMM.D kHz (VHF), 100 Hz resolution
      if (!CivValid || CivFreq == 0) { strcpy(raw, "---.---.- kHz"); break; }
      {
        unsigned long khz   = CivFreq / 1000UL;
        unsigned long tenth = (CivFreq / 100UL) % 10UL;
        unsigned long mhz   = khz / 1000UL;
        unsigned long subk  = khz % 1000UL;
        snprintf(raw, sizeof(raw), "%lu.%03lu.%lu kHz", mhz, subk, tenth);
      }
      break;
    case 7:  // peers
#ifdef FEATURE_NET
      if (NET_ID == 0x00 || !trxNetStarted) { strcpy(raw, "Peers off"); break; }
      {
        int peers = net.peerCount();
        if (peers <= 0) { strcpy(raw, "Peers 0"); break; }
        if (lcdPeerBrowseIdx >= (uint8_t)peers) lcdPeerBrowseIdx = 0;
        if (state == LCD_EDITING) {
          const TrxPeer* peer = net.peer(lcdPeerBrowseIdx);
          if (peer) {
            // Priority peers show '*' instead of '.' in the name (705*01) so the
            // protected devices stand out while browsing the peer list.
            char pn[8];
            snprintf(pn, sizeof(pn), "%.7s", peer->name);
            if (lcd_peer_is_priority(peer->name)) {
              char* dot = strchr(pn, '.');
              if (dot) *dot = '*';
            }
            snprintf(raw, sizeof(raw), "%s .%u", pn, peer->ip[3]);
          } else {
            snprintf(raw, sizeof(raw), "P?/%u", peers);
          }
        } else {
          snprintf(raw, sizeof(raw), "Peers%c%d", s, peers);
        }
      }
#else
      strcpy(raw, "Peers off");
#endif
      break;
    case 8:  // InterlockEnable: 1 = PA interlock, 0 = external PTT input
      snprintf(raw, sizeof(raw), "Inter%c%u", s, InterlockEnable ? 1 : 0);
      break;
    case 9:  // SEQUENCERlead: after SEQ HIGH before PA HIGH
      snprintf(raw, sizeof(raw), "SeqH%c%dms", s, SEQUENCERlead);
      break;
    case 10:  // PAlead: after PA HIGH before PTT HIGH
      snprintf(raw, sizeof(raw), "PAH%c%dms", s, PAlead);
      break;
    case 11:  // PTTlead: settle delay after PTT123 closes before CW keying
      snprintf(raw, sizeof(raw), "PTTH%c%dms", s, PTTlead);
      break;
    case 12:  // PTTtail: before PTT LOW
      snprintf(raw, sizeof(raw), "PTTL%c%dms", s, PTTtail);
      break;
    case 13:  // PAtail: after PTT LOW before PA LOW
      snprintf(raw, sizeof(raw), "PAL%c%dms", s, PAtail);
      break;
    case 14:  // SEQUENCERtail: after PA LOW before SEQ LOW
      snprintf(raw, sizeof(raw), "SeqL%c%dms", s, SEQUENCERtail);
      break;
    case 15:  // PTT output: BROWSING/PINNED = effective (1/2/3, or D + default
             // number, "TX " when active); EDITING = raw target value (always
             // 1/2/3 after normalization), "TX " while the MODE test keys it
      if (state == LCD_EDITING) {
        byte v = (CivValid && CivMode < 16) ? PttOutByCivMode[CivMode] : PTTmodeDefault;
        snprintf(raw, sizeof(raw), "%sPTT=%u", (SequencerLevel != 0) ? "TX " : "", v);
      } else {
        byte n = ptt_output_for_civmode();
        bool isDefault = (!CivValid || CivMode == 0xFF || CivMode >= 16
                          || PttOutByCivMode[CivMode] < 1
                          || PttOutByCivMode[CivMode] > 3);
        const char* prefix = (SequencerLevel != 0) ? "TX " : "";
        if (isDefault) snprintf(raw, sizeof(raw), "%sPTT%cD%u", prefix, s, n);
        else           snprintf(raw, sizeof(raw), "%sPTT%c%u", prefix, s, n);
      }
      break;
    case 16:  // KEYER WPM
      snprintf(raw, sizeof(raw), "WPM%c%u", s, KeyerWpm);
      break;
    case 17:  // KEYER iambic mode
      snprintf(raw, sizeof(raw), "Mode%c%c", s, KeyerActiveMode);
      break;
    case 18:  // KEYER paddle reverse
      snprintf(raw, sizeof(raw), "Pad%c%c", s, KeyerPaddleSwap ? 'R' : 'N');
      break;
    case 19:  // KEYER sidetone Hz (0 = off)
      if (KeyerSidetoneNow == 0) snprintf(raw, sizeof(raw), "Side%coff", s);
      else snprintf(raw, sizeof(raw), "Side%c%uHz", s, KeyerSidetoneNow);
      break;
    case 20:  // KEYER RTTY baud: 45 shows "45.45 Bd", others "NN Bd"
      if (KeyerRttyBaudNow == 45) snprintf(raw, sizeof(raw), "RTY%c45.45 Bd", s);
      else snprintf(raw, sizeof(raw), "RTY%c%u Bd", s, KeyerRttyBaudNow);
      break;
    case 21:  // KEYER FSK polarity
      snprintf(raw, sizeof(raw), "FSK%c%c", s, KeyerFskReverseNow ? 'R' : 'N');
      break;
    case 22:  // serial debug toggle (not persisted)
      snprintf(raw, sizeof(raw), "Debug%c%s", s, serialDebug ? "on" : "off");
      break;
    case 23:  // TrxNet UDP port (read-only; set in oi3.cfg)
#ifdef FEATURE_NET
      snprintf(raw, sizeof(raw), "UDP %u", UdpPort);
#else
      strcpy(raw, "no net");
#endif
      break;
    case 24:  // PTT output enable (not persisted — always on after reboot)
      snprintf(raw, sizeof(raw), "PTTout%c%s", s, PttOutputEnable ? "on" : "off");
      break;
    case 25:  // remote CW key link (read-only); row 1 shows the played trace
#ifdef FEATURE_NET
      {
        uint8_t st = rkey_link_state();
        strcpy(raw, st == 2 ? "IPkey CONN" : st == 1 ? "IPkey DISC" : "IPkey off");
      }
#else
      strcpy(raw, "no net");
#endif
      break;
    case 26:  // RPI: WiFi / dBm / SSID / lock (read-only); row 1 in lcd_rpi_row1()
#ifdef FEATURE_NET
      rpi_format_row0(raw);
#else
      strcpy(raw, "no net");
#endif
      break;
    default:
      strcpy(raw, "?");
      break;
  }
  lcd_pad_left_align(raw, out, LCD_VALUE_WIDTH);

  // Item 15 input-debug overlay: 3 chars at cols 9..11 (right edge of the value
  // field, just left of the '|' separator) showing live input states. Upper =
  // active, lower = idle. F=FootSw (active=pressed/LOW=TX), I=Interlock (raw D2
  // level, active=LOW since INPUT_PULLUP idles HIGH, regardless of
  // InterlockEnable), P=PTT232 (active=HIGH=TX).
  if (idx == 15) {
    out[9]  = (digitalRead(FootSW)    == LOW)  ? 'F' : 'f';
    out[10] = (digitalRead(INTERLOCK) == LOW)  ? 'I' : 'i';
    out[11] = (digitalRead(PTT232)    == HIGH) ? 'P' : 'p';
  }
}

static void lcd_format_mode(char* out) {
  // CivValid → uppercase (rig authoritative). !CivValid → lowercase (local
  // fallback set via MODE button; boot default = CW). 0xFF retained for safety
  // even though boot init is 0x03.
  if (CivMode == 0xFF) { strcpy(out, "---"); return; }
  switch (CivMode) {
    case 0x00: strcpy(out, CivValid ? "LSB" : "lsb"); break;
    case 0x01: strcpy(out, CivValid ? "USB" : "usb"); break;
    case 0x02: strcpy(out, CivValid ? "AM " : "am "); break;
    case 0x03: strcpy(out, CivValid ? "CW " : "cw "); break;
    case 0x04: strcpy(out, CivValid ? "RTY" : "rty"); break;
    case 0x05: strcpy(out, CivValid ? "FM " : "fm "); break;
    case 0x07: strcpy(out, CivValid ? "CWR" : "cwr"); break;
    case 0x08: strcpy(out, CivValid ? "RTR" : "rtr"); break;
    default:   snprintf(out, LCD_MODE_WIDTH + 1, "?%02X", CivMode); break;
  }
}

static void lcd_render(bool force) {
  char value[LCD_VALUE_WIDTH + 1];
  char mode[LCD_MODE_WIDTH + 1];
  char sep;
  switch (lcdState) {
    case LCD_BROWSING: sep = '<'; break;
    case LCD_EDITING:  sep = '='; break;
    default:           // PINNED; ':' = Paddle2IP connected and rig in CW/CW-R
      sep = (rkey_link_state() == 2 && (CivMode == 0x03 || CivMode == 0x07)) ? ':' : '|';
      break;
  }

  lcd_format_value(lcdMenuIdx, value, lcdState);
  lcd_format_mode(mode);

  if (force || strcmp(value, lcdLastValue) != 0) {
    lcd.setCursor(0, 0);
    lcd.print(value);
    strcpy(lcdLastValue, value);
  }
  if (force || sep != lcdLastSep) {
    lcd.setCursor(LCD_SEP_COL, 0);
    lcd.print(sep);
    lcdLastSep = sep;
  }
  if (force || strcmp(mode, lcdLastMode) != 0) {
    lcd.setCursor(LCD_MODE_COL, 0);
    lcd.print(mode);
    strcpy(lcdLastMode, mode);
  }
}

void lcd_runtime_init() {
  Serial.println(F("--- LCD RUNTIME ---"));
  pinMode(MEM,  INPUT);
  pinMode(MENU, INPUT);
  pinMode(TONE, OUTPUT);

  uint8_t saved = EEPROM.read(LCD_EEPROM_IDX_ADDR);
  if (saved >= LCD_MENU_ITEM_COUNT) saved = 0;
  lcdMenuIdx = saved;
  lcdState   = LCD_PINNED;

  lcd.clear();
  lcd_render(true);
  lcdLastTickMs = millis();
}

// ----- Row-1 overlay (transient WPM display during PINNED DWN/UP edit) -----
// Briefly overrides KEYER's row-1 TX text with "WPM NN" so the operator gets
// immediate visual feedback when changing speed with the panel buttons.
// During the overlay window, keyer_lcd_putc drops chars from the LCD (TX
// stays on the air); on expiry, row 1 is cleared and KEYER's cursor reset.
static void lcd_row1_overlay_wpm() {
  char buf[17];
  snprintf(buf, sizeof(buf), "WPM %u", KeyerWpm);
  keyerRow1Locked = true;
  lcd.setCursor(0, 1);
  lcd.print(F("                "));
  lcd.setCursor(0, 1);
  lcd.print(buf);
  lcdRow1OverlayUntilMs = millis() + LCD_ROW1_OVERLAY_MS;
}

// ----- Editable-item helpers -----

static bool lcd_item_is_editable(uint8_t idx) {
  return idx == 7 || (idx >= 8 && idx <= 22) || idx == 24;
}

static void lcd_edit_ms_value(int* value, int delta) {
  int v = *value + ((delta > 0) ? 10 : -10);
  if (v < 0) v = 0;
  if (v > 9990) v = 9990;
  *value = v;
}
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
void loop() {
  ethernet_loop();
  trxnet_loop();
  netptt_service();
  rkey_loop();
  lptune_net_loop();
  cat_loop();
  ptt_loop();
  keyer_loop();
  lcd_loop();
}
