ok1hra/oi3/(commit log)

2026-06-13 some bugfix
    [oi3.cfg]
2026-06-23 Dual-PCB build: generate hex for both 3_141 and 3_1415
    Pinout in oi3.ino is now selected at compile time via -DPCB_REV_3_141 or
    -DPCB_REV_3_1415 (defaults to 3_1415 so the sketch still opens in the IDE).
    The older 3_141 board lacks the Ethernet install-detect pin, so the
    Ethernet + TrxNet stack is feature-gated behind FEATURE_NET and compiled
    out for 3_141 (33308 B vs 51352 B flash).
    - oi3.ino: #if/#elif pinout block (3_141 values from the original k3ng
    repo), LCD lcd_enable gate, FEATURE_NET gates around Ethernet/TrxNet
    sections, their setup/loop calls, and the LCD IP/peer menu items.
    - build.sh: compiles both revisions into out/<rev>/ and verifies the
    3_141 image is smaller (proves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
2026-10-18 M5Dial remote CW key sender + PC test tool
    - rkey_dial/: M5Dial firmware (iambic keyer on core 1 with 1 ms tick,
    LEDC sidetone, KEY/STATUS over UDP, round display, PCNT encoder,
    web config, NVS). build.sh checks rkey_proto.h is a verbatim copy.
    - test/rkey_test.py: send text to the OI3, attack checks (bad tag,
    replay, stale nonce), fake OI3 for the Dial, SipHash selftest.
    - rkey.ino: no IPAddress in rk_on_packet() signature (arduino-cli
    prototype placement broke the 3_1415 build); signed word-gap compare
    for mute release.
    - doc: Dial firmware, test tool, OI3 has a crystal.
